AYATAKA-WORKs/AliCe/README.md

# AliCe
This is my micromouse project in 2017 version.

alice
