AYATAKA-WORKs/AliCe/PCB/report.txt

情報: ネットリストファイル "/home/arch/Dropbox/AliCe関連/KiCAD/AliCe/AliCe.net"を読み込んでいます。

情報: コンポーネントとフットプリントの関連付けにリファレンスを使用

エラー:コンポーネント 'P1' フットプリント 'Pin_Header_Straight_2x03' はどのライブラリからも見つけることができませんでした。

エラー:コンポーネント 'P2' フットプリント 'Pin_Header_Straight_2x03' はどのライブラリからも見つけることができませんでした。

エラー:コンポーネント 'Q3' フットプリント 'Pin_Header_Straight_1x02' はどのライブラリからも見つけることができませんでした。

エラー:コンポーネント 'Q4' フットプリント 'Pin_Header_Straight_1x02' はどのライブラリからも見つけることができませんでした。

エラー:コンポーネント 'Q6' フットプリント 'Pin_Header_Straight_1x02' はどのライブラリからも見つけることができませんでした。

エラー:コンポーネント 'Q7' フットプリント 'Pin_Header_Straight_1x02' はどのライブラリからも見つけることができませんでした。

エラー:コンポーネント 'Q11' フットプリント 'Pin_Header_Straight_1x02' はどのライブラリからも見つけることができませんでした。

エラー:コンポーネント 'Q12' フットプリント 'Pin_Header_Straight_1x02' はどのライブラリからも見つけることができませんでした。

エラー:コンポーネント 'M1' フットプリント 'Pin_Header_Straight_1x02' はどのライブラリからも見つけることができませんでした。

エラー:コンポーネント 'D10' フットプリント 'LED-3MM' はどのライブラリからも見つけることができませんでした。

エラー:コンポーネント 'D8' フットプリント 'LED-3MM' はどのライブラリからも見つけることができませんでした。

エラー:コンポーネント 'D7' フットプリント 'LED-3MM' はどのライブラリからも見つけることができませんでした。

エラー:コンポーネント 'D13' フットプリント 'LED-3MM' はどのライブラリからも見つけることができませんでした。

エラー:コンポーネント 'D14' フットプリント 'LED-3MM' はどのライブラリからも見つけることができませんでした。

エラー:コンポーネント 'D9' フットプリント 'LED-3MM' はどのライブラリからも見つけることができませんでした。

情報: ネットリストよりコンポーネントとフットプリントをチェックしています "12.5MHz1:/58FD5DD5:mylib:CRY_4-SMD"。

情報: ネットリストよりコンポーネントとフットプリントをチェックしています "BT1:/56DA9B61:mylib:pin_con_2mm"。

情報: ネットリストよりコンポーネントとフットプリントをチェックしています "C1:/57F95481:Capacitors_SMD:C_0603_HandSoldering"。

情報: ネットリストよりコンポーネントとフットプリントをチェックしています "C2:/58FD1E7C:Capacitors_SMD:C_0603_HandSoldering"。

情報: ネットリストよりコンポーネントとフットプリントをチェックしています "C3:/57FA3C69:Capacitors_SMD:C_0603_HandSoldering"。

情報: ネットリストよりコンポーネントとフットプリントをチェックしています "C4:/57FA5265:Capacitors_SMD:C_0603_HandSoldering"。

情報: ネットリストよりコンポーネントとフットプリントをチェックしています "C5:/56ED1ADF:Capacitors_SMD:C_0603_HandSoldering"。

情報: ネットリストよりコンポーネントとフットプリントをチェックしています "C6:/56ED34AF:Capacitors_SMD:C_0603_HandSoldering"。

情報: ネットリストよりコンポーネントとフットプリントをチェックしています "C7:/56ED9063:Capacitors_SMD:C_0603_HandSoldering"。

情報: ネットリストよりコンポーネントとフットプリントをチェックしています "C8:/56ED9089:Capacitors_SMD:C_0603_HandSoldering"。

情報: ネットリストよりコンポーネントとフットプリントをチェックしています "C9:/57C16474:Capacitors_SMD:C_0603_HandSoldering"。

情報: ネットリストよりコンポーネントとフットプリントをチェックしています "C10:/57C1623D:Capacitors_SMD:C_0603_HandSoldering"。

情報: ネットリストよりコンポーネントとフットプリントをチェックしています "C11:/57BD8294:Capacitors_SMD:C_0603_HandSoldering"。

情報: ネットリストよりコンポーネントとフットプリントをチェックしています "C12:/57BD9CC2:Capacitors_SMD:C_0603_HandSoldering"。

情報: ネットリストよりコンポーネントとフットプリントをチェックしています "C13:/57BD9E56:Capacitors_SMD:C_0603_HandSoldering"。

情報: ネットリストよりコンポーネントとフットプリントをチェックしています "C14:/57BD8D6D:Capacitors_SMD:C_0603_HandSoldering"。

情報: ネットリストよりコンポーネントとフットプリントをチェックしています "C15:/57BF9855:Capacitors_SMD:C_0603_HandSoldering"。

情報: ネットリストよりコンポーネントとフットプリントをチェックしています "C16:/58FCB98C:Capacitors_SMD:C_0603_HandSoldering"。

情報: ネットリストよりコンポーネントとフットプリントをチェックしています "C17:/58FCD29C:Capacitors_SMD:C_0603_HandSoldering"。

情報: ネットリストよりコンポーネントとフットプリントをチェックしています "C18:/58FCB8AB:Capacitors_SMD:C_0603_HandSoldering"。

情報: ネットリストよりコンポーネントとフットプリントをチェックしています "C19:/58FCD375:Capacitors_SMD:C_0603_HandSoldering"。

情報: ネットリストよりコンポーネントとフットプリントをチェックしています "C20:/56EEBB11:Capacitors_SMD:C_0603_HandSoldering"。

情報: ネットリストよりコンポーネントとフットプリントをチェックしています "C21:/56DD16D7:Capacitors_SMD:C_0603_HandSoldering"。

情報: ネットリストよりコンポーネントとフットプリントをチェックしています "C22:/56DD3248:Capacitors_SMD:C_0603_HandSoldering"。

情報: ネットリストよりコンポーネントとフットプリントをチェックしています "C23:/56DD46DA:Capacitors_SMD:C_0603_HandSoldering"。

情報: ネットリストよりコンポーネントとフットプリントをチェックしています "C24:/56EEC4A7:Capacitors_SMD:C_0603_HandSoldering"。

情報: ネットリストよりコンポーネントとフットプリントをチェックしています "C25:/59092574:Capacitors_SMD:C_0603_HandSoldering"。

情報: ネットリストよりコンポーネントとフットプリントをチェックしています "C26:/57E61AE8:Capacitors_SMD:C_0603_HandSoldering"。

情報: ネットリストよりコンポーネントとフットプリントをチェックしています "C27:/57DFF7CD:Capacitors_SMD:C_0603_HandSoldering"。

情報: ネットリストよりコンポーネントとフットプリントをチェックしています "C28:/59093594:Capacitors_SMD:C_0603_HandSoldering"。

情報: ネットリストよりコンポーネントとフットプリントをチェックしています "C29:/5909628D:Capacitors_SMD:C_0603_HandSoldering"。

情報: ネットリストよりコンポーネントとフットプリントをチェックしています "C30:/59097E78:Capacitors_SMD:C_0603_HandSoldering"。

情報: ネットリストよりコンポーネントとフットプリントをチェックしています "C31:/590B0F99:Capacitors_SMD:C_0603_HandSoldering"。

情報: ネットリストよりコンポーネントとフットプリントをチェックしています "C32:/590B09A6:Capacitors_SMD:C_0603_HandSoldering"。

情報: ネットリストよりコンポーネントとフットプリントをチェックしています "C33:/592AC7DC:Capacitors_SMD:C_0603_HandSoldering"。

情報: ネットリストよりコンポーネントとフットプリントをチェックしています "D1:/570CE2A1:LEDs:LED_0603"。

情報: ネットリストよりコンポーネントとフットプリントをチェックしています "D2:/570CF0E6:LEDs:LED_0603"。

情報: ネットリストよりコンポーネントとフットプリントをチェックしています "D3:/570CF27D:LEDs:LED_0603"。

情報: ネットリストよりコンポーネントとフットプリントをチェックしています "D4:/570CF283:LEDs:LED_0603"。

情報: ネットリストよりコンポーネントとフットプリントをチェックしています "D5:/570D2EF1:LEDs:LED_0603"。

情報: ネットリストよりコンポーネントとフットプリントをチェックしています "D6:/570D2EF7:LEDs:LED_0603"。

情報: ネットリストよりコンポーネントとフットプリントをチェックしています "D7:/56EE83C4:LEDs:LED-3MM"。

エラー:新規コンポーネント "D7:/56EE83C4" を作成できませんでした。これは フットプリント  "LEDs:LED-3MM" が不正であることに起因します。

情報: ネットリストよりコンポーネントとフットプリントをチェックしています "D8:/56EEA527:LEDs:LED-3MM"。

エラー:新規コンポーネント "D8:/56EEA527" を作成できませんでした。これは フットプリント  "LEDs:LED-3MM" が不正であることに起因します。

情報: ネットリストよりコンポーネントとフットプリントをチェックしています "D9:/56EEC47E:LEDs:LED-3MM"。

エラー:新規コンポーネント "D9:/56EEC47E" を作成できませんでした。これは フットプリント  "LEDs:LED-3MM" が不正であることに起因します。

情報: ネットリストよりコンポーネントとフットプリントをチェックしています "D10:/56EEC484:LEDs:LED-3MM"。

エラー:新規コンポーネント "D10:/56EEC484" を作成できませんでした。これは フットプリント  "LEDs:LED-3MM" が不正であることに起因します。

情報: ネットリストよりコンポーネントとフットプリントをチェックしています "D11:/57DA538B:LEDs:LED_0603"。

情報: ネットリストよりコンポーネントとフットプリントをチェックしています "D12:/57FED15E:mylib:SOD-128"。

情報: ネットリストよりコンポーネントとフットプリントをチェックしています "D13:/592AC7BE:LEDs:LED-3MM"。

エラー:新規コンポーネント "D13:/592AC7BE" を作成できませんでした。これは フットプリント  "LEDs:LED-3MM" が不正であることに起因します。

情報: ネットリストよりコンポーネントとフットプリントをチェックしています "D14:/592AC7C4:LEDs:LED-3MM"。

エラー:新規コンポーネント "D14:/592AC7C4" を作成できませんでした。これは フットプリント  "LEDs:LED-3MM" が不正であることに起因します。

情報: ネットリストよりコンポーネントとフットプリントをチェックしています "IC1:/57C93978:Housings_SSOP:SSOP-16_4.4x5.2mm_Pitch0.65mm"。

情報: ネットリストよりコンポーネントとフットプリントをチェックしています "IC2:/57C928F6:Housings_SSOP:SSOP-16_4.4x5.2mm_Pitch0.65mm"。

情報: ネットリストよりコンポーネントとフットプリントをチェックしています "IC3:/58FC91FC:mylib:SSOP5-P-0.95"。

情報: ネットリストよりコンポーネントとフットプリントをチェックしています "IC4:/58FC95D9:mylib:SSOP5-P-0.95"。

情報: ネットリストよりコンポーネントとフットプリントをチェックしています "IC6:/56DD266B:Housings_DFN_QFN:QFN-24-1EP_4x4mm_Pitch0.5mm"。

情報: ネットリストよりコンポーネントとフットプリントをチェックしています "M1:/57E10E83:Pin_Headers:Pin_Header_Straight_1x02"。

エラー:新規コンポーネント "M1:/57E10E83" を作成できませんでした。これは フットプリント  "Pin_Headers:Pin_Header_Straight_1x02" が不正であることに起因します。

情報: ネットリストよりコンポーネントとフットプリントをチェックしています "P1:/56ED90B1:Pin_Headers:Pin_Header_Straight_2x03"。

エラー:新規コンポーネント "P1:/56ED90B1" を作成できませんでした。これは フットプリント  "Pin_Headers:Pin_Header_Straight_2x03" が不正であることに起因します。

情報: ネットリストよりコンポーネントとフットプリントをチェックしています "P2:/56ED6942:Pin_Headers:Pin_Header_Straight_2x03"。

エラー:新規コンポーネント "P2:/56ED6942" を作成できませんでした。これは フットプリント  "Pin_Headers:Pin_Header_Straight_2x03" が不正であることに起因します。

情報: ネットリストよりコンポーネントとフットプリントをチェックしています "P3:/58FD90F5:Pin_Headers:Pin_Header_Straight_1x04_Pitch2.54mm"。

情報: ネットリストよりコンポーネントとフットプリントをチェックしています "Q1:/57E1864D:mylib:SOT-363"。

情報: ネットリストよりコンポーネントとフットプリントをチェックしています "Q2:/57ED4785:TO_SOT_Packages_SMD:SOT-23"。

情報: ネットリストよりコンポーネントとフットプリントをチェックしています "Q3:/57E13A56:Pin_Headers:Pin_Header_Straight_1x02"。

エラー:新規コンポーネント "Q3:/57E13A56" を作成できませんでした。これは フットプリント  "Pin_Headers:Pin_Header_Straight_1x02" が不正であることに起因します。

情報: ネットリストよりコンポーネントとフットプリントをチェックしています "Q4:/57E13975:Pin_Headers:Pin_Header_Straight_1x02"。

エラー:新規コンポーネント "Q4:/57E13975" を作成できませんでした。これは フットプリント  "Pin_Headers:Pin_Header_Straight_1x02" が不正であることに起因します。

情報: ネットリストよりコンポーネントとフットプリントをチェックしています "Q5:/56EEB1DF:mylib:SOT-723"。

情報: ネットリストよりコンポーネントとフットプリントをチェックしています "Q6:/57E13892:Pin_Headers:Pin_Header_Straight_1x02"。

エラー:新規コンポーネント "Q6:/57E13892" を作成できませんでした。これは フットプリント  "Pin_Headers:Pin_Header_Straight_1x02" が不正であることに起因します。

情報: ネットリストよりコンポーネントとフットプリントをチェックしています "Q7:/57E10C8B:Pin_Headers:Pin_Header_Straight_1x02"。

エラー:新規コンポーネント "Q7:/57E10C8B" を作成できませんでした。これは フットプリント  "Pin_Headers:Pin_Header_Straight_1x02" が不正であることに起因します。

情報: ネットリストよりコンポーネントとフットプリントをチェックしています "Q8:/56EEC490:mylib:SOT-723"。

情報: ネットリストよりコンポーネントとフットプリントをチェックしています "Q9:/57FEC28D:TO_SOT_Packages_SMD:SOT-23"。

情報: ネットリストよりコンポーネントとフットプリントをチェックしています "Q10:/592AC7D0:mylib:SOT-723"。

情報: ネットリストよりコンポーネントとフットプリントをチェックしています "Q11:/5935AB5D:Pin_Headers:Pin_Header_Straight_1x02"。

エラー:新規コンポーネント "Q11:/5935AB5D" を作成できませんでした。これは フットプリント  "Pin_Headers:Pin_Header_Straight_1x02" が不正であることに起因します。

情報: ネットリストよりコンポーネントとフットプリントをチェックしています "Q12:/5935AC78:Pin_Headers:Pin_Header_Straight_1x02"。

エラー:新規コンポーネント "Q12:/5935AC78" を作成できませんでした。これは フットプリント  "Pin_Headers:Pin_Header_Straight_1x02" が不正であることに起因します。

情報: ネットリストよりコンポーネントとフットプリントをチェックしています "R1:/570CF2BC:mylib:R_0402_HandSoldering"。

情報: ネットリストよりコンポーネントとフットプリントをチェックしています "R2:/570CF3B4:mylib:R_0402_HandSoldering"。

情報: ネットリストよりコンポーネントとフットプリントをチェックしています "R3:/570CF46E:mylib:R_0402_HandSoldering"。

情報: ネットリストよりコンポーネントとフットプリントをチェックしています "R4:/570CF474:mylib:R_0402_HandSoldering"。

情報: ネットリストよりコンポーネントとフットプリントをチェックしています "R5:/570D2EFD:mylib:R_0402_HandSoldering"。

情報: ネットリストよりコンポーネントとフットプリントをチェックしています "R6:/570D2F03:mylib:R_0402_HandSoldering"。

情報: ネットリストよりコンポーネントとフットプリントをチェックしています "R7:/572A3DC4:mylib:R_0402_HandSoldering"。

情報: ネットリストよりコンポーネントとフットプリントをチェックしています "R8:/572A516A:mylib:R_0402_HandSoldering"。

情報: ネットリストよりコンポーネントとフットプリントをチェックしています "R9:/56DAA956:mylib:R_0402_HandSoldering"。

情報: ネットリストよりコンポーネントとフットプリントをチェックしています "R10:/5712AFBF:mylib:R_0402_HandSoldering"。

情報: ネットリストよりコンポーネントとフットプリントをチェックしています "R11:/57BDC9FF:mylib:R_0402_HandSoldering"。

情報: ネットリストよりコンポーネントとフットプリントをチェックしています "R12:/570FAF51:mylib:R_0402_HandSoldering"。

情報: ネットリストよりコンポーネントとフットプリントをチェックしています "R13:/570FC62C:mylib:R_0402_HandSoldering"。

情報: ネットリストよりコンポーネントとフットプリントをチェックしています "R14:/57BDFF90:mylib:R_0402_HandSoldering"。

情報: ネットリストよりコンポーネントとフットプリントをチェックしています "R15:/57287DB5:mylib:R_0402_HandSoldering"。

情報: ネットリストよりコンポーネントとフットプリントをチェックしています "R16:/570C46C4:mylib:R_0402_HandSoldering"。

情報: ネットリストよりコンポーネントとフットプリントをチェックしています "R17:/56EEB403:mylib:R_0402_HandSoldering"。

情報: ネットリストよりコンポーネントとフットプリントをチェックしています "R18:/570C4D8F:mylib:R_0402_HandSoldering"。

情報: ネットリストよりコンポーネントとフットプリントをチェックしています "R19:/56EEB188:mylib:R_0402_HandSoldering"。

情報: ネットリストよりコンポーネントとフットプリントをチェックしています "R20:/570C4E91:mylib:R_0402_HandSoldering"。

情報: ネットリストよりコンポーネントとフットプリントをチェックしています "R21:/570C4E9D:mylib:R_0402_HandSoldering"。

情報: ネットリストよりコンポーネントとフットプリントをチェックしています "R22:/56EEC496:mylib:R_0402_HandSoldering"。

情報: ネットリストよりコンポーネントとフットプリントをチェックしています "R23:/56EEC48A:mylib:R_0402_HandSoldering"。

情報: ネットリストよりコンポーネントとフットプリントをチェックしています "R24:/57C4CFED:mylib:check_2pin_1.6mm"。

情報: ネットリストよりコンポーネントとフットプリントをチェックしています "R25:/57C4D78C:mylib:check_2pin_1.6mm"。

情報: ネットリストよりコンポーネントとフットプリントをチェックしています "R26:/57D6A2AA:mylib:R_0402_HandSoldering"。

情報: ネットリストよりコンポーネントとフットプリントをチェックしています "R27:/590A9E03:mylib:R_0402_HandSoldering"。

情報: ネットリストよりコンポーネントとフットプリントをチェックしています "R28:/57E1098C:mylib:R_0402_HandSoldering"。

情報: ネットリストよりコンポーネントとフットプリントをチェックしています "R29:/57DF343D:mylib:R_0402_HandSoldering"。

情報: ネットリストよりコンポーネントとフットプリントをチェックしています "R30:/57E01173:mylib:R_0402_HandSoldering"。

情報: ネットリストよりコンポーネントとフットプリントをチェックしています "R31:/57DA477E:mylib:R_0402_HandSoldering"。

情報: ネットリストよりコンポーネントとフットプリントをチェックしています "R32:/590A9906:mylib:R_0402_HandSoldering"。

情報: ネットリストよりコンポーネントとフットプリントをチェックしています "R33:/590B07FD:mylib:R_0402_HandSoldering"。

情報: ネットリストよりコンポーネントとフットプリントをチェックしています "R34:/592AC7D6:mylib:R_0402_HandSoldering"。

情報: ネットリストよりコンポーネントとフットプリントをチェックしています "R35:/592AC7CA:mylib:R_0402_HandSoldering"。

情報: ネットリストよりコンポーネントとフットプリントをチェックしています "R36:/5935BA0F:mylib:R_0402_HandSoldering"。

情報: ネットリストよりコンポーネントとフットプリントをチェックしています "R37:/5935B88E:mylib:R_0402_HandSoldering"。

情報: ネットリストよりコンポーネントとフットプリントをチェックしています "SP1:/57BEC4ED:mylib:UGCT7525AN4"。

情報: ネットリストよりコンポーネントとフットプリントをチェックしています "SW1:/5906DA65:mylib:JS203011AQN"。

情報: ネットリストよりコンポーネントとフットプリントをチェックしています "SW2:/57BD595B:mylib:PTS810"。

情報: ネットリストよりコンポーネントとフットプリントをチェックしています "SW4:/57E012DE:mylib:PTS810"。

情報: ネットリストよりコンポーネントとフットプリントをチェックしています "U1:/57C917C3:Housings_QFP:LQFP-64_10x10mm_Pitch0.5mm"。

情報: ネットリストよりコンポーネントとフットプリントをチェックしています "U2:/5908FD99:mylib:ER-OLED010-1"。
