AYATAKA-WORKs/AliCe/3DCAD/シルク案①_s_anti.png

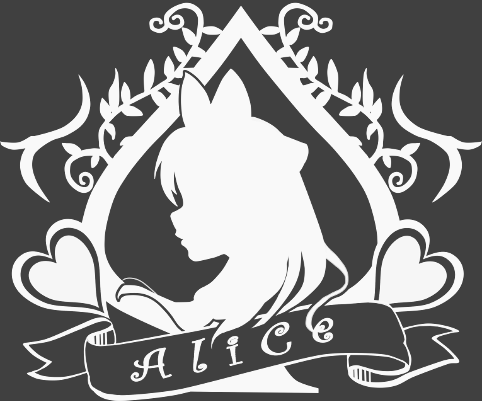
3DCAD/シルク案①_s_anti.png
