AYATAKA-WORKs/AliCe/PCB/PWRベタ_表.PNG

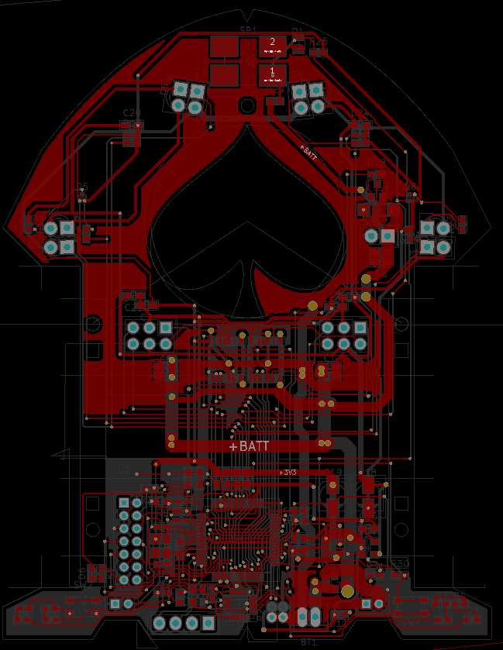
PCB/PWRベタ_表.PNG
