AYATAKA-WORKs/AliCe/PCB/ベタ_表.PNG

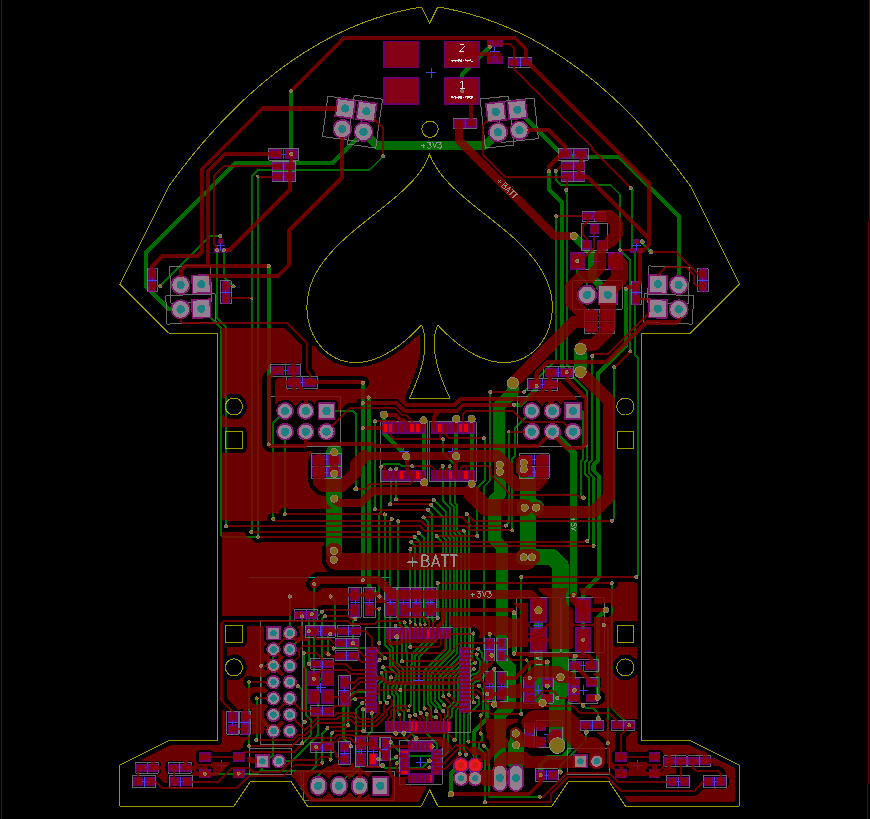
PCB/ベタ_表.PNG
