AYATAKA-WORKs/AliCe/PCB/ベタ_裏.PNG

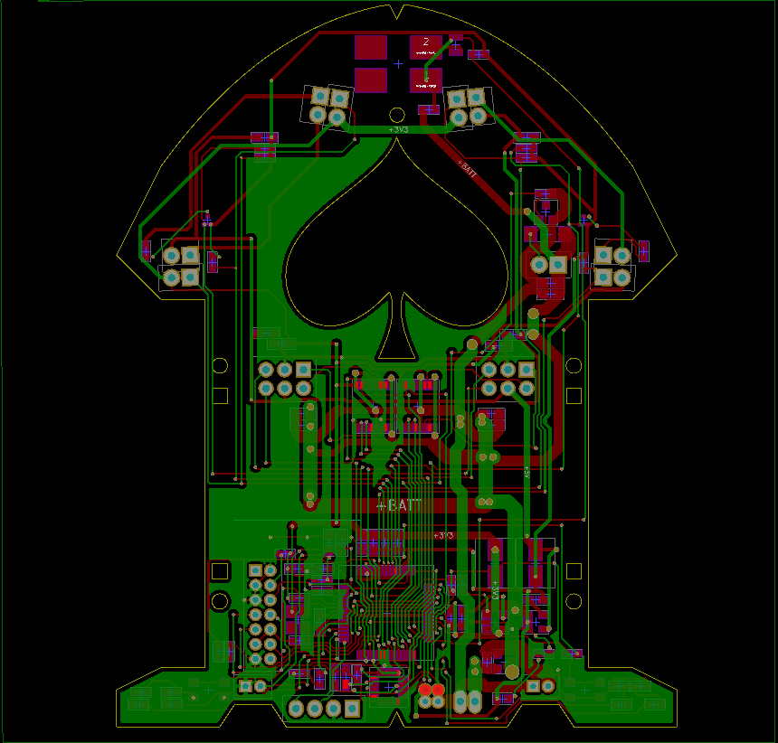
PCB/ベタ_裏.PNG
