AYATAKA-WORKs/AliCe/PCB/部品表.docx

Reference | Value | Footprint
BT1 | Battery | mylib:pin_con_2mm | □
C01 | 47u | Capacitors_SMD:C_0603_HandSoldering | □
C02 | 47u | Capacitors_SMD:C_0603_HandSoldering | □
C03 | 10u | Capacitors_SMD:C_0603_HandSoldering | □
C04 | 10u | Capacitors_SMD:C_0603_HandSoldering | □
C05 | 0.1u | Capacitors_SMD:C_0603_HandSoldering | □
C06 | 0.1u | Capacitors_SMD:C_0603_HandSoldering | □
C07 | 0.1u | Capacitors_SMD:C_0603_HandSoldering | □
C08 | 0.1u | Capacitors_SMD:C_0603_HandSoldering | □
C09 | 0.1u | Capacitors_SMD:C_0603_HandSoldering | □
C10 | 0.1u | Capacitors_SMD:C_0603_HandSoldering | □
C11 | 0.1u | Capacitors_SMD:C_0603_HandSoldering | □
C12 | 8p | Capacitors_SMD:C_0603_HandSoldering | □
C13 | 8p | Capacitors_SMD:C_0603_HandSoldering | □
C14 | 0.1u | Capacitors_SMD:C_0603_HandSoldering | □
C15 | 0.1u | Capacitors_SMD:C_0603_HandSoldering | □
C16 | 470p | Capacitors_SMD:C_0603_HandSoldering | □
C17 | 470p | Capacitors_SMD:C_0603_HandSoldering | □
C18 | 2.2u | mylib:c_elec_4x3.0 | □
C19 | 2.2u | mylib:c_elec_4x3.0 | □
C20 | 4.7u | Capacitors_SMD:C_0603_HandSoldering | □
C21 | 2.2n | Capacitors_SMD:C_0603_HandSoldering | □
C22 | 0.1u | Capacitors_SMD:C_0603_HandSoldering | □
C23 | 0.1u | Capacitors_SMD:C_0603_HandSoldering | □
C24 | 4.7u | Capacitors_SMD:C_0603_HandSoldering | □
C25 | 47u | Capacitors_SMD:C_0603_HandSoldering | □
C26 | 0.1u | Capacitors_SMD:C_0603_HandSoldering | □
C27 | 0.1u | Capacitors_SMD:C_0603_HandSoldering | □
D01 | LED | LEDs:LED_0603 | □
D02 | LED | LEDs:LED_0603 | □
D03 | LED | LEDs:LED_0603 | □
D04 | LED | LEDs:LED_0603 | □
D05 | LED | LEDs:LED_0603 | □
D06 | LED | LEDs:LED_0603 | □
D07 | SFH4550 | LEDs:LED-3MM | □
D08 | SFH4550 | LEDs:LED-3MM | □
D09 | SFH4550 | LEDs:LED-3MM | □
D10 | SFH4550 | LEDs:LED-3MM | □
D11 | LED | LEDs:LED_0603 | □
D12 | Schottky | mylib:SOD-128 | □
IC1 | TB6614FNG | Housings_SSOP:SSOP-16_4.4x5.2mm_Pitch0.65mm | □
IC2 | TB6614FNG | Housings_SSOP:SSOP-16_4.4x5.2mm_Pitch0.65mm | □
IC4 | MIC5129 | TO_SOT_Packages_SMD:SOT-23-5 | □
IC5 | MIC5129 | TO_SOT_Packages_SMD:SOT-23-5 | □
IC6 | MPU-6000 | Housings_DFN_QFN:QFN-24-1EP_4x4mm_Pitch0.5mm | □
M1 | DC_MOTOR | Pin_Headers:Pin_Header_Straight_1x02 | □
P1 | CONN_02X03 | Pin_Headers:Pin_Header_Straight_2x03 | □
P2 | CONN_02X03 | Pin_Headers:Pin_Header_Straight_2x03 | □
Q1 | NMSD200B01 | mylib:SOT-363 | □
Q2 | SSM3J328RLFCT | TO_SOT_Packages_SMD:SOT-23 | □
Q3 | ST-1KL3A | Pin_Headers:Pin_Header_Straight_1x02 | □
Q4 | ST-1KL3A | Pin_Headers:Pin_Header_Straight_1x02 | □
Q5 | RUM003N02 | mylib:SOT-723 | □
Q6 | ST-1KL3A | Pin_Headers:Pin_Header_Straight_1x02 | □
Q7 | ST-1KL3A | Pin_Headers:Pin_Header_Straight_1x02 | □
Q8 | RUM003N02 | mylib:SOT-723 | □
Q9 | SSM3K329R | TO_SOT_Packages_SMD:SOT-23 | □
R01 | 100 | mylib:R_0402_HandSoldering | □
R02 | 100 | mylib:R_0402_HandSoldering | □
R03 | 100 | mylib:R_0402_HandSoldering | □
R04 | 100 | mylib:R_0402_HandSoldering | □
R05 | 100 | mylib:R_0402_HandSoldering | □
R06 | 100 | mylib:R_0402_HandSoldering | □
R07 | 10k | mylib:R_0402_HandSoldering | □
R08 | 10k | mylib:R_0402_HandSoldering | □
R09 | 10k | mylib:R_0402_HandSoldering | □
R10 | 10k | mylib:R_0402_HandSoldering | □
R11 | 10k | mylib:R_0402_HandSoldering | □
R12 | R | mylib:R_0402_HandSoldering | □
R13 | R | mylib:R_0402_HandSoldering | □
R14 | 10k | mylib:R_0402_HandSoldering | □
R15 | 10k | mylib:R_0402_HandSoldering | □
R16 | 1k | mylib:R_0402_HandSoldering | □
R17 | 10k | mylib:R_0402_HandSoldering | □
R18 | 1k | mylib:R_0402_HandSoldering | □
R19 | 20 | mylib:R_0402_HandSoldering | □
R20 | 1k | mylib:R_0402_HandSoldering | □
R21 | 1k | mylib:R_0402_HandSoldering | □
R22 | 10k | mylib:R_0402_HandSoldering | □
R23 | 20 | mylib:R_0402_HandSoldering | □
R24 | 0 | mylib:check_2pin_1.6mm | □
R25 | 0 | mylib:check_2pin_1.6mm | □
R26 | 47k | mylib:R_0402_HandSoldering | □
R27 | 100 | mylib:R_0402_HandSoldering | □
R28 | 47k | mylib:R_0402_HandSoldering | □
R29 | 10 | mylib:R_0402_HandSoldering | □
R30 | 10k | mylib:R_0402_HandSoldering | □
R31 | 1k | mylib:R_0402_HandSoldering | □
SP1 | UGCT7525NA4 | mylib:UGCT7525AN4 | □
SW2 | PUSH_SW_s | mylib:PTS810 | □
SW3 | SPST | Pin_Headers:Pin_Header_Straight_1x02_Pitch2.00mm | □
SW4 | PUSH_SW_s | mylib:PTS810 | □
U1 | RX631 | Housings_QFP:LQFP-64_10x10mm_Pitch0.5mm | □
U2 | Z144SN005 | Pin_Headers:Pin_Header_Straight_2x07_Pitch2.00mm | □
