AYATAKA-WORKs/AliCe/3DCAD/kiban.dxf

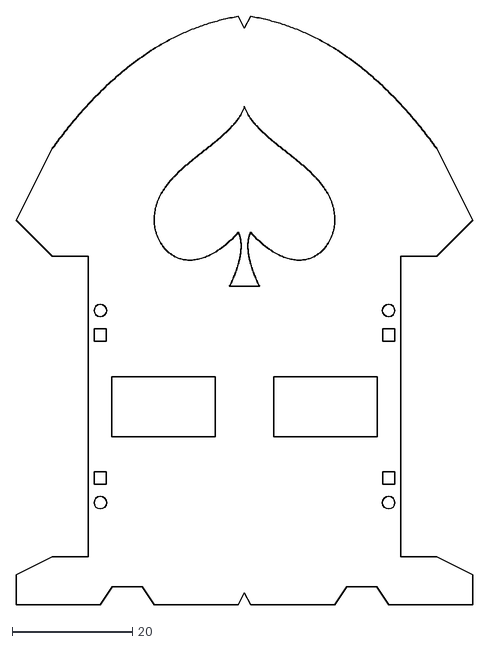
[picture p5: CAD file, 2018-06-24]
3DCAD/kiban.dxf
76.0 x 98.0
