AYATAKA-WORKs/AliCe/PCB/kiban_correction.dxf

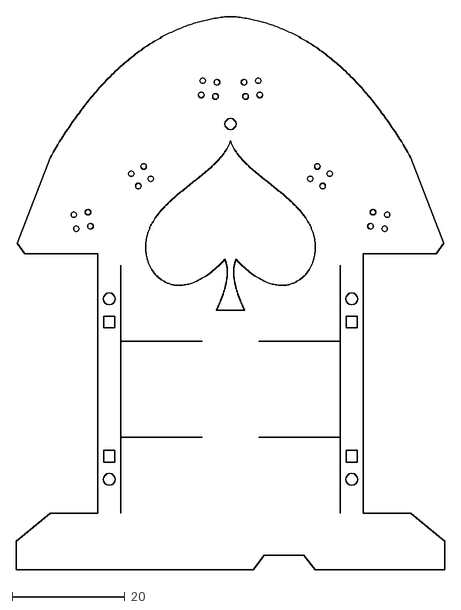
[picture p6: CAD file, 2018-06-24]
PCB/kiban_correction.dxf
76.0 x 98.1
