AYATAKA-WORKs/AliCe/3DCAD/m_mount_side.dxf

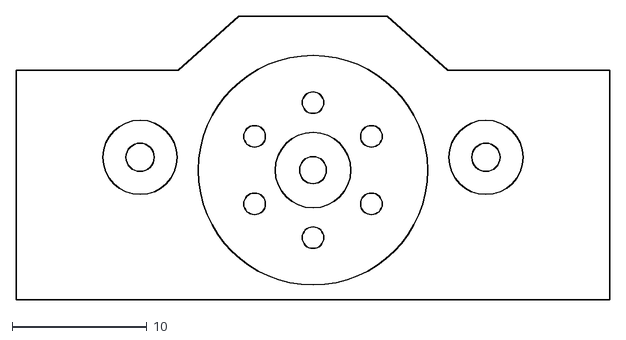
[picture p7: CAD file, 2018-06-24]
3DCAD/m_mount_side.dxf
44.0 x 21.0
