AYATAKA-WORKs/AliCe/PCB/kiban.dxf

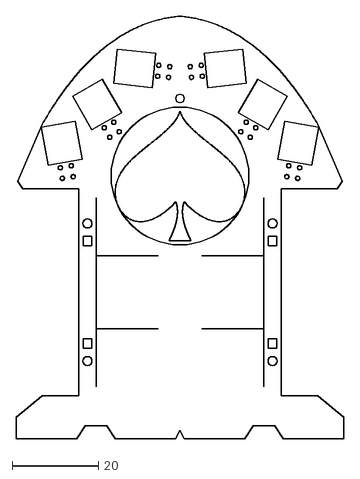
[picture p8: CAD file, 2018-06-24]
PCB/kiban.dxf
76.0 x 98.1
