AYATAKA-WORKs/AliCe/3DCAD/Alice.stl

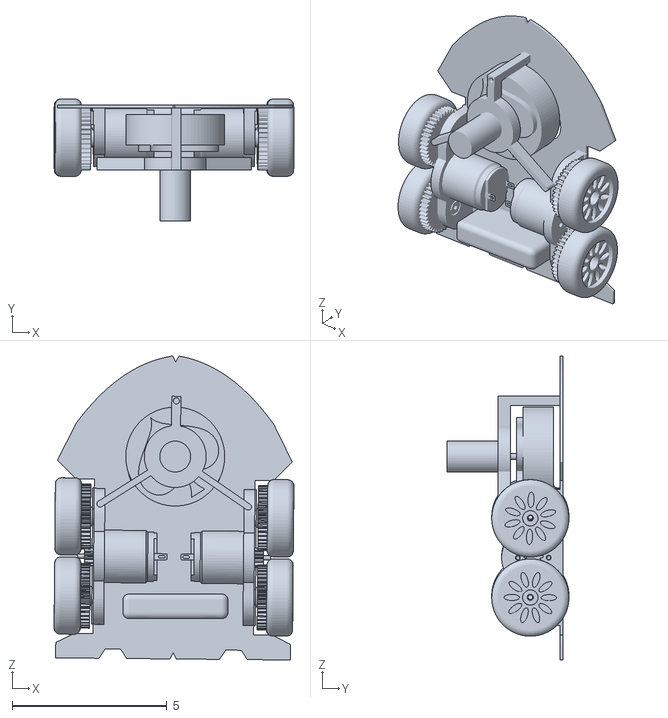
[picture p9: CAD file, 2018-06-24]
3DCAD/Alice.stl
7.76 x 3.94 x 9.83
