AYATAKA-WORKs/AliCe/PCB/LCD_kiban.dxf

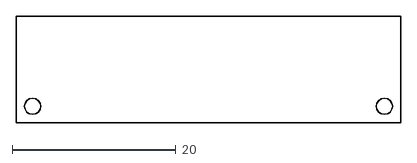
[picture p10: CAD file, 2018-06-24]
PCB/LCD_kiban.dxf
47.0 x 13.0
