AYATAKA-WORKs/AliCe/3DCAD/m_mount_down.dxf

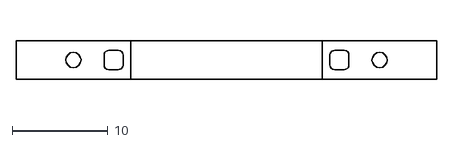
[picture p11: CAD file, 2018-06-24]
3DCAD/m_mount_down.dxf
44.0 x 4.00
