AYATAKA-WORKs/AliCe/3DCAD/m_mount_up.dxf

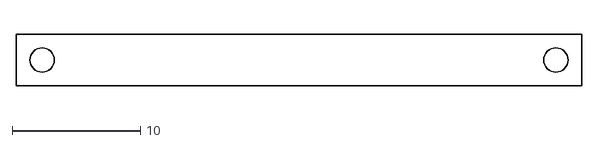
[picture p12: CAD file, 2018-06-24]
3DCAD/m_mount_up.dxf
44.0 x 4.00
