AYATAKA-WORKs/AliCe/3DCAD/k_mount.dxf

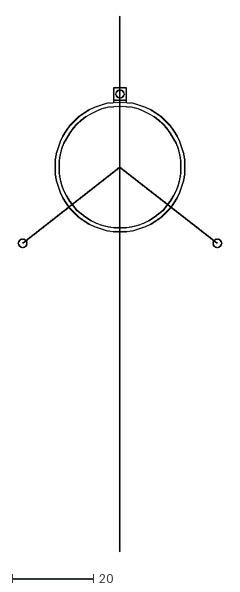
[picture p13: CAD file, 2018-06-24]
3DCAD/k_mount.dxf
50.1 x 132.1
