AYATAKA-WORKs/AliCe/3DCAD/spade.dxf

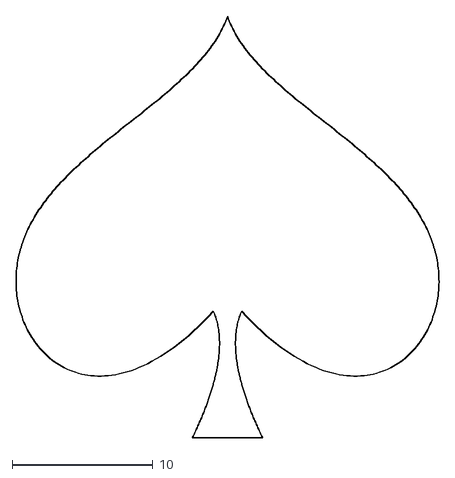
[picture p14: CAD file, 2018-06-24]
3DCAD/spade.dxf
30.1 x 30.0
