AYATAKA-WORKs/AliCe/(list of files, cad)

Other CAD files:
Src/AliCe/HardwareDebug/generate/hwsetup.obj
Src/AliCe/HardwareDebug/src/gyro.obj
Src/AliCe/HardwareDebug/generate/resetprg.obj
Src/AliCe/HardwareDebug/src/Control.obj
Src/AliCe/HardwareDebug/generate/intprg.obj
Src/AliCe/HardwareDebug/src/Maze.obj
Src/AliCe/HardwareDebug/generate/sbrk.obj
Src/AliCe/HardwareDebug/src/Motor.obj
Src/AliCe/HardwareDebug/generate/vecttbl.obj
Src/AliCe/HardwareDebug/src/interrupt.obj
Src/AliCe/HardwareDebug/generate/dbsct.obj
Src/AliCe/HardwareDebug/src/parameter.obj
Src/AliCe/HardwareDebug/src/initClock.obj
Src/AliCe/HardwareDebug/src/speaker_func.obj
Src/AliCe/HardwareDebug/src/var.obj
Src/AliCe/HardwareDebug/src/initNonExistentPort.obj
Src/AliCe/HardwareDebug/src/run.obj
Src/AliCe/HardwareDebug/src/Encoder.obj
Src/AliCe/HardwareDebug/src/PhotoSensor.obj
Src/AliCe/HardwareDebug/src/initSetting.obj
Src/AliCe/HardwareDebug/src/initStopModule.obj
Src/AliCe/HardwareDebug/src/Log.obj
Src/AliCe/HardwareDebug/src/AliCe.obj
Src/AliCe/HardwareDebug/src/Serial.obj
3DCAD/1717.ipt
3DCAD/AliCe_Motor.iam
3DCAD/AliCe_Motor/デザイン アクセラレータ/OldVersions/平歯車21.0002.ipt
3DCAD/AliCe_Motor/デザイン アクセラレータ/平歯車1.iam
3DCAD/AliCe_Motor/デザイン アクセラレータ/平歯車11.ipt
3DCAD/AliCe_Motor/デザイン アクセラレータ/平歯車14.ipt
3DCAD/AliCe_Motor/デザイン アクセラレータ/平歯車21.ipt
3DCAD/AliCe_Motor/デザイン アクセラレータ/平歯車22.ipt
3DCAD/AliCe_Motor_R.iam
3DCAD/AliCe_Motor_l.iam
3DCAD/AliCe_TFT.iam
3DCAD/Alice._new.iam
3DCAD/Alice.iam
3DCAD/Assembly1.iam
3DCAD/Back.ipt
3DCAD/LCD.iam
3DCAD/LED.ipt
3DCAD/LED_mount.ipt
3DCAD/LiPo.ipt
3DCAD/New_Alice.iam
3DCAD/OldVersions/1717.0006.ipt
3DCAD/OldVersions/AliCe_Motor.0047.iam
3DCAD/OldVersions/AliCe_Motor_l.0001.iam
3DCAD/OldVersions/AliCe_TFT.0002.iam
3DCAD/OldVersions/Alice.0032.iam
3DCAD/OldVersions/Alice._new.0044.iam
3DCAD/OldVersions/Assembly1.0019.iam
3DCAD/OldVersions/Back.0001.ipt
3DCAD/OldVersions/LCD.0005.iam
3DCAD/OldVersions/LED_mount.0014.ipt
3DCAD/OldVersions/LiPo.0008.ipt
3DCAD/OldVersions/Part1.0001.ipt
3DCAD/OldVersions/Part3.0001.ipt
3DCAD/OldVersions/TFT.0003.ipt
3DCAD/OldVersions/TFT_case.0009.ipt
3DCAD/OldVersions/TFT_mount.0003.ipt
3DCAD/OldVersions/Tire.0004.ipt
3DCAD/OldVersions/Wheel.0009.ipt
3DCAD/OldVersions/kiban.0003.ipt
3DCAD/OldVersions/m_mount.0028.ipt
3DCAD/OldVersions/m_mount_l.0001.ipt
3DCAD/OldVersions/m_mount_l.0003.ipt
3DCAD/OldVersions/m_mount_r.0023.ipt
3DCAD/OldVersions/motormt.0003.ipt
3DCAD/OldVersions/motormt.0009.ipt
3DCAD/OldVersions/mount2.0019.ipt
3DCAD/OldVersions/s_fan.0025.ipt
3DCAD/OldVersions/s_motor.0004.ipt
3DCAD/OldVersions/s_mount.0025.ipt
3DCAD/OldVersions/s_mount.0035.ipt
3DCAD/OldVersions/shitaita.0044.ipt
3DCAD/OldVersions/shitaita_new.0033.ipt
3DCAD/OldVersions/シムリング.0003.ipt
3DCAD/OldVersions/シムリング.0005.ipt
3DCAD/OldVersions/スパーギア.0003.ipt
3DCAD/OldVersions/ナット.0001.ipt
3DCAD/OldVersions/ピニオンギア.0001.ipt
3DCAD/OldVersions/ベアリング.0003.ipt
3DCAD/Part1.ipt
3DCAD/TFT.ipt
3DCAD/TFT_case.ipt
3DCAD/TFT_kiban.ipt
3DCAD/TFT_mount.ipt
3DCAD/Tire.ipt
3DCAD/Wheel.ipt
3DCAD/kiban.ipt
3DCAD/m_mount.ipt
3DCAD/m_mount_l.ipt
3DCAD/m_mount_r.ipt
3DCAD/monitor.ipt
3DCAD/mount2.ipt
3DCAD/panel.ipt
3DCAD/s_fan.ipt
3DCAD/s_motor.ipt
3DCAD/s_mount.ipt
3DCAD/shitaita.ipt
3DCAD/shitaita_new.ipt
3DCAD/シムリング.ipt
3DCAD/スパーギア.ipt
3DCAD/ナット.ipt
3DCAD/ピニオンギア.ipt
3DCAD/ベアリング.ipt
PCB/OldVersions/kiban.0002.ipt
PCB/kiban.ipt
