AYATAKA-WORKs/AliCe/PCB/AliCe.pdf

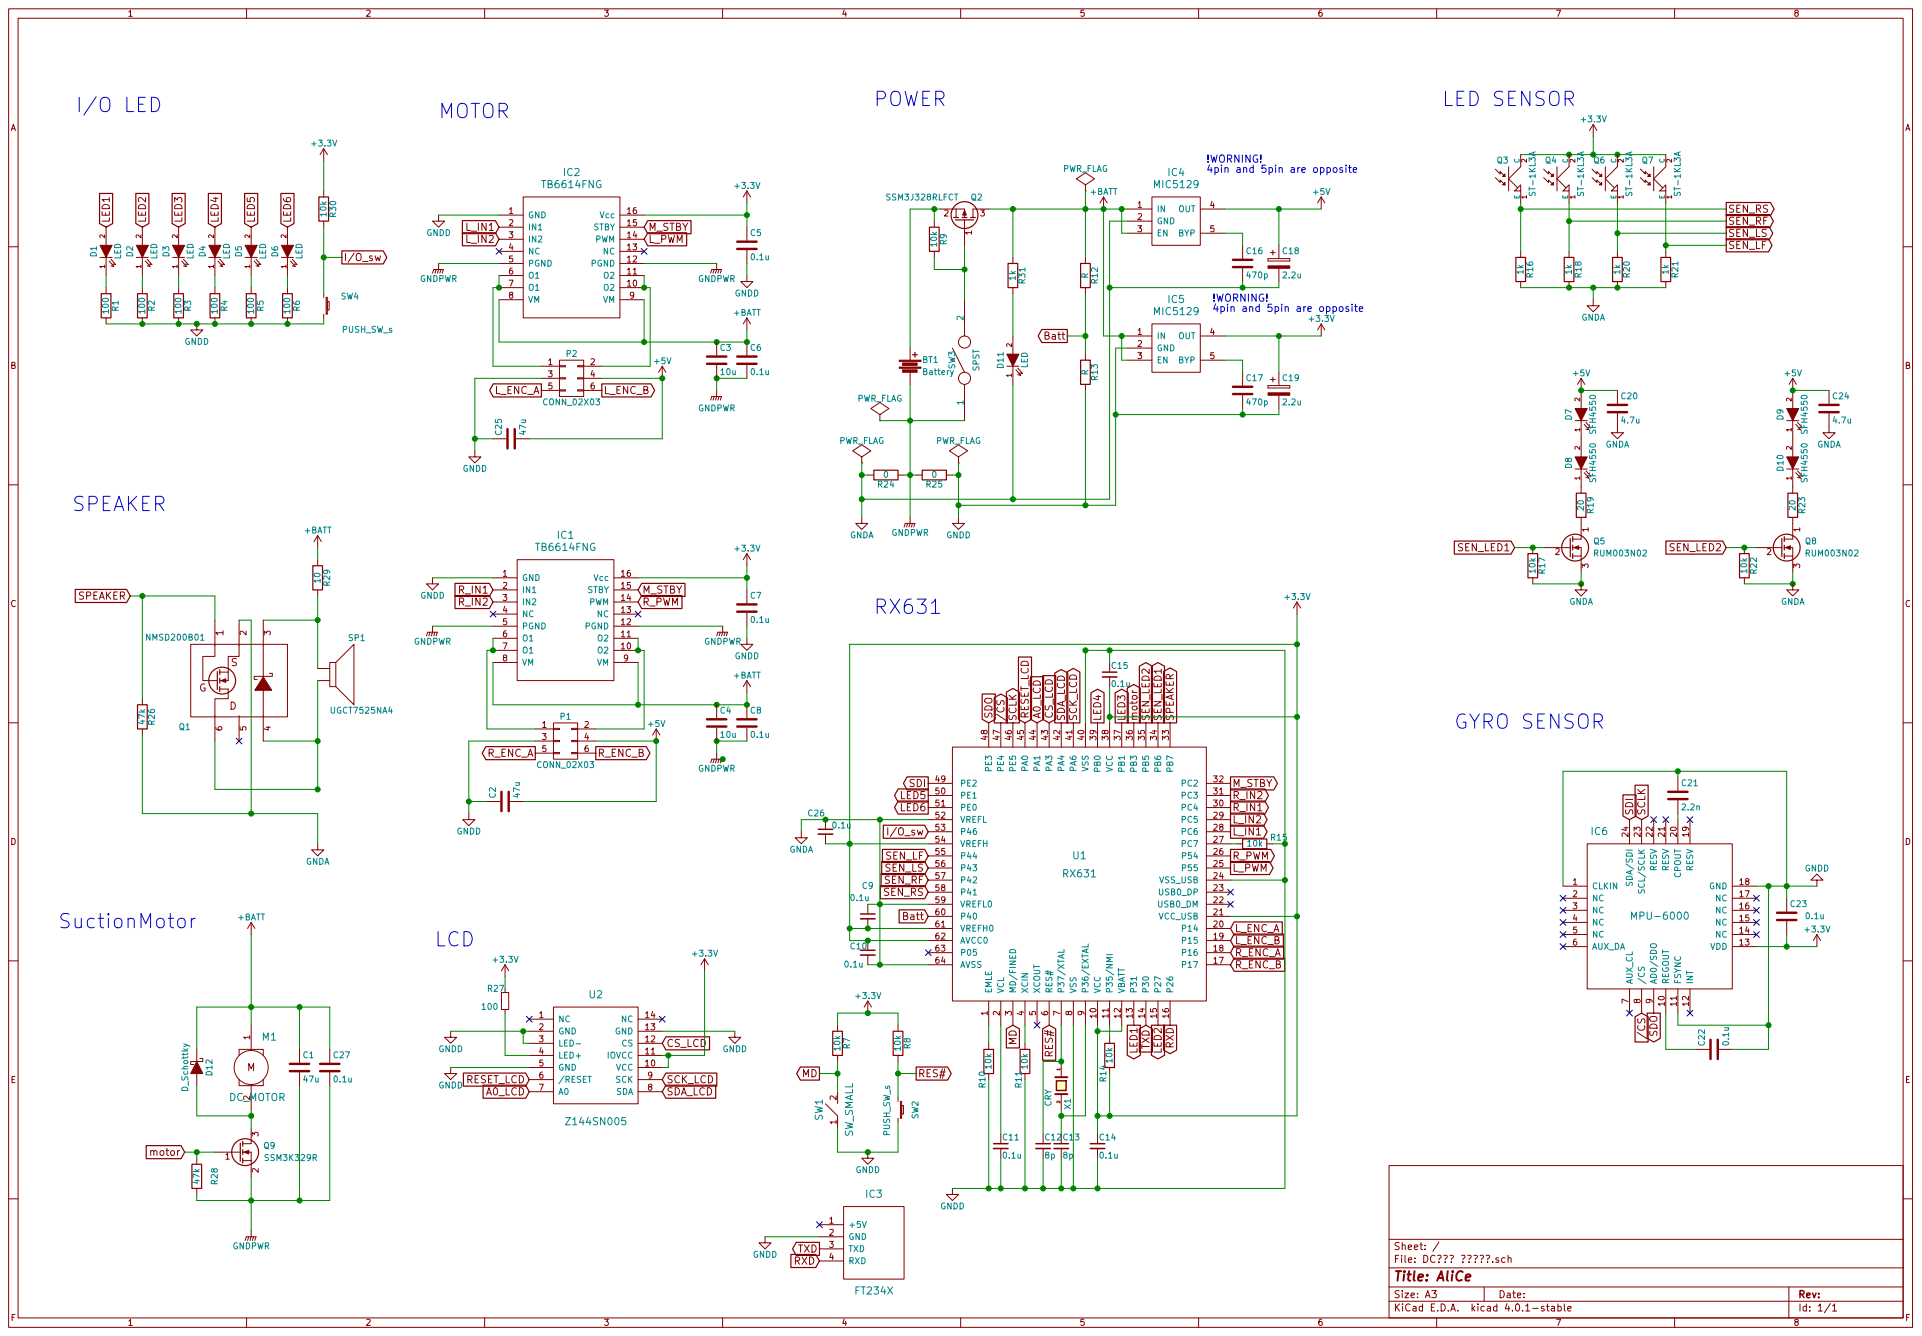
[picture p15: page 1]

1 2 D11 LED GNDA GNDA GNDA

9 VCC 10 P14 20 PC4 30 VSS 40 PE1 50 P40 60 P35/NMI 11 VCC_USB 21 PC3 31 PA6 41 PE0 51 VREFH0 61 VBATT 12 USB0_DM 22 PC2 32 PA4 42 VREFL 52 AVCC0 62 P31 13 USB0_DP 23 PB7 33 PA3 43 P46 53 P05 63 P30 14 VSS_USB 24 PB6 34 PA1 44 VREFH 54 AVSS 64 P27 15 P55 25 PB5 35 PA0 45 P44 55 P26 16 P54 26 PB3 36 PE5 46 P43 56 P17 17 PC7 27 PB1 37 PE4 47 P42 57 P16 18 PC6 28 VCC 38 PE3 48 P41 58 P15 19 PC5 29 PB0 39 PE2 49 VREFL0 59 U1 RX631

9 REGOUT 10 CPOUT 20 FSYNC 11 RESV 21 INT 12 RESV 22 VDD

File: DC .sch Sheet: /
Id: 1/1 Title: AliCe
