AYATAKA-WORKs/AliCe/PCB/AliCe.kicad_pcb

## KiCad design PCB/AliCe.kicad_pcb (2018-06-24)

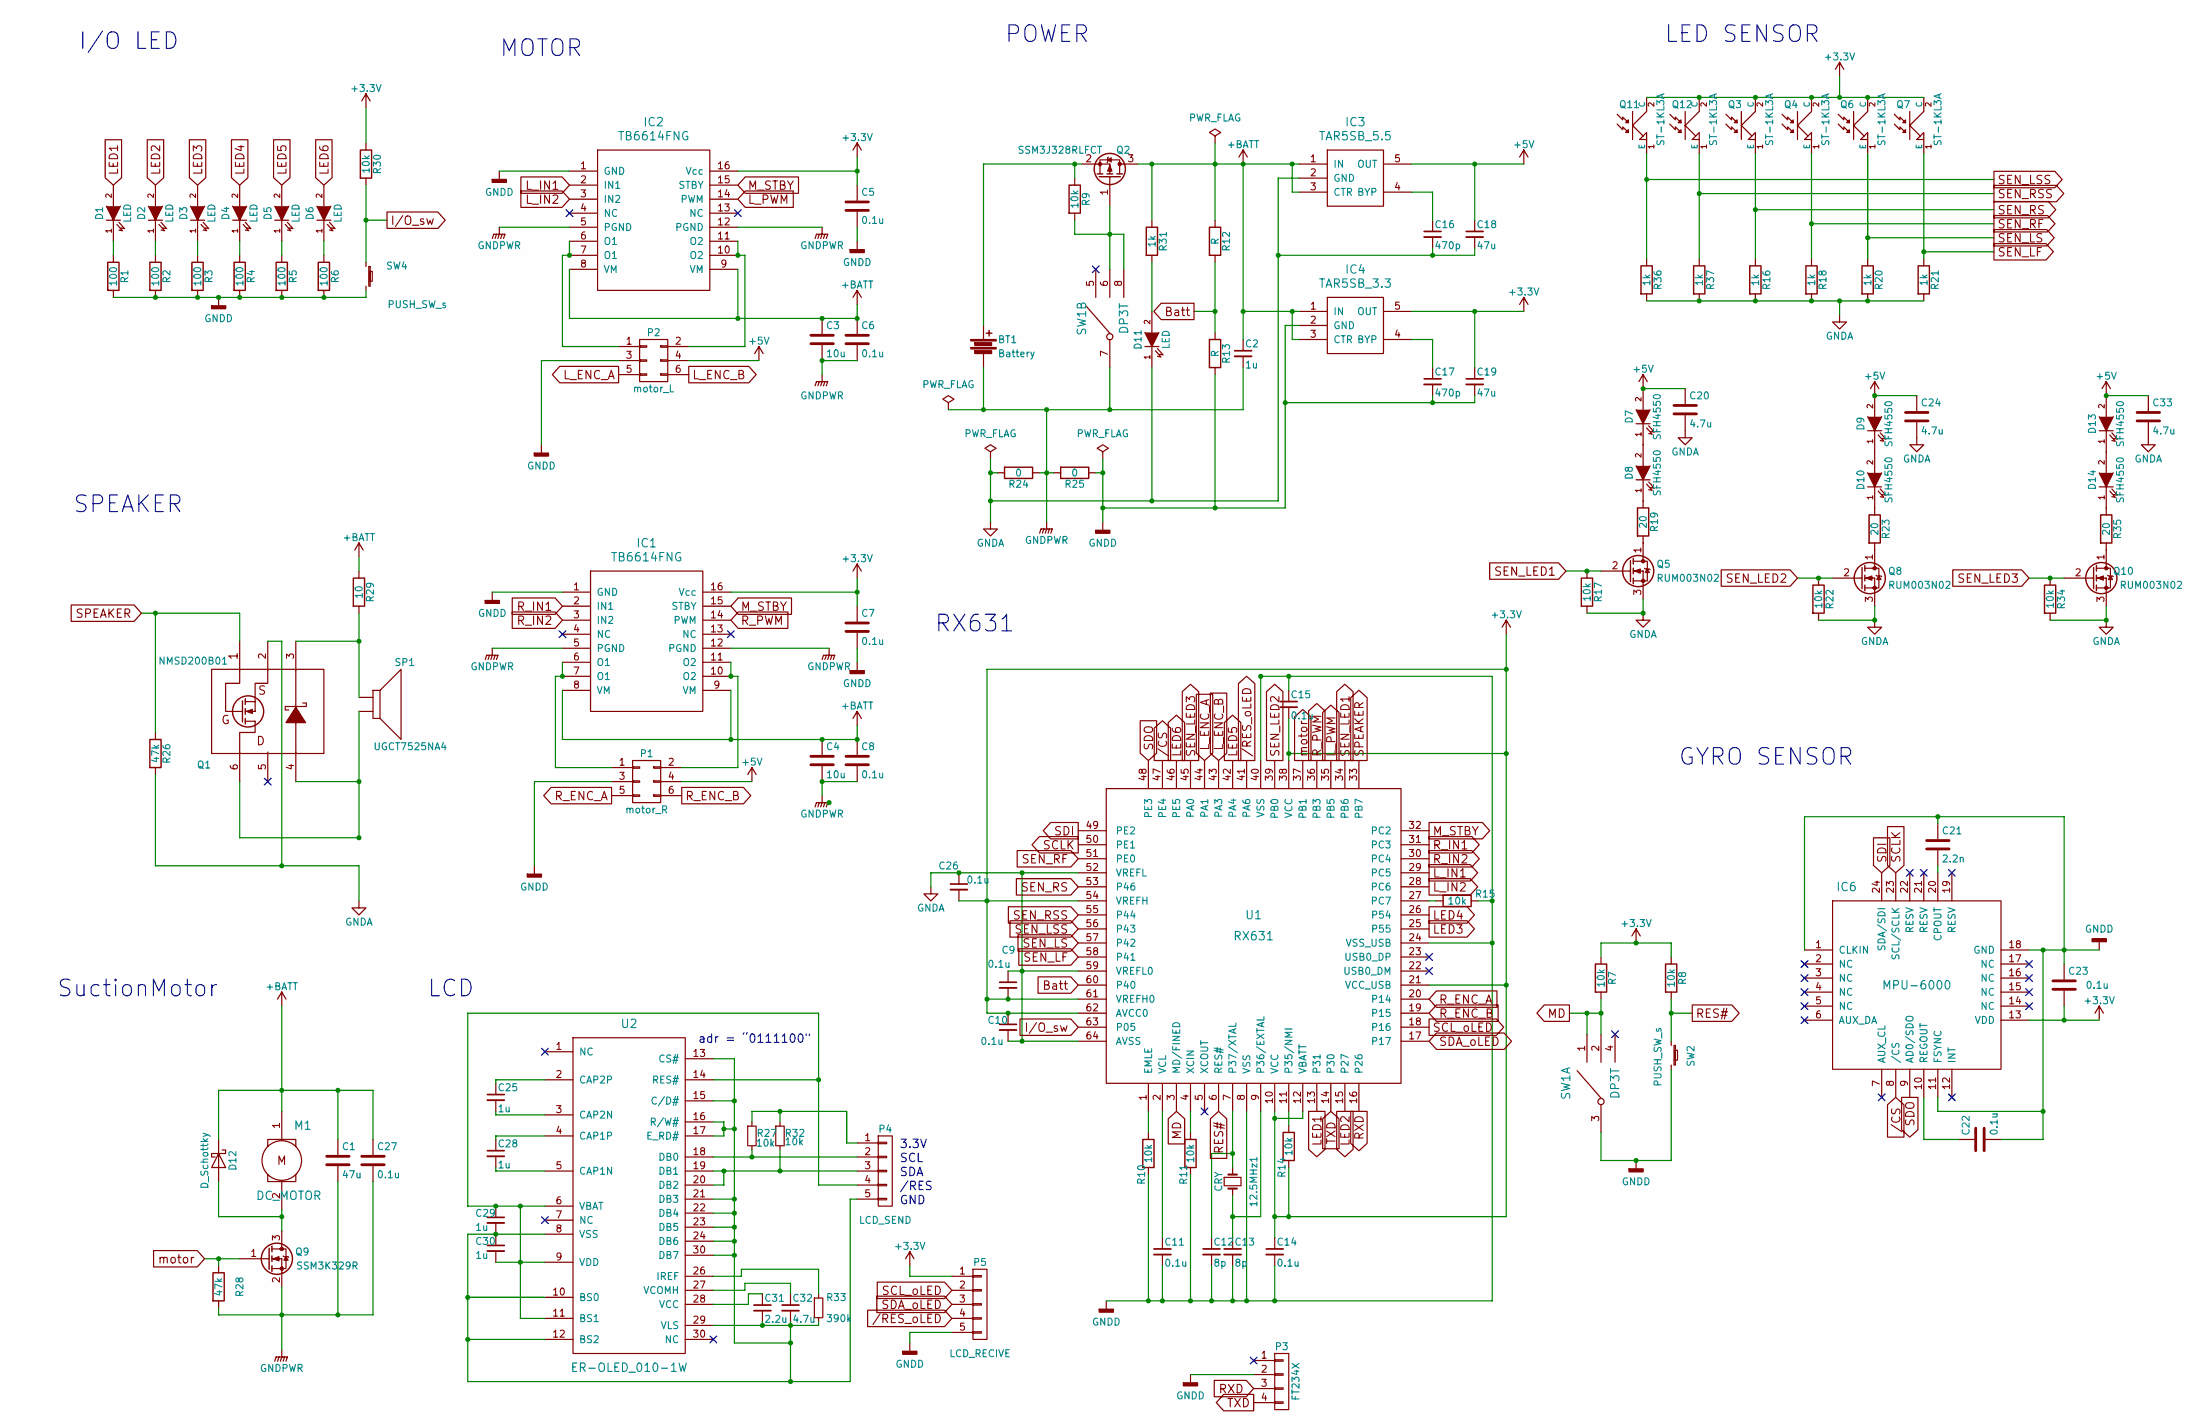
[picture p16: schematic AliCe.sch]

Parts:
12.5MHz1: CRY; CRY_4-SMD
BT1: Battery; pin_con_2mm
C1, C18, C19: 47u; C_0603
C2, C25, C28, C29, C30: 1u; C_0603
C3, C4: 10u; C_0603
C5, C6, C7, C8, C9, C10, C11, C14, C15, C22, C23, C26, C27: 0.1u; C_0603
C12, C13: 8p; C_0603
C16, C17: 470p; C_0603
C20, C24, C32, C33: 4.7u; C_0603
C21: 2.2n; C_0603
C31: 2.2u; C_0603
D1, D2, D3, D4, D5, D6, D11: LED; LED_0603
D7, D8, D9, D10, D13, D14: SFH4550; LED_D3.0mm
D12: D_Schottky; SOD-128
IC1, IC2: TB6614FNG; SSOP-16_4.4x5.2mm_Pitch0.65mm
IC3: TAR5SB_5.5; SSOP5-P-0.95
IC4: TAR5SB_3.3; SSOP5-P-0.95
IC6: MPU-6000; QFN-24-1EP_4x4mm_Pitch0.5mm
M1: DC_MOTOR; Pin_Header_Straight_1x02_Pitch2.54mm
P1: motor_R; Pin_Header_Straight_2x03_Pitch2.00mm
P2: motor_L; Pin_Header_Straight_2x03_Pitch2.00mm
P3: FT234X; Pin_Header_Straight_1x04_Pitch2.54mm
P4: LCD_SEND; FFC_connect_pitch1.0x5
P5: LCD_RECIVE; FFC_connect_pitch1.0x5
Q1: NMSD200B01; SOT-363
Q2: SSM3J328RLFCT; SOT-23
Q3, Q4, Q6, Q7, Q11, Q12: ST-1KL3A; Pin_Header_Straight_1x02_Pitch2.54mm
Q5, Q8, Q10: RUM003N02; SOT-723
Q9: SSM3K329R; SOT-23
R1, R2, R3, R4, R5, R6: 100; R_0402_NoSilk
R7, R8, R9, R10, R11, R14, R15, R17, R22, R27, R30, R32, R34: 10k; R_0402_NoSilk
R12, R13: R; R_0402_NoSilk
R16, R18, R20, R21, R31, R36, R37: 1k; R_0402_NoSilk
R19, R23, R35: 20; R_0402_NoSilk
R24: 0; R_0402_NoSilk
R25: 0; check_2pin_1.6mm
R26, R28: 47k; R_0402_NoSilk
R29: 10; R_0402_NoSilk
R33: 390k; R_0402_NoSilk
SP1: UGCT7525NA4; UGCT7525AN4
SW1: DP3T; JS203011AQN
SW2, SW4: PUSH_SW_s; PTS810
U1: RX631; LQFP-64_10x10mm_Pitch0.5mm
U2: ER-OLED_010-1W; ER-OLED010-1

Connections:
+3V3: C5.1, C7.1, C9.2, C10.1, C14.1, C15.2, C19.1, C23.2, C26.2, IC1.16 (Vcc), IC2.16 (Vcc), IC4.5 (OUT), IC6.13 (VDD), P5.1, Q3.2 (C), Q4.2 (C), Q6.2 (C), Q7.2 (C), Q11.2 (C), Q12.2 (C), R7.1, R8.1, R14.2, R30.1, U1.10 (VCC), U1.12 (VBATT), U1.21 (VCC_USB), U1.38 (VCC), U1.54 (VREFH), U1.61 (VREFH0), U1.62 (AVCC0)
+5V: C18.1, C20.1, C24.1, C33.1, D7.2 (A), D9.2 (A), D13.2 (A), IC3.5 (OUT), P1.4, P2.4
+BATT: C1.1, C2.1, C3.1, C4.1, C6.1, C8.1, C27.1, D12.1 (K), IC1.8 (VM), IC1.9 (VM), IC2.8 (VM), IC2.9 (VM), IC3.1 (IN), IC3.3 (CTR), IC4.1 (IN), IC4.3 (CTR), M1.1, Q2.3 (D), R12.1, R29.1, R31.1
/CS: IC6.8 (/CS), U1.47 (PE4)
/RES_oLED: P5.4, U1.41 (PA6)
Batt: R12.2, R13.1, U1.60 (P40)
GNDA: C9.1, C10.2, C16.2, C18.2, C20.2, C24.2, C26.1, C33.2, D11.1 (K), IC3.2 (GND), Q1.2 (S_Q1), Q5.3 (S), Q8.3 (S), Q10.3 (S), R16.2, R17.2, R18.2, R20.2, R21.2, R22.2, R24.2, R26.2, R34.2, R36.2, R37.2, U1.52 (VREFL), U1.59 (VREFL0), U1.64 (AVSS)
GNDD: C5.2, C7.2, C11.2, C12.2, C13.2, C14.2, C15.1, C17.2, C19.2, C21.1, C22.2, C23.1, IC1.1 (GND), IC2.1 (GND), IC4.2 (GND), IC6.1 (CLKIN), IC6.11 (FSYNC), IC6.18 (GND), P1.3, P2.3, P3.2, P5.5, R1.2, R2.2, R3.2, R4.2, R5.2, R6.2, R10.2, R11.2, R13.2, R15.1, R25.1, SW1.3, SW2.2, SW4.2, U1.8 (VSS), U1.24 (VSS_USB), U1.40 (VSS)
GNDPWR: BT1.2, C1.2, C2.2, C3.2, C4.2, C6.2, C8.2, C27.2, IC1.5 (PGND), IC1.12 (PGND), IC2.5 (PGND), IC2.12 (PGND), Q9.2 (S), R24.1, R25.2, R28.2, SW1.7
I/O_sw: R30.2, SW4.1, U1.63 (P05)
LED1: D1.2 (A), U1.13 (P31)
LED2: D2.2 (A), U1.15 (P27)
LED3: D3.2 (A), U1.25 (P55)
LED4: D4.2 (A), U1.26 (P54)
LED5: D5.2 (A), U1.42 (PA4)
LED6: D6.2 (A), U1.46 (PE5)
L_ENC_A: P2.5, U1.44 (PA1)
L_ENC_B: P2.6, U1.43 (PA3)
L_IN1: IC2.2 (IN1), U1.29 (PC5)
L_IN2: IC2.3 (IN2), U1.28 (PC6)
L_PWM: IC2.14 (PWM), U1.35 (PB5)
MD: R7.2, SW1.1, SW1.2, U1.3 (MD/FINED)
M_STBY: IC1.15 (STBY), IC2.15 (STBY), U1.32 (PC2)
unnamed: 12.5MHz1.1, C12.1, U1.7 (P37/XTAL)
unnamed: 12.5MHz1.2, C13.1, U1.9 (P36/EXTAL)
unnamed: BT1.1, Q2.2 (S), R9.1
unnamed: C11.1, U1.2 (VCL)
unnamed: C16.1, IC3.4 (BYP)
unnamed: C17.1, IC4.4 (BYP)
unnamed: C21.2, IC6.20 (CPOUT)
unnamed: C22.1, IC6.10 (REGOUT)
unnamed: C25.1, U2.2 (CAP2P)
unnamed: C25.2, U2.3 (CAP2N)
unnamed: C28.1, U2.4 (CAP1P)
unnamed: C28.2, U2.5 (CAP1N)
unnamed: C29.1, C30.2, P4.4, U2.6 (VBAT), U2.9 (VDD), U2.11 (BS1), U2.14 (RES#)
unnamed: C29.2, C30.1, C31.2, C32.2, P4.5, R33.2, U2.8 (VSS), U2.10 (BS0), U2.12 (BS2), U2.13 (CS#), U2.15 (C/D#), U2.16 (R/W#), U2.17 (E_RD#), U2.21 (DB3), U2.22 (DB4), U2.23 (DB5), U2.24 (DB6), U2.29 (VLS), U2.30 (DB7)
unnamed: C31.1, U2.28 (VCC)
unnamed: C32.1, U2.27 (VCOMH)
unnamed: D1.1 (K), R1.1
unnamed: D2.1 (K), R2.1
unnamed: D3.1 (K), R3.1
unnamed: D4.1 (K), R4.1
unnamed: D5.1 (K), R5.1
unnamed: D6.1 (K), R6.1
unnamed: D7.1 (K), D8.2 (A)
unnamed: D8.1 (K), R19.1
unnamed: D10.1 (K), R23.1
unnamed: D9.1 (K), D10.2 (A)
unnamed: D11.2 (A), R31.2
unnamed: D12.2 (A), M1.2, Q9.3 (D)
unnamed: D13.1 (K), D14.2 (A)
unnamed: D14.1 (K), R35.1
unnamed: IC1.6 (O1), IC1.7 (O1), P1.1
unnamed: IC1.10 (O2), IC1.11 (O2), P1.2
unnamed: IC2.6 (O1), IC2.7 (O1), P2.1
unnamed: IC2.10 (O2), IC2.11 (O2), P2.2
unnamed: P4.1, R27.1, R32.1
unnamed: P4.2, R27.2, U2.18 (DB0)
unnamed: P4.3, R32.2, U2.19 (DB1), U2.20 (DB2)
unnamed: Q1.3 (C_D1), R29.2, SP1.1
unnamed: Q1.4 (A_D1), Q1.6 (D_Q1), SP1.2
unnamed: Q2.1 (G), R9.2, SW1.6, SW1.8
unnamed: Q5.1 (D), R19.2
unnamed: Q8.1 (D), R23.2
unnamed: Q10.1 (D), R35.2
unnamed: R10.1, U1.1 (EMLE)
unnamed: R11.1, U1.4 (XCIN)
unnamed: R14.1, U1.11 (P35/NMI)
unnamed: R15.2, U1.27 (PC7)
unnamed: R33.1, U2.26 (IREF)
RES#: R8.2, SW2.1, U1.6 (RES#)
RXD: P3.3, U1.16 (P26)
R_ENC_A: P1.5, U1.20 (P14)
R_ENC_B: P1.6, U1.19 (P15)
R_IN1: IC1.2 (IN1), U1.31 (PC3)
R_IN2: IC1.3 (IN2), U1.30 (PC4)
R_PWM: IC1.14 (PWM), U1.36 (PB3)
SCLK: IC6.23 (SCL/SCLK), U1.50 (PE1)
SCL_oLED: P5.2, U1.18 (P16)
SDA_oLED: P5.3, U1.17
SDI: IC6.24 (SDA/SDI), U1.49 (PE2)
SDO: IC6.9 (AD0/SDO), U1.48 (PE3)
SEN_LED1: Q5.2 (G), R17.1, U1.34 (PB6)
SEN_LED2: Q8.2 (G), R22.1, U1.39 (PB0)
SEN_LED3: Q10.2 (G), R34.1, U1.45 (PA0)
SEN_LF: Q7.1 (E), R21.1, U1.58 (P41)
SEN_LS: Q6.1 (E), R20.1, U1.57 (P42)
SEN_LSS: Q11.1 (E), R36.1, U1.56 (P43)
SEN_RF: Q4.1 (E), R18.1, U1.51 (PE0)
SEN_RS: Q3.1 (E), R16.1, U1.53 (P46)
SEN_RSS: Q12.1 (E), R37.1, U1.55 (P44)
SPEAKER: Q1.1 (G_Q1), R26.1, U1.33 (PB7)
TXD: P3.4, U1.14 (P30)
motor: Q9.1 (G), R28.1, U1.37 (PB1)

Notes on the sheet:
LED SENSOR
GYRO SENSOR
RX631
MOTOR
POWER
I/O LED
SPEAKER
SuctionMotor
LCD
adr = “0111100"
3.3V
SCL
SDA
/RES
GND

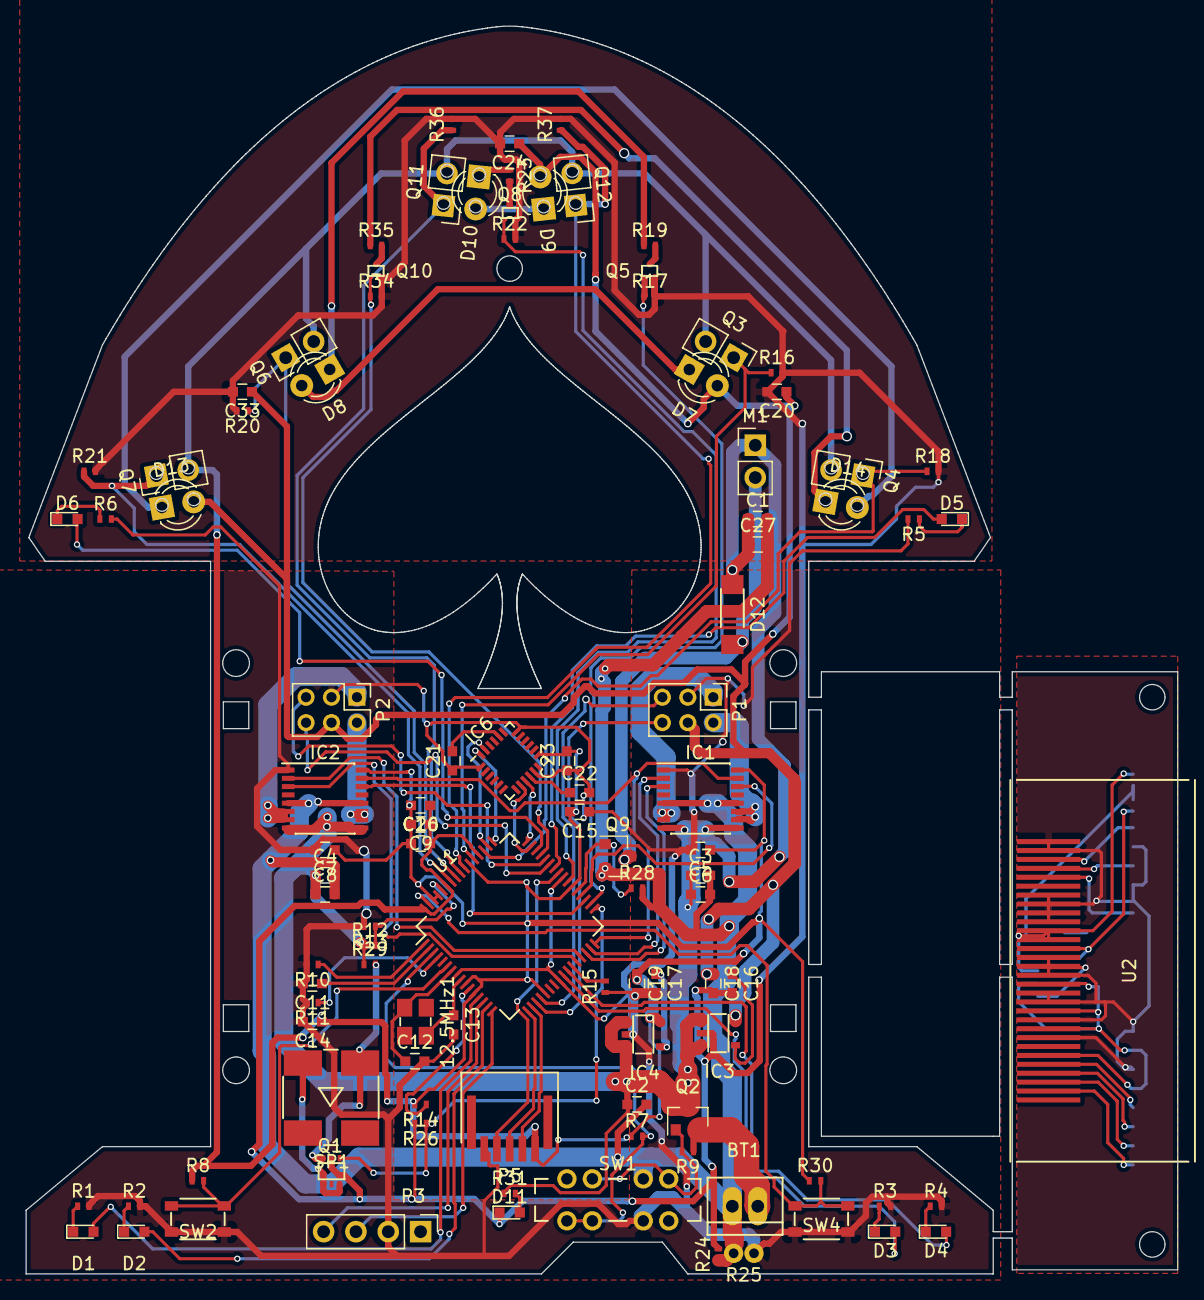
[picture p17: board AliCe.kicad_pcb from above]

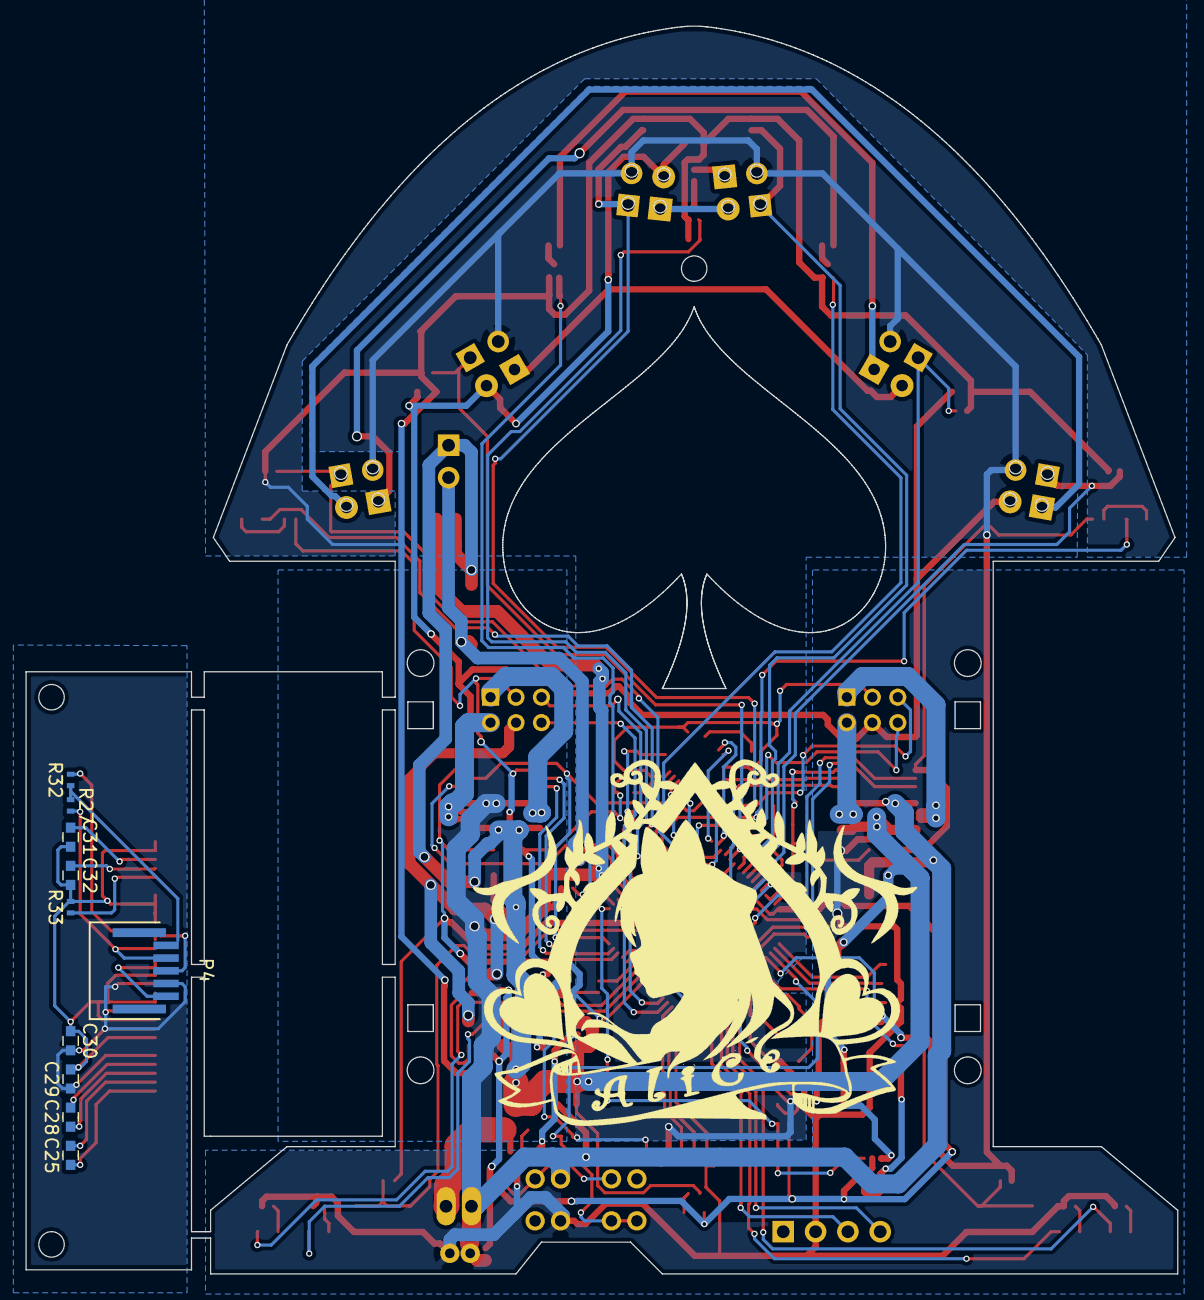
[picture p18: board AliCe.kicad_pcb from below]

Board: 2 copper layers, 90.5 x 98.1 mm, 115 parts (10 on the bottom side), 95 nets.
