AYATAKA-WORKs/AliCe/Src/AliCe/generate/iodefine.h

                                                                          
                                                                           
                                                                           
                                                                           
                                                                           
                                                                           
                                                                           
                                                                           
                                                                           
                                                                           
                                                                           
                                                                           
                                                                           
                                                                          
/********************************************************************************
*
* Device     : RX/RX600/RX63N,RX631
*
* File Name  : iodefine.h
*
* Abstract   : Definition of I/O Register.
*
* History    : 0.02  (2010-11-01)  [Hardware Manual Revision : 0.01]
*            : 0.50  (2011-03-28)  [Hardware Manual Revision : 0.50]
*            : 1.0D  (2012-06-17)  [Hardware Manual Revision : 1.00]
*            : 1.5   (2012-11-24)  [Hardware Manual Revision : 1.50]
*            : 1.6   (2013-05-01)  [Hardware Manual Revision : 1.60]
*            : 1.6A  (2013-07-08)  [Hardware Manual Revision : 1.60]
*            : 1.8   (2015-04-22)  [Hardware Manual Revision : 1.80]
*            : 1.8A  (2015-12-10)  [Hardware Manual Revision : 1.80]
*
* NOTE       : THIS IS A TYPICAL EXAMPLE.
*
* Copyright (C) 2015 (2010 - 2013) Renesas Electronics Corporation.
*
*********************************************************************************/
/********************************************************************************/
/*                                                                              */
/*  DESCRIPTION : Definition of ICU Register                                    */
/*  CPU TYPE    : RX63N                                                         */
/*                                                                              */
/*  Usage : IR,DTCER,IER,IPR of ICU Register                                    */
/*     The following IR, DTCE, IEN, IPR macro functions simplify usage.         */
/*     The bit access operation is "Bit_Name(interrupt source,name)".           */
/*     A part of the name can be omitted.                                       */
/*     for example :                                                            */
/*       IR(TPU0,TGI0A) = 0;     expands to :                                   */
/*         ICU.IR[126].BIT.IR = 0;                                              */
/*                                                                              */
/*       DTCE(ICU,IRQ0) = 1;     expands to :                                   */
/*         ICU.DTCER[64].BIT.DTCE = 1;                                          */
/*                                                                              */
/*       IEN(CMT0,CMI0) = 1;     expands to :                                   */
/*         ICU.IER[0x03].BIT.IEN4 = 1;                                          */
/*                                                                              */
/*       IPR(SCI12,SCIX0) = 2;   expands to :                                   */
/*       IPR(SCI12,SCI  ) = 2;    // SCIX0,SCIX1,SCIX2,SCIX3 share IPR level.   */
/*         ICU.IPR[122].BIT.IPR = 2;                                            */
/*                                                                              */
/*       IPR(SCI0,RXI0) = 3;     expands to :                                   */
/*       IPR(SCI0,    ) = 3;     // SCI0 uses single IPR for all sources.       */
/*         ICU.IPR[214].BIT.IPR = 3;                                            */
/*                                                                              */
/*  Usage : #pragma interrupt Function_Identifier(vect=**)                      */
/*     The number of vector is "(interrupt source, name)".                      */
/*     for example :                                                            */
/*       #pragma interrupt INT_IRQ0(vect=VECT(ICU,IRQ0))          expands to :  */
/*         #pragma interrupt INT_IRQ0(vect=64)                                  */
/*       #pragma interrupt INT_CMT0_CMI0(vect=VECT(CMT0,CMI0))    expands to :  */
/*         #pragma interrupt INT_CMT0_CMI0(vect=28)                             */
/*       #pragma interrupt INT_MTU0_TGIA0(vect=VECT(MTU0,TGIA0))  expands to :  */
/*         #pragma interrupt INT_MTU0_TGIA0(vect=142)                           */
/*       #pragma interrupt INT_TPU0_TGI0A(vect=VECT(TPU0,TGI0A))  expands to :  */
/*         #pragma interrupt INT_TPU0_TGI0A(vect=126)                           */
/*                                                                              */
/*  Usage : MSTPCRA,MSTPCRB,MSTPCRC of SYSTEM Register                          */
/*     The bit access operation is "MSTP(name)".                                */
/*     The name that can be used is a macro name defined with "iodefine.h".     */
/*     for example :                                                            */
/*       MSTP(TMR2) = 0;    // TMR2,TMR3,TMR23                    expands to :  */
/*         SYSTEM.MSTPCRA.BIT.MSTPA4  = 0;                                      */
/*       MSTP(SCI0) = 0;    // SCI0,SMCI0                         expands to :  */
/*         SYSTEM.MSTPCRB.BIT.MSTPB31 = 0;                                      */
/*       MSTP(MTU4) = 0;    // MTU,MTU0,MTU1,MTU2,MTU3,MTU4,MTU5  expands to :  */
/*         SYSTEM.MSTPCRA.BIT.MSTPA9  = 0;                                      */
/*       MSTP(TPU4) = 0;    // TPU0,TPU1,TPU2,TPU3,TPU4,TPU5      expands to :  */
/*         SYSTEM.MSTPCRA.BIT.MSTPA13 = 0;                                      */
/*       MSTP(CMT3) = 0;    // CMT2,CMT3                          expands to :  */
/*         SYSTEM.MSTPCRA.BIT.MSTPA14 = 0;                                      */
/*                                                                              */
/*                                                                              */
/********************************************************************************/
#ifndef __RX63NIODEFINE_HEADER__
#define __RX63NIODEFINE_HEADER__
#pragma bit_order left
#pragma unpack
struct st_ad {
	unsigned short ADDRA;
	unsigned short ADDRB;
	unsigned short ADDRC;
	unsigned short ADDRD;
	unsigned short ADDRE;
	unsigned short ADDRF;
	unsigned short ADDRG;
	unsigned short ADDRH;
	union {
		unsigned char BYTE;
		struct {
			unsigned char :1;
			unsigned char ADIE:1;
			unsigned char ADST:1;
			unsigned char :2;
			unsigned char CH:3;
		} BIT;
	} ADCSR;
	union {
		unsigned char BYTE;
		struct {
			unsigned char TRGS:3;
			unsigned char :1;
			unsigned char CKS:2;
			unsigned char MODE:2;
		} BIT;
	} ADCR;
	union {
		unsigned char BYTE;
		struct {
			unsigned char DPSEL:1;
			unsigned char EXOEN:1;
			unsigned char EXSEL:2;
		} BIT;
	} ADCR2;
	unsigned char  ADSSTR;
	char           wk0[11];
	union {
		unsigned char BYTE;
		struct {
			unsigned char :6;
			unsigned char DIAG:2;
		} BIT;
	} ADDIAGR;
};

struct st_bsc {
	union {
		unsigned char BYTE;
		struct {
			unsigned char :7;
			unsigned char STSCLR:1;
		} BIT;
	} BERCLR;
	char           wk0[3];
	union {
		unsigned char BYTE;
		struct {
			unsigned char :6;
			unsigned char TOEN:1;
			unsigned char IGAEN:1;
		} BIT;
	} BEREN;
	char           wk1[3];
	union {
		unsigned char BYTE;
		struct {
			unsigned char :1;
			unsigned char MST:3;
			unsigned char :2;
			unsigned char TO:1;
			unsigned char IA:1;
		} BIT;
	} BERSR1;
	char           wk2[1];
	union {
		unsigned short WORD;
		struct {
			unsigned short ADDR:13;
		} BIT;
	} BERSR2;
	char           wk3[4];
	union {
		unsigned short WORD;
		struct {
			unsigned short :2;
			unsigned short BPEB:2;
			unsigned short BPFB:2;
			unsigned short BPHB:2;
			unsigned short BPGB:2;
			unsigned short BPIB:2;
			unsigned short BPRO:2;
			unsigned short BPRA:2;
		} BIT;
	} BUSPRI;
	char           wk4[7408];
	union {
		unsigned short WORD;
		struct {
			unsigned short PRMOD:1;
			unsigned short :5;
			unsigned short PWENB:1;
			unsigned short PRENB:1;
			unsigned short :4;
			unsigned short EWENB:1;
			unsigned short :2;
			unsigned short WRMOD:1;
		} BIT;
	} CS0MOD;
	union {
		unsigned long LONG;
		struct {
			unsigned long :3;
			unsigned long CSRWAIT:5;
			unsigned long :3;
			unsigned long CSWWAIT:5;
			unsigned long :5;
			unsigned long CSPRWAIT:3;
			unsigned long :5;
			unsigned long CSPWWAIT:3;
		} BIT;
	} CS0WCR1;
	union {
		unsigned long LONG;
		struct {
			unsigned long :1;
			unsigned long CSON:3;
			unsigned long :1;
			unsigned long WDON:3;
			unsigned long :1;
			unsigned long WRON:3;
			unsigned long :1;
			unsigned long RDON:3;
			unsigned long :2;
			unsigned long AWAIT:2;
			unsigned long :1;
			unsigned long WDOFF:3;
			unsigned long :1;
			unsigned long CSWOFF:3;
			unsigned long :1;
			unsigned long CSROFF:3;
		} BIT;
	} CS0WCR2;
	char           wk5[6];
	union {
		unsigned short WORD;
		struct {
			unsigned short PRMOD:1;
			unsigned short :5;
			unsigned short PWENB:1;
			unsigned short PRENB:1;
			unsigned short :4;
			unsigned short EWENB:1;
			unsigned short :2;
			unsigned short WRMOD:1;
		} BIT;
	} CS1MOD;
	union {
		unsigned long LONG;
		struct {
			unsigned long :3;
			unsigned long CSRWAIT:5;
			unsigned long :3;
			unsigned long CSWWAIT:5;
			unsigned long :5;
			unsigned long CSPRWAIT:3;
			unsigned long :5;
			unsigned long CSPWWAIT:3;
		} BIT;
	} CS1WCR1;
	union {
		unsigned long LONG;
		struct {
			unsigned long :1;
			unsigned long CSON:3;
			unsigned long :1;
			unsigned long WDON:3;
			unsigned long :1;
			unsigned long WRON:3;
			unsigned long :1;
			unsigned long RDON:3;
			unsigned long :2;
			unsigned long AWAIT:2;
			unsigned long :1;
			unsigned long WDOFF:3;
			unsigned long :1;
			unsigned long CSWOFF:3;
			unsigned long :1;
			unsigned long CSROFF:3;
		} BIT;
	} CS1WCR2;
	char           wk6[6];
	union {
		unsigned short WORD;
		struct {
			unsigned short PRMOD:1;
			unsigned short :5;
			unsigned short PWENB:1;
			unsigned short PRENB:1;
			unsigned short :4;
			unsigned short EWENB:1;
			unsigned short :2;
			unsigned short WRMOD:1;
		} BIT;
	} CS2MOD;
	union {
		unsigned long LONG;
		struct {
			unsigned long :3;
			unsigned long CSRWAIT:5;
			unsigned long :3;
			unsigned long CSWWAIT:5;
			unsigned long :5;
			unsigned long CSPRWAIT:3;
			unsigned long :5;
			unsigned long CSPWWAIT:3;
		} BIT;
	} CS2WCR1;
	union {
		unsigned long LONG;
		struct {
			unsigned long :1;
			unsigned long CSON:3;
			unsigned long :1;
			unsigned long WDON:3;
			unsigned long :1;
			unsigned long WRON:3;
			unsigned long :1;
			unsigned long RDON:3;
			unsigned long :2;
			unsigned long AWAIT:2;
			unsigned long :1;
			unsigned long WDOFF:3;
			unsigned long :1;
			unsigned long CSWOFF:3;
			unsigned long :1;
			unsigned long CSROFF:3;
		} BIT;
	} CS2WCR2;
	char           wk7[6];
	union {
		unsigned short WORD;
		struct {
			unsigned short PRMOD:1;
			unsigned short :5;
			unsigned short PWENB:1;
			unsigned short PRENB:1;
			unsigned short :4;
			unsigned short EWENB:1;
			unsigned short :2;
			unsigned short WRMOD:1;
		} BIT;
	} CS3MOD;
	union {
		unsigned long LONG;
		struct {
			unsigned long :3;
			unsigned long CSRWAIT:5;
			unsigned long :3;
			unsigned long CSWWAIT:5;
			unsigned long :5;
			unsigned long CSPRWAIT:3;
			unsigned long :5;
			unsigned long CSPWWAIT:3;
		} BIT;
	} CS3WCR1;
	union {
		unsigned long LONG;
		struct {
			unsigned long :1;
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
		struct {
			unsigned short :3;
			unsigned short MPXEN:1;
			unsigned short :3;
			unsigned short EMODE:1;
			unsigned short :2;
			unsigned short BSIZE:2;
			unsigned short :3;
			unsigned short EXENB:1;
		} BIT;
	} CS6CR;
	char           wk25[6];
	union {
		unsigned short WORD;
		struct {
			unsigned short :4;
			unsigned short WRCV:4;
			unsigned short :4;
			unsigned short RRCV:4;
		} BIT;
	} CS6REC;
	char           wk26[6];
	union {
		unsigned short WORD;
		struct {
			unsigned short :3;
			unsigned short MPXEN:1;
			unsigned short :3;
			unsigned short EMODE:1;
			unsigned short :2;
			unsigned short BSIZE:2;
			unsigned short :3;
			unsigned short EXENB:1;
		} BIT;
	} CS7CR;
	char           wk27[6];
	union {
		unsigned short WORD;
		struct {
			unsigned short :4;
			unsigned short WRCV:4;
			unsigned short :4;
			unsigned short RRCV:4;
		} BIT;
	} CS7REC;
	char           wk28[4];
	union {
		unsigned short WORD;
		struct {
			unsigned short RCVENM7:1;
			unsigned short RCVENM6:1;
			unsigned short RCVENM5:1;
			unsigned short RCVENM4:1;
			unsigned short RCVENM3:1;
			unsigned short RCVENM2:1;
			unsigned short RCVENM1:1;
			unsigned short RCVENM0:1;
			unsigned short RCVEN7:1;
			unsigned short RCVEN6:1;
			unsigned short RCVEN5:1;
			unsigned short RCVEN4:1;
			unsigned short RCVEN3:1;
			unsigned short RCVEN2:1;
			unsigned short RCVEN1:1;
			unsigned short RCVEN0:1;
		} BIT;
	} CSRECEN;
	char           wk29[894];
	union {
		unsigned char BYTE;
		struct {
			unsigned char :2;
			unsigned char BSIZE:2;
			unsigned char :3;
			unsigned char EXENB:1;
		} BIT;
	} SDCCR;
	union {
		unsigned char BYTE;
		struct {
			unsigned char :7;
			unsigned char EMODE:1;
		} BIT;
	} SDCMOD;
	union {
		unsigned char BYTE;
		struct {
			unsigned char :7;
			unsigned char BE:1;
		} BIT;
	} SDAMOD;
	char           wk30[13];
	union {
		unsigned char BYTE;
		struct {
			unsigned char :7;
			unsigned char SFEN:1;
		} BIT;
	} SDSELF;
	char           wk31[3];
	union {
		unsigned short WORD;
		struct {
			unsigned short REFW:4;
			unsigned short RFC:12;
		} BIT;
	} SDRFCR;
	union {
		unsigned char BYTE;
		struct {
			unsigned char :7;
			unsigned char RFEN:1;
		} BIT;
	} SDRFEN;
	char           wk32[9];
	union {
		unsigned char BYTE;
		struct {
			unsigned char :7;
			unsigned char INIRQ:1;
		} BIT;
	} SDICR;
	char           wk33[3];
	union {
		unsigned short WORD;
		struct {
			unsigned short :5;
			unsigned short PRC:3;
			unsigned short ARFC:4;
			unsigned short ARFI:4;
		} BIT;
	} SDIR;
	char           wk34[26];
	union {
		unsigned char BYTE;
		struct {
			unsigned char :6;
			unsigned char MXC:2;
		} BIT;
	} SDADR;
	char           wk35[3];
	union {
		unsigned long LONG;
		struct {
			unsigned long :13;
			unsigned long RAS:3;
			unsigned long :2;
			unsigned long RCD:2;
			unsigned long RP:3;
			unsigned long WR:1;
			unsigned long :5;
			unsigned long CL:3;
		} BIT;
	} SDTR;
	union {
		unsigned short WORD;
		struct {
			unsigned short :1;
			unsigned short MR:15;
		} BIT;
	} SDMOD;
	char           wk36[6];
	union {
		unsigned char BYTE;
		struct {
			unsigned char :3;
			unsigned char SRFST:1;
			unsigned char INIST:1;
			unsigned char :2;
			unsigned char MRSST:1;
		} BIT;
	} SDSR;
};

struct st_can {
	struct {
		union {
			unsigned long LONG;
			struct {
				unsigned short H;
				unsigned short L;
			} WORD;
			struct {
				unsigned char HH;
				unsigned char HL;
				unsigned char LH;
				unsigned char LL;
			} BYTE;
			struct {
				unsigned long IDE:1;
				unsigned long RTR:1;
				unsigned long :1;
				unsigned long SID:11;
				unsigned long EID:18;
			} BIT;
		} ID;
		unsigned short DLC;
		unsigned char  DATA[8];
		unsigned short TS;
	} MB[32];
	union {
		unsigned long LONG;
		struct {
			unsigned short H;
			unsigned short L;
		} WORD;
		struct {
			unsigned char HH;
			unsigned char HL;
			unsigned char LH;
			unsigned char LL;
		} BYTE;
		struct {
			unsigned long :3;
			unsigned long SID:11;
			unsigned long EID:18;
		} BIT;
	} MKR[8];
	union {
		unsigned long LONG;
		struct {
			unsigned short H;
			unsigned short L;
		} WORD;
		struct {
			unsigned char HH;
			unsigned char HL;
			unsigned char LH;
			unsigned char LL;
		} BYTE;
		struct {
			unsigned long IDE:1;
			unsigned long RTR:1;
			unsigned long :1;
			unsigned long SID:11;
			unsigned long EID:18;
		} BIT;
	} FIDCR0;
	union {
		unsigned long LONG;
		struct {
			unsigned short H;
			unsigned short L;
		} WORD;
		struct {
			unsigned char HH;
			unsigned char HL;
			unsigned char LH;
			unsigned char LL;
		} BYTE;
		struct {
			unsigned long IDE:1;
			unsigned long RTR:1;
			unsigned long :1;
			unsigned long SID:11;
			unsigned long EID:18;
		} BIT;
	} FIDCR1;
	union {
		unsigned long LONG;
		struct {
			unsigned short H;
			unsigned short L;
		} WORD;
		struct {
			unsigned char HH;
			unsigned char HL;
			unsigned char LH;
			unsigned char LL;
		} BYTE;
		struct {
			unsigned char MB31:1;
			unsigned char MB30:1;
			unsigned char MB29:1;
			unsigned char MB28:1;
			unsigned char MB27:1;
			unsigned char MB26:1;
			unsigned char MB25:1;
			unsigned char MB24:1;
			unsigned char MB23:1;
			unsigned char MB22:1;
			unsigned char MB21:1;
			unsigned char MB20:1;
			unsigned char MB19:1;
			unsigned char MB18:1;
			unsigned char MB17:1;
			unsigned char MB16:1;
			unsigned char MB15:1;
			unsigned char MB14:1;
			unsigned char MB13:1;
			unsigned char MB12:1;
			unsigned char MB11:1;
			unsigned char MB10:1;
			unsigned char MB9:1;
			unsigned char MB8:1;
			unsigned char MB7:1;
			unsigned char MB6:1;
			unsigned char MB5:1;
			unsigned char MB4:1;
			unsigned char MB3:1;
			unsigned char MB2:1;
			unsigned char MB1:1;
			unsigned char MB0:1;
		} BIT;
	} MKIVLR;
	union {
		unsigned long LONG;
		struct {
			unsigned short H;
			unsigned short L;
		} WORD;
		struct {
			unsigned char HH;
			unsigned char HL;
			unsigned char LH;
			unsigned char LL;
		} BYTE;
		struct {
			unsigned char MB31:1;
			unsigned char MB30:1;
			unsigned char MB29:1;
			unsigned char MB28:1;
			unsigned char MB27:1;
			unsigned char MB26:1;
			unsigned char MB25:1;
			unsigned char MB24:1;
			unsigned char MB23:1;
			unsigned char MB22:1;
			unsigned char MB21:1;
			unsigned char MB20:1;
			unsigned char MB19:1;
			unsigned char MB18:1;
			unsigned char MB17:1;
			unsigned char MB16:1;
			unsigned char MB15:1;
			unsigned char MB14:1;
			unsigned char MB13:1;
			unsigned char MB12:1;
			unsigned char MB11:1;
			unsigned char MB10:1;
			unsigned char MB9:1;
			unsigned char MB8:1;
			unsigned char MB7:1;
			unsigned char MB6:1;
			unsigned char MB5:1;
			unsigned char MB4:1;
			unsigned char MB3:1;
			unsigned char MB2:1;
			unsigned char MB1:1;
			unsigned char MB0:1;
		} BIT;
	} MIER;
	char           wk0[1008];
	union {
		unsigned char BYTE;
		union {
			struct {
				unsigned char TRMREQ:1;
				unsigned char RECREQ:1;
				unsigned char :1;
				unsigned char ONESHOT:1;
				unsigned char :1;
				unsigned char TRMABT:1;
				unsigned char TRMACTIVE:1;
				unsigned char SENTDATA:1;
			} TX;
			struct {
				unsigned char TRMREQ:1;
				unsigned char RECREQ:1;
				unsigned char :1;
				unsigned char ONESHOT:1;
				unsigned char :1;
				unsigned char MSGLOST:1;
				unsigned char INVALDATA:1;
				unsigned char NEWDATA:1;
			} RX;
		} BIT;
	} MCTL[32];
	union {
		unsigned short WORD;
		struct {
			unsigned char H;
			unsigned char L;
		} BYTE;
		struct {
			unsigned char :2;
			unsigned char RBOC:1;
			unsigned char BOM:2;
			unsigned char SLPM:1;
			unsigned char CANM:2;
			unsigned char TSPS:2;
			unsigned char TSRC:1;
			unsigned char TPM:1;
			unsigned char MLM:1;
			unsigned char IDFM:2;
			unsigned char MBM:1;
		} BIT;
	} CTLR;
	union {
		unsigned short WORD;
		struct {
			unsigned char H;
			unsigned char L;
		} BYTE;
		struct {
			unsigned char :1;
			unsigned char RECST:1;
			unsigned char TRMST:1;
			unsigned char BOST:1;
			unsigned char EPST:1;
			unsigned char SLPST:1;
			unsigned char HLTST:1;
			unsigned char RSTST:1;
			unsigned char EST:1;
			unsigned char TABST:1;
			unsigned char FMLST:1;
			unsigned char NMLST:1;
			unsigned char TFST:1;
			unsigned char RFST:1;
			unsigned char SDST:1;
			unsigned char NDST:1;
		} BIT;
	} STR;
	union {
		unsigned long LONG;
		struct {
			unsigned short H;
			unsigned short L;
		} WORD;
		struct {
			unsigned char HH;
			unsigned char HL;
			unsigned char LH;
			unsigned char LL;
		} BYTE;
		struct {
			unsigned long TSEG1:4;
			unsigned long :2;
			unsigned long BRP:10;
			unsigned long :2;
			unsigned long SJW:2;
			unsigned long :1;
			unsigned long TSEG2:3;
			unsigned long :7;
			unsigned long CCLKS:1;
		} BIT;
	} BCR;
	union {
		unsigned char BYTE;
		struct {
			unsigned char RFEST:1;
			unsigned char RFWST:1;
			unsigned char RFFST:1;
			unsigned char RFMLF:1;
			unsigned char RFUST:3;
			unsigned char RFE:1;
		} BIT;
	} RFCR;
	unsigned char  RFPCR;
	union {
		unsigned char BYTE;
		struct {
			unsigned char TFEST:1;
			unsigned char TFFST:1;
			unsigned char :2;
			unsigned char TFUST:3;
			unsigned char TFE:1;
		} BIT;
	} TFCR;
	unsigned char  TFPCR;
	union {
		unsigned char BYTE;
		struct {
			unsigned char BLIE:1;
			unsigned char OLIE:1;
			unsigned char ORIE:1;
			unsigned char BORIE:1;
			unsigned char BOEIE:1;
			unsigned char EPIE:1;
			unsigned char EWIE:1;
			unsigned char BEIE:1;
		} BIT;
	} EIER;
	union {
		unsigned char BYTE;
		struct {
			unsigned char BLIF:1;
			unsigned char OLIF:1;
			unsigned char ORIF:1;
			unsigned char BORIF:1;
			unsigned char BOEIF:1;
			unsigned char EPIF:1;
			unsigned char EWIF:1;
			unsigned char BEIF:1;
		} BIT;
	} EIFR;
	unsigned char  RECR;
	unsigned char  TECR;
	union {
		unsigned char BYTE;
		struct {
			unsigned char EDPM:1;
			unsigned char ADEF:1;
			unsigned char BE0F:1;
			unsigned char BE1F:1;
			unsigned char CEF:1;
			unsigned char AEF:1;
			unsigned char FEF:1;
			unsigned char SEF:1;
		} BIT;
	} ECSR;
	unsigned char  CSSR;
	union {
		unsigned char BYTE;
		struct {
			unsigned char SEST:1;
			unsigned char :2;
			unsigned char MBNST:5;
		} BIT;
	} MSSR;
	union {
		unsigned char BYTE;
		struct {
			unsigned char :6;
			unsigned char MBSM:2;
		} BIT;
	} MSMR;
	unsigned short TSR;
	unsigned short AFSR;
	union {
		unsigned char BYTE;
		struct {
			unsigned char :5;
			unsigned char TSTM:2;
			unsigned char TSTE:1;
		} BIT;
	} TCR;
};

struct st_cmt {
	union {
		unsigned short WORD;
		struct {
			unsigned short :14;
			unsigned short STR1:1;
			unsigned short STR0:1;
		} BIT;
	} CMSTR0;
	char           wk0[14];
	union {
		unsigned short WORD;
		struct {
			unsigned short :14;
			unsigned short STR3:1;
			unsigned short STR2:1;
		} BIT;
	} CMSTR1;
};

struct st_cmt0 {
	union {
		unsigned short WORD;
		struct {
			unsigned short :9;
			unsigned short CMIE:1;
			unsigned short :4;
			unsigned short CKS:2;
		} BIT;
	} CMCR;
	unsigned short CMCNT;
	unsigned short CMCOR;
};

struct st_crc {
	union {
		unsigned char BYTE;
		struct {
			unsigned char DORCLR:1;
			unsigned char :4;
			unsigned char LMS:1;
			unsigned char GPS:2;
		} BIT;
	} CRCCR;
	unsigned char  CRCDIR;
	unsigned short CRCDOR;
};

struct st_da {
	unsigned short DADR0;
	unsigned short DADR1;
	union {
		unsigned char BYTE;
		struct {
			unsigned char DAOE1:1;
			unsigned char DAOE0:1;
			unsigned char DAE:1;
		} BIT;
	} DACR;
	union {
		unsigned char BYTE;
		struct {
			unsigned char DPSEL:1;
		} BIT;
	} DADPR;
	union {
		unsigned char BYTE;
		struct {
			unsigned char DAADST:1;
		} BIT;
	} DAADSCR;
};

struct st_dmac {
	union {
		unsigned char BYTE;
		struct {
			unsigned char :7;
			unsigned char DMST:1;
		} BIT;
	} DMAST;
};

struct st_dmac0 {
	void          *DMSAR;
	void          *DMDAR;
	unsigned long  DMCRA;
	unsigned short DMCRB;
	char           wk0[2];
	union {
		unsigned short WORD;
		struct {
			unsigned short MD:2;
			unsigned short DTS:2;
			unsigned short :2;
			unsigned short SZ:2;
			unsigned short :6;
			unsigned short DCTG:2;
		} BIT;
	} DMTMD;
	char           wk1[1];
	union {
		unsigned char BYTE;
		struct {
			unsigned char :3;
			unsigned char DTIE:1;
			unsigned char ESIE:1;
			unsigned char RPTIE:1;
			unsigned char SARIE:1;
			unsigned char DARIE:1;
		} BIT;
	} DMINT;
	union {
		unsigned short WORD;
		struct {
			unsigned short SM:2;
			unsigned short :1;
			unsigned short SARA:5;
			unsigned short DM:2;
			unsigned short :1;
			unsigned short DARA:5;
		} BIT;
	} DMAMD;
	char           wk2[2];
	unsigned long  DMOFR;
	union {
		unsigned char BYTE;
		struct {
			unsigned char :7;
			unsigned char DTE:1;
		} BIT;
	} DMCNT;
	union {
		unsigned char BYTE;
		struct {
			unsigned char :3;
			unsigned char CLRS:1;
			unsigned char :3;
			unsigned char SWREQ:1;
		} BIT;
	} DMREQ;
	union {
		unsigned char BYTE;
		struct {
			unsigned char ACT:1;
			unsigned char :2;
			unsigned char DTIF:1;
			unsigned char :3;
			unsigned char ESIF:1;
		} BIT;
	} DMSTS;
	union {
		unsigned char BYTE;
		struct {
			unsigned char :7;
			unsigned char DISEL:1;
		} BIT;
	} DMCSL;
};

struct st_dmac1 {
	void          *DMSAR;
	void          *DMDAR;
	unsigned long  DMCRA;
	unsigned short DMCRB;
	char           wk0[2];
	union {
		unsigned short WORD;
		struct {
			unsigned short MD:2;
			unsigned short DTS:2;
			unsigned short :2;
			unsigned short SZ:2;
			unsigned short :6;
			unsigned short DCTG:2;
		} BIT;
	} DMTMD;
	char           wk1[1];
	union {
		unsigned char BYTE;
		struct {
			unsigned char :3;
			unsigned char DTIE:1;
			unsigned char ESIE:1;
			unsigned char RPTIE:1;
			unsigned char SARIE:1;
			unsigned char DARIE:1;
		} BIT;
	} DMINT;
	union {
		unsigned short WORD;
		struct {
			unsigned short SM:2;
			unsigned short :1;
			unsigned short SARA:5;
			unsigned short DM:2;
			unsigned short :1;
			unsigned short DARA:5;
		} BIT;
	} DMAMD;
	char           wk2[6];
	union {
		unsigned char BYTE;
		struct {
			unsigned char :7;
			unsigned char DTE:1;
		} BIT;
	} DMCNT;
	union {
		unsigned char BYTE;
		struct {
			unsigned char :3;
			unsigned char CLRS:1;
			unsigned char :3;
			unsigned char SWREQ:1;
		} BIT;
	} DMREQ;
	union {
		unsigned char BYTE;
		struct {
			unsigned char ACT:1;
			unsigned char :2;
			unsigned char DTIF:1;
			unsigned char :3;
			unsigned char ESIF:1;
		} BIT;
	} DMSTS;
	union {
		unsigned char BYTE;
		struct {
			unsigned char :7;
			unsigned char DISEL:1;
		} BIT;
	} DMCSL;
};

struct st_dtc {
	union {
		unsigned char BYTE;
		struct {
			unsigned char :3;
			unsigned char RRS:1;
		} BIT;
	} DTCCR;
	char           wk0[3];
	void          *DTCVBR;
	union {
		unsigned char BYTE;
		struct {
			unsigned char :7;
			unsigned char SHORT:1;
		} BIT;
	} DTCADMOD;
	char           wk1[3];
	union {
		unsigned char BYTE;
		struct {
			unsigned char :7;
			unsigned char DTCST:1;
		} BIT;
	} DTCST;
	char           wk2[1];
	union {
		unsigned short WORD;
		struct {
			unsigned short ACT:1;
			unsigned short :7;
			unsigned short VECN:8;
		} BIT;
	} DTCSTS;
};

struct st_edmac {
	union {
		unsigned long LONG;
		struct {
			unsigned long :25;
			unsigned long DE:1;
			unsigned long DL:2;
			unsigned long :3;
			unsigned long SWR:1;
		} BIT;
	} EDMR;
	char           wk0[4];
	union {
		unsigned long LONG;
		struct {
			unsigned long :31;
			unsigned long TR:1;
		} BIT;
	} EDTRR;
	char           wk1[4];
	union {
		unsigned long LONG;
		struct {
			unsigned long :31;
			unsigned long RR:1;
		} BIT;
	} EDRRR;
	char           wk2[4];
	void          *TDLAR;
	char           wk3[4];
	void          *RDLAR;
	char           wk4[4];
	union {
		unsigned long LONG;
		struct {
			unsigned long :1;
			unsigned long TWB:1;
			unsigned long :3;
			unsigned long TABT:1;
			unsigned long RABT:1;
			unsigned long RFCOF:1;
			unsigned long ADE:1;
			unsigned long ECI:1;
			unsigned long TC:1;
			unsigned long TDE:1;
			unsigned long TFUF:1;
			unsigned long FR:1;
			unsigned long RDE:1;
			unsigned long RFOF:1;
			unsigned long :4;
			unsigned long CND:1;
			unsigned long DLC:1;
			unsigned long CD:1;
			unsigned long TRO:1;
			unsigned long RMAF:1;
			unsigned long :2;
			unsigned long RRF:1;
			unsigned long RTLF:1;
			unsigned long RTSF:1;
			unsigned long PRE:1;
			unsigned long CERF:1;
		} BIT;
	} EESR;
	char           wk5[4];
	union {
		unsigned long LONG;
		struct {
			unsigned long :1;
			unsigned long TWBIP:1;
			unsigned long :3;
			unsigned long TABTIP:1;
			unsigned long RABTIP:1;
			unsigned long RFCOFIP:1;
			unsigned long ADEIP:1;
			unsigned long ECIIP:1;
			unsigned long TCIP:1;
			unsigned long TDEIP:1;
			unsigned long TFUFIP:1;
			unsigned long FRIP:1;
			unsigned long RDEIP:1;
			unsigned long RFOFIP:1;
			unsigned long :4;
			unsigned long CNDIP:1;
			unsigned long DLCIP:1;
			unsigned long CDIP:1;
			unsigned long TROIP:1;
			unsigned long RMAFIP:1;
			unsigned long :2;
			unsigned long RRFIP:1;
			unsigned long RTLFIP:1;
			unsigned long RTSFIP:1;
			unsigned long PREIP:1;
			unsigned long CERFIP:1;
		} BIT;
	} EESIPR;
	char           wk6[4];
	union {
		unsigned long LONG;
		struct {
			unsigned long :20;
			unsigned long CNDCE:1;
			unsigned long DLCCE:1;
			unsigned long CDCE:1;
			unsigned long TROCE:1;
			unsigned long RMAFCE:1;
			unsigned long :2;
			unsigned long RRFCE:1;
			unsigned long RTLFCE:1;
			unsigned long RTSFCE:1;
			unsigned long PRECE:1;
			unsigned long CERFCE:1;
		} BIT;
	} TRSCER;
	char           wk7[4];
	union {
		unsigned long LONG;
		struct {
			unsigned long :16;
			unsigned long MFC:16;
		} BIT;
	} RMFCR;
	char           wk8[4];
	union {
		unsigned long LONG;
		struct {
			unsigned long :21;
			unsigned long TFT:11;
		} BIT;
	} TFTR;
	char           wk9[4];
	union {
		unsigned long LONG;
		struct {
			unsigned long :19;
			unsigned long TFD:5;
			unsigned long :3;
			unsigned long RFD:5;
		} BIT;
	} FDR;
	char           wk10[4];
	union {
		unsigned long LONG;
		struct {
			unsigned long :30;
			unsigned long RNC:1;
			unsigned long RNR:1;
		} BIT;
	} RMCR;
	char           wk11[8];
	union {
		unsigned long LONG;
		struct {
			unsigned long :16;
			unsigned long UNDER:16;
		} BIT;
	} TFUCR;
	union {
		unsigned long LONG;
		struct {
			unsigned long :16;
			unsigned long OVER:16;
		} BIT;
	} RFOCR;
	union {
		unsigned long LONG;
		struct {
			unsigned long :31;
			unsigned long ELB:1;
		} BIT;
	} IOSR;
	union {
		unsigned long LONG;
		struct {
			unsigned long :13;
			unsigned long RFFO:3;
			unsigned long :13;
			unsigned long RFDO:3;
		} BIT;
	} FCFTR;
	char           wk12[4];
	union {
		unsigned long LONG;
		struct {
			unsigned long :14;
			unsigned long PADS:2;
			unsigned long :10;
			unsigned long PADR:6;
		} BIT;
	} RPADIR;
	union {
		unsigned long LONG;
		struct {
			unsigned long :27;
			unsigned long TIM:1;
			unsigned long :3;
			unsigned long TIS:1;
		} BIT;
	} TRIMD;
	char           wk13[72];
	void          *RBWAR;
	void          *RDFAR;
	char           wk14[4];
	void          *TBRAR;
	void          *TDFAR;
};

struct st_etherc {
	union {
		unsigned long LONG;
		struct {
			unsigned long :11;
			unsigned long TPC:1;
			unsigned long ZPF:1;
			unsigned long PFR:1;
			unsigned long RXF:1;
			unsigned long TXF:1;
			unsigned long :3;
			unsigned long PRCEF:1;
			unsigned long :2;
			unsigned long MPDE:1;
			unsigned long :2;
			unsigned long RE:1;
			unsigned long TE:1;
			unsigned long :1;
			unsigned long ILB:1;
			unsigned long RTM:1;
			unsigned long DM:1;
			unsigned long PRM:1;
		} BIT;
	} ECMR;
	char           wk0[4];
	union {
		unsigned long LONG;
		struct {
			unsigned long :20;
			unsigned long RFL:12;
		} BIT;
	} RFLR;
	char           wk1[4];
	union {
		unsigned long LONG;
		struct {
			unsigned long :26;
			unsigned long BFR:1;
			unsigned long PSRTO:1;
			unsigned long :1;
			unsigned long LCHNG:1;
			unsigned long MPD:1;
			unsigned long ICD:1;
		} BIT;
	} ECSR;
	char           wk2[4];
	union {
		unsigned long LONG;
		struct {
			unsigned long :26;
			unsigned long BFSIPR:1;
			unsigned long PSRTOIP:1;
			unsigned long :1;
			unsigned long LCHNGIP:1;
			unsigned long MPDIP:1;
			unsigned long ICDIP:1;
		} BIT;
	} ECSIPR;
	char           wk3[4];
	union {
		unsigned long LONG;
		struct {
			unsigned long :28;
			unsigned long MDI:1;
			unsigned long MDO:1;
			unsigned long MMD:1;
			unsigned long MDC:1;
		} BIT;
	} PIR;
	char           wk4[4];
	union {
		unsigned long LONG;
		struct {
			unsigned long :31;
			unsigned long LMON:1;
		} BIT;
	} PSR;
	char           wk5[20];
	union {
		unsigned long LONG;
		struct {
			unsigned long :12;
			unsigned long RMD:20;
		} BIT;
	} RDMLR;
	char           wk6[12];
	union {
		unsigned long LONG;
		struct {
			unsigned long :27;
			unsigned long IPG:5;
		} BIT;
	} IPGR;
	union {
		unsigned long LONG;
		struct {
			unsigned long :16;
			unsigned long AP:16;
		} BIT;
	} APR;
	union {
		unsigned long LONG;
		struct {
			unsigned long :16;
			unsigned long MP:16;
		} BIT;
	} MPR;
	char           wk7[4];
	union {
		unsigned long LONG;
		struct {
			unsigned long :24;
			unsigned long RPAUSE:8;
		} BIT;
	} RFCF;
	union {
		unsigned long LONG;
		struct {
			unsigned long :16;
			unsigned long TPAUSE:16;
		} BIT;
	} TPAUSER;
	union {
		unsigned long LONG;
		struct {
			unsigned long :24;
			unsigned long TXP:8;
		} BIT;
	} TPAUSECR;
	union {
		unsigned long LONG;
		struct {
			unsigned long :16;
			unsigned long BCF:16;
		} BIT;
	} BCFRR;
	char           wk8[80];
	unsigned long  MAHR;
	char           wk9[4];
	union {
		unsigned long LONG;
		struct {
			unsigned long :16;
			unsigned long MA:16;
		} BIT;
	} MALR;
	char           wk10[4];
	unsigned long  TROCR;
	unsigned long  CDCR;
	unsigned long  LCCR;
	unsigned long  CNDCR;
	char           wk11[4];
	unsigned long  CEFCR;
	unsigned long  FRECR;
	unsigned long  TSFRCR;
	unsigned long  TLFRCR;
	unsigned long  RFCR;
	unsigned long  MAFCR;
};

struct st_exdmac {
	union {
		unsigned char BYTE;
		struct {
			unsigned char :7;
			unsigned char DMST:1;
		} BIT;
	} EDMAST;
	char           wk0[479];
	unsigned long  CLSBR0;
	unsigned long  CLSBR1;
	unsigned long  CLSBR2;
	unsigned long  CLSBR3;
	unsigned long  CLSBR4;
	unsigned long  CLSBR5;
	unsigned long  CLSBR6;
	unsigned long  CLSBR7;
};

struct st_exdmac0 {
	void          *EDMSAR;
	void          *EDMDAR;
	unsigned long  EDMCRA;
	unsigned short EDMCRB;
	char           wk0[2];
	union {
		unsigned short WORD;
		struct {
			unsigned short MD:2;
			unsigned short DTS:2;
			unsigned short :2;
			unsigned short SZ:2;
			unsigned short :6;
			unsigned short DCTG:2;
		} BIT;
	} EDMTMD;
	union {
		unsigned char BYTE;
		struct {
			unsigned char :4;
			unsigned char DACKS:1;
			unsigned char DACKE:1;
			unsigned char DACKW:1;
			unsigned char DACKSEL:1;
		} BIT;
	} EDMOMD;
	union {
		unsigned char BYTE;
		struct {
			unsigned char :3;
			unsigned char DTIE:1;
			unsigned char ESIE:1;
			unsigned char RPTIE:1;
			unsigned char SARIE:1;
			unsigned char DARIE:1;
		} BIT;
	} EDMINT;
	union {
		unsigned long LONG;
		struct {
			unsigned long :14;
			unsigned long AMS:1;
			unsigned long DIR:1;
			unsigned long SM:2;
			unsigned long :1;
			unsigned long SARA:5;
			unsigned long DM:2;
			unsigned long :1;
			unsigned long DARA:5;
		} BIT;
	} EDMAMD;
	unsigned long  EDMOFR;
	union {
		unsigned char BYTE;
		struct {
			unsigned char :7;
			unsigned char DTE:1;
		} BIT;
	} EDMCNT;
	union {
		unsigned char BYTE;
		struct {
			unsigned char :3;
			unsigned char CLRS:1;
			unsigned char :3;
			unsigned char SWREQ:1;
		} BIT;
	} EDMREQ;
	union {
		unsigned char BYTE;
		struct {
			unsigned char ACT:1;
			unsigned char :2;
			unsigned char DTIF:1;
			unsigned char :3;
			unsigned char ESIF:1;
		} BIT;
	} EDMSTS;
	char           wk1[1];
	union {
		unsigned char BYTE;
		struct {
			unsigned char :6;
			unsigned char DREQS:2;
		} BIT;
	} EDMRMD;
	union {
		unsigned char BYTE;
		struct {
			unsigned char :7;
			unsigned char EREQ:1;
		} BIT;
	} EDMERF;
	union {
		unsigned char BYTE;
		struct {
			unsigned char :7;
			unsigned char PREQ:1;
		} BIT;
	} EDMPRF;
};

struct st_exdmac1 {
	void          *EDMSAR;
	void          *EDMDAR;
	unsigned long  EDMCRA;
	unsigned short EDMCRB;
	char           wk0[2];
	union {
		unsigned short WORD;
		struct {
			unsigned short MD:2;
			unsigned short DTS:2;
			unsigned short :2;
			unsigned short SZ:2;
			unsigned short :6;
			unsigned short DCTG:2;
		} BIT;
	} EDMTMD;
	union {
		unsigned char BYTE;
		struct {
			unsigned char :4;
			unsigned char DACKS:1;
			unsigned char DACKE:1;
			unsigned char DACKW:1;
			unsigned char DACKSEL:1;
		} BIT;
	} EDMOMD;
	union {
		unsigned char BYTE;
		struct {
			unsigned char :3;
			unsigned char DTIE:1;
			unsigned char ESIE:1;
			unsigned char RPTIE:1;
			unsigned char SARIE:1;
			unsigned char DARIE:1;
		} BIT;
	} EDMINT;
	union {
		unsigned long LONG;
		struct {
			unsigned long :14;
			unsigned long AMS:1;
			unsigned long DIR:1;
			unsigned long SM:2;
			unsigned long :1;
			unsigned long SARA:5;
			unsigned long DM:2;
			unsigned long :1;
			unsigned long DARA:5;
		} BIT;
	} EDMAMD;
	char           wk1[4];
	union {
		unsigned char BYTE;
		struct {
			unsigned char :7;
			unsigned char DTE:1;
		} BIT;
	} EDMCNT;
	union {
		unsigned char BYTE;
		struct {
			unsigned char :3;
			unsigned char CLRS:1;
			unsigned char :3;
			unsigned char SWREQ:1;
		} BIT;
	} EDMREQ;
	union {
		unsigned char BYTE;
		struct {
			unsigned char ACT:1;
			unsigned char :2;
			unsigned char DTIF:1;
			unsigned char :3;
			unsigned char ESIF:1;
		} BIT;
	} EDMSTS;
	char           wk2[1];
	union {
		unsigned char BYTE;
		struct {
			unsigned char :6;
			unsigned char DREQS:2;
		} BIT;
	} EDMRMD;
	union {
		unsigned char BYTE;
		struct {
			unsigned char :7;
			unsigned char EREQ:1;
		} BIT;
	} EDMERF;
	union {
		unsigned char BYTE;
		struct {
			unsigned char :7;
			unsigned char PREQ:1;
		} BIT;
	} EDMPRF;
};

struct st_flash {
	union {
		unsigned char BYTE;
		struct {
			unsigned char :6;
			unsigned char FLWE:2;
		} BIT;
	} FWEPROR;
	char           wk0[7799147];
	union {
		unsigned char BYTE;
		struct {
			unsigned char :3;
			unsigned char FRDMD:1;
		} BIT;
	} FMODR;
	char           wk1[13];
	union {
		unsigned char BYTE;
		struct {
			unsigned char ROMAE:1;
			unsigned char :2;
			unsigned char CMDLK:1;
			unsigned char DFLAE:1;
			unsigned char :1;
			unsigned char DFLRPE:1;
			unsigned char DFLWPE:1;
		} BIT;
	} FASTAT;
	union {
		unsigned char BYTE;
		struct {
			unsigned char ROMAEIE:1;
			unsigned char :2;
			unsigned char CMDLKIE:1;
			unsigned char DFLAEIE:1;
			unsigned char :1;
			unsigned char DFLRPEIE:1;
			unsigned char DFLWPEIE:1;
		} BIT;
	} FAEINT;
	union {
		unsigned char BYTE;
		struct {
			unsigned char :7;
			unsigned char FRDYIE:1;
		} BIT;
	} FRDYIE;
	char           wk2[45];
	union {
		unsigned short WORD;
		struct {
			unsigned short KEY:8;
			unsigned short DBRE07:1;
			unsigned short DBRE06:1;
			unsigned short DBRE05:1;
			unsigned short DBRE04:1;
			unsigned short DBRE03:1;
			unsigned short DBRE02:1;
			unsigned short DBRE01:1;
			unsigned short DBRE00:1;
		} BIT;
	} DFLRE0;
	union {
		unsigned short WORD;
		struct {
			unsigned short KEY:8;
			unsigned short DBRE15:1;
			unsigned short DBRE14:1;
			unsigned short DBRE13:1;
			unsigned short DBRE12:1;
			unsigned short DBRE11:1;
			unsigned short DBRE10:1;
			unsigned short DBRE09:1;
			unsigned short DBRE08:1;
		} BIT;
	} DFLRE1;
	char           wk3[12];
	union {
		unsigned short WORD;
		struct {
			unsigned short KEY:8;
			unsigned short DBWE07:1;
			unsigned short DBW006:1;
			unsigned short DBWE05:1;
			unsigned short DBWE04:1;
			unsigned short DBWE03:1;
			unsigned short DBWE02:1;
			unsigned short DBWE01:1;
			unsigned short DBWE00:1;
		} BIT;
	} DFLWE0;
	union {
		unsigned short WORD;
		struct {
			unsigned short KEY:8;
			unsigned short DBWE15:1;
			unsigned short DBWE14:1;
			unsigned short DBWE13:1;
			unsigned short DBWE12:1;
			unsigned short DBWE11:1;
			unsigned short DBWE10:1;
			unsigned short DBWE09:1;
			unsigned short DBWE08:1;
		} BIT;
	} DFLWE1;
	union {
		unsigned short WORD;
		struct {
			unsigned short KEY:8;
			unsigned short :7;
			unsigned short FCRME:1;
		} BIT;
	} FCURAME;
	char           wk4[15194];
	union {
		unsigned char BYTE;
		struct {
			unsigned char FRDY:1;
			unsigned char ILGLERR:1;
			unsigned char ERSERR:1;
			unsigned char PRGERR:1;
			unsigned char SUSRDY:1;
			unsigned char :1;
			unsigned char ERSSPD:1;
			unsigned char PRGSPD:1;
		} BIT;
	} FSTATR0;
	union {
		unsigned char BYTE;
		struct {
			unsigned char FCUERR:1;
			unsigned char :2;
			unsigned char FLOCKST:1;
		} BIT;
	} FSTATR1;
	union {
		unsigned short WORD;
		struct {
			unsigned short FEKEY:8;
			unsigned short FENTRYD:1;
			unsigned short :3;
			unsigned short FENTRY3:1;
			unsigned short FENTRY2:1;
			unsigned short FENTRY1:1;
			unsigned short FENTRY0:1;
		} BIT;
	} FENTRYR;
	union {
		unsigned short WORD;
		struct {
			unsigned short FPKEY:8;
			unsigned short :7;
			unsigned short FPROTCN:1;
		} BIT;
	} FPROTR;
	union {
		unsigned short WORD;
		struct {
			unsigned short FRKEY:8;
			unsigned short :7;
			unsigned short FRESET:1;
		} BIT;
	} FRESETR;
	char           wk5[2];
	union {
		unsigned short WORD;
		struct {
			unsigned short CMDR:8;
			unsigned short PCMDR:8;
		} BIT;
	} FCMDR;
	char           wk6[12];
	union {
		unsigned short WORD;
		struct {
			unsigned short :15;
			unsigned short ESUSPMD:1;
		} BIT;
	} FCPSR;
	union {
		unsigned short WORD;
		struct {
			unsigned short BCSIZE:1;
			unsigned short :4;
			unsigned short BCADR:11;
		} BIT;
	} DFLBCCNT;
	union {
		unsigned short WORD;
		struct {
			unsigned short :8;
			unsigned short PEERRST:8;
		} BIT;
	} FPESTAT;
	union {
		unsigned short WORD;
		struct {
			unsigned short :15;
			unsigned short BCST:1;
		} BIT;
	} DFLBCSTAT;
	char           wk7[24];
	union {
		unsigned short WORD;
		struct {
			unsigned short :8;
			unsigned short PCKA:8;
		} BIT;
	} PCKAR;
};

struct st_flashconst {
	unsigned char  UIDR0;
	unsigned char  UIDR1;
	unsigned char  UIDR2;
	unsigned char  UIDR3;
	unsigned char  UIDR4;
	unsigned char  UIDR5;
	unsigned char  UIDR6;
	unsigned char  UIDR7;
	unsigned char  UIDR8;
	unsigned char  UIDR9;
	unsigned char  UIDR10;
	unsigned char  UIDR11;
	unsigned char  UIDR12;
	unsigned char  UIDR13;
	unsigned char  UIDR14;
	unsigned char  UIDR15;
};

struct st_icu {
	union {
		unsigned char BYTE;
		struct {
			unsigned char :7;
			unsigned char IR:1;
		} BIT;
	} IR[254];
	char           wk0[2];
	union {
		unsigned char BYTE;
		struct {
			unsigned char :7;
			unsigned char DTCE:1;
		} BIT;
	} DTCER[252];
	char           wk1[4];
	union {
		unsigned char BYTE;
		struct {
			unsigned char IEN7:1;
			unsigned char IEN6:1;
			unsigned char IEN5:1;
			unsigned char IEN4:1;
			unsigned char IEN3:1;
			unsigned char IEN2:1;
			unsigned char IEN1:1;
			unsigned char IEN0:1;
		} BIT;
	} IER[32];
	char           wk2[192];
	union {
		unsigned char BYTE;
		struct {
			unsigned char :7;
			unsigned char SWINT:1;
		} BIT;
	} SWINTR;
	char           wk3[15];
	union {
		unsigned short WORD;
		struct {
			unsigned short FIEN:1;
			unsigned short :7;
			unsigned short FVCT:8;
		} BIT;
	} FIR;
	char           wk4[14];
	union {
		unsigned char BYTE;
		struct {
			unsigned char :4;
			unsigned char IPR:4;
		} BIT;
	} IPR[254];
	char           wk5[2];
	unsigned char  DMRSR0;
	char           wk6[3];
	unsigned char  DMRSR1;
	char           wk7[3];
	unsigned char  DMRSR2;
	char           wk8[3];
	unsigned char  DMRSR3;
	char           wk9[243];
	union {
		unsigned char BYTE;
		struct {
			unsigned char :4;
			unsigned char IRQMD:2;
		} BIT;
	} IRQCR[16];
	union {
		unsigned char BYTE;
		struct {
			unsigned char FLTEN7:1;
			unsigned char FLTEN6:1;
			unsigned char FLTEN5:1;
			unsigned char FLTEN4:1;
			unsigned char FLTEN3:1;
			unsigned char FLTEN2:1;
			unsigned char FLTEN1:1;
			unsigned char FLTEN0:1;
		} BIT;
	} IRQFLTE0;
	union {
		unsigned char BYTE;
		struct {
			unsigned char FLTEN15:1;
			unsigned char FLTEN14:1;
			unsigned char FLTEN13:1;
			unsigned char FLTEN12:1;
			unsigned char FLTEN11:1;
			unsigned char FLTEN10:1;
			unsigned char FLTEN9:1;
			unsigned char FLTEN8:1;
		} BIT;
	} IRQFLTE1;
	char           wk10[2];
	union {
		unsigned short WORD;
		struct {
			unsigned short FCLKSEL7:2;
			unsigned short FCLKSEL6:2;
			unsigned short FCLKSEL5:2;
			unsigned short FCLKSEL4:2;
			unsigned short FCLKSEL3:2;
			unsigned short FCLKSEL2:2;
			unsigned short FCLKSEL1:2;
			unsigned short FCLKSEL0:2;
		} BIT;
	} IRQFLTC0;
	union {
		unsigned short WORD;
		struct {
			unsigned short FCLKSEL15:2;
			unsigned short FCLKSEL14:2;
			unsigned short FCLKSEL13:2;
			unsigned short FCLKSEL12:2;
			unsigned short FCLKSEL11:2;
			unsigned short FCLKSEL10:2;
			unsigned short FCLKSEL9:2;
			unsigned short FCLKSEL8:2;
		} BIT;
	} IRQFLTC1;
	char           wk11[104];
	union {
		unsigned char BYTE;
		struct {
			unsigned char :2;
			unsigned char LVD2ST:1;
			unsigned char LVD1ST:1;
			unsigned char IWDTST:1;
			unsigned char WDTST:1;
			unsigned char OSTST:1;
			unsigned char NMIST:1;
		} BIT;
	} NMISR;
	union {
		unsigned char BYTE;
		struct {
			unsigned char :2;
			unsigned char LVD2EN:1;
			unsigned char LVD1EN:1;
			unsigned char IWDTEN:1;
			unsigned char WDTEN:1;
			unsigned char OSTEN:1;
			unsigned char NMIEN:1;
		} BIT;
	} NMIER;
	union {
		unsigned char BYTE;
		struct {
			unsigned char :2;
			unsigned char LVD2CLR:1;
			unsigned char LVD1CLR:1;
			unsigned char IWDTCLR:1;
			unsigned char WDTCLR:1;
			unsigned char OSTCLR:1;
			unsigned char NMICLR:1;
		} BIT;
	} NMICLR;
	union {
		unsigned char BYTE;
		struct {
			unsigned char :4;
			unsigned char NMIMD:1;
		} BIT;
	} NMICR;
	char           wk12[12];
	union {
		unsigned char BYTE;
		struct {
			unsigned char :7;
			unsigned char NFLTEN:1;
		} BIT;
	} NMIFLTE;
	char           wk13[3];
	union {
		unsigned char BYTE;
		struct {
			unsigned char :6;
			unsigned char NFCLKSEL:2;
		} BIT;
	} NMIFLTC;
	char           wk14[19819];
	union {
		unsigned long LONG;
		struct {
			unsigned long :16;
			unsigned long IS15:1;
			unsigned long IS14:1;
			unsigned long IS13:1;
			unsigned long IS12:1;
			unsigned long IS11:1;
			unsigned long IS10:1;
			unsigned long IS9:1;
			unsigned long IS8:1;
			unsigned long IS7:1;
			unsigned long IS6:1;
			unsigned long IS5:1;
			unsigned long IS4:1;
			unsigned long IS3:1;
			unsigned long IS2:1;
			unsigned long IS1:1;
			unsigned long IS0:1;
		} BIT;
	} GRP[13];
	char           wk15[12];
	union {
		unsigned long LONG;
		struct {
			unsigned long :16;
			unsigned long EN15:1;
			unsigned long EN14:1;
			unsigned long EN13:1;
			unsigned long EN12:1;
			unsigned long EN11:1;
			unsigned long EN10:1;
			unsigned long EN9:1;
			unsigned long EN8:1;
			unsigned long EN7:1;
			unsigned long EN6:1;
			unsigned long EN5:1;
			unsigned long EN4:1;
			unsigned long EN3:1;
			unsigned long EN2:1;
			unsigned long EN1:1;
			unsigned long EN0:1;
		} BIT;
	} GEN[13];
	char           wk16[12];
	union {
		unsigned long LONG;
		struct {
			unsigned long :16;
			unsigned long CLR15:1;
			unsigned long CLR14:1;
			unsigned long CLR13:1;
			unsigned long CLR12:1;
			unsigned long CLR11:1;
			unsigned long CLR10:1;
			unsigned long CLR9:1;
			unsigned long CLR8:1;
			unsigned long CLR7:1;
			unsigned long CLR6:1;
			unsigned long CLR5:1;
			unsigned long CLR4:1;
			unsigned long CLR3:1;
			unsigned long CLR2:1;
			unsigned long CLR1:1;
			unsigned long CLR0:1;
		} BIT;
	} GCR[13];
	char           wk17[12];
	union {
		unsigned long LONG;
		struct {
			unsigned long :26;
			unsigned long CN5:1;
			unsigned long CN4:1;
			unsigned long CN3:1;
			unsigned long CN2:1;
			unsigned long CN1:1;
			unsigned long CN0:1;
		} BIT;
	} SEL;
};

struct st_ieb {
	union {
		unsigned char BYTE;
		struct {
			unsigned char :1;
			unsigned char IOL:1;
			unsigned char DEE:1;
			unsigned char :1;
			unsigned char RE:1;
		} BIT;
	} IECTR;
	union {
		unsigned char BYTE;
		struct {
			unsigned char :5;
			unsigned char CMD:3;
		} BIT;
	} IECMR;
	union {
		unsigned char BYTE;
		struct {
			unsigned char SS:1;
			unsigned char RN:3;
			unsigned char CTL:4;
		} BIT;
	} IEMCR;
	union {
		unsigned char BYTE;
		struct {
			unsigned char IARL4:4;
			unsigned char IMD:2;
			unsigned char :1;
			unsigned char STE:1;
		} BIT;
	} IEAR1;
	union {
		unsigned char BYTE;
		struct {
			unsigned char IARU8:8;
		} BIT;
	} IEAR2;
	union {
		unsigned char BYTE;
		struct {
			unsigned char ISAL4:4;
		} BIT;
	} IESA1;
	union {
		unsigned char BYTE;
		struct {
			unsigned char ISAU8:8;
		} BIT;
	} IESA2;
	union {
		unsigned char BYTE;
		struct {
			unsigned char IBFL:8;
		} BIT;
	} IETBFL;
	char           wk0[1];
	union {
		unsigned char BYTE;
		struct {
			unsigned char IMAL4:4;
		} BIT;
	} IEMA1;
	union {
		unsigned char BYTE;
		struct {
			unsigned char IMAU8:8;
		} BIT;
	} IEMA2;
	union {
		unsigned char BYTE;
		struct {
			unsigned char :4;
			unsigned char RCTL:4;
		} BIT;
	} IERCTL;
	union {
		unsigned char BYTE;
		struct {
			unsigned char RBFL:8;
		} BIT;
	} IERBFL;
	char           wk1[1];
	union {
		unsigned char BYTE;
		struct {
			unsigned char ILAL8:8;
		} BIT;
	} IELA1;
	union {
		unsigned char BYTE;
		struct {
			unsigned char :4;
			unsigned char ILAU4:4;
		} BIT;
	} IELA2;
	union {
		unsigned char BYTE;
		struct {
			unsigned char CMX:1;
			unsigned char MRQ:1;
			unsigned char SRQ:1;
			unsigned char SRE:1;
			unsigned char LCK:1;
			unsigned char :1;
			unsigned char RSS:1;
			unsigned char GG:1;
		} BIT;
	} IEFLG;
	union {
		unsigned char BYTE;
		struct {
			unsigned char :1;
			unsigned char TXS:1;
			unsigned char TXF:1;
			unsigned char :1;
			unsigned char TXEAL:1;
			unsigned char TXETTME:1;
			unsigned char TXERO:1;
			unsigned char TXEACK:1;
		} BIT;
	} IETSR;
	union {
		unsigned char BYTE;
		struct {
			unsigned char :1;
			unsigned char TXSE:1;
			unsigned char TXFE:1;
			unsigned char :1;
			unsigned char TXEALE:1;
			unsigned char TXETTMEE:1;
			unsigned char TXEROE:1;
			unsigned char TXEACKE:1;
		} BIT;
	} IEIET;
	char           wk2[1];
	union {
		unsigned char BYTE;
		struct {
			unsigned char RXBSY:1;
			unsigned char RXS:1;
			unsigned char RXF:1;
			unsigned char RXEDE:1;
			unsigned char RXEOVE:1;
			unsigned char RXERTME:1;
			unsigned char RXEDLE:1;
			unsigned char RXEPE:1;
		} BIT;
	} IERSR;
	union {
		unsigned char BYTE;
		struct {
			unsigned char RXBSYE:1;
			unsigned char RXSE:1;
			unsigned char RXFE:1;
			unsigned char RXEDEE:1;
			unsigned char RXEOVEE:1;
			unsigned char RXERTMEE:1;
			unsigned char RXEDLEE:1;
			unsigned char RXEPEE:1;
		} BIT;
	} IEIER;
	char           wk3[2];
	union {
		unsigned char BYTE;
		struct {
			unsigned char FLT:1;
			unsigned char FCKS:2;
			unsigned char CKS3:1;
			unsigned char SRSTP:1;
			unsigned char CKS:3;
		} BIT;
	} IECKSR;
	char           wk4[230];
	unsigned char  IETB[33];
	char           wk5[223];
	unsigned char  IERB[33];
};

struct st_iwdt {
	unsigned char  IWDTRR;
	char           wk0[1];
	union {
		unsigned short WORD;
		struct {
			unsigned short :2;
			unsigned short RPSS:2;
			unsigned short :2;
			unsigned short RPES:2;
			unsigned short CKS:4;
			unsigned short :2;
			unsigned short TOPS:2;
		} BIT;
	} IWDTCR;
	union {
		unsigned short WORD;
		struct {
			unsigned short REFEF:1;
			unsigned short UNDFF:1;
			unsigned short CNTVAL:14;
		} BIT;
	} IWDTSR;
	union {
		unsigned char BYTE;
		struct {
			unsigned char RSTIRQS:1;
		} BIT;
	} IWDTRCR;
	char           wk1[1];
	union {
		unsigned char BYTE;
		struct {
			unsigned char SLCSTP:1;
		} BIT;
	} IWDTCSTPR;
};

struct st_mpc {
	union {
		unsigned char BYTE;
		struct {
			unsigned char CS7E:1;
			unsigned char CS6E:1;
			unsigned char CS5E:1;
			unsigned char CS4E:1;
			unsigned char CS3E:1;
			unsigned char CS2E:1;
			unsigned char CS1E:1;
			unsigned char CS0E:1;
		} BIT;
	} PFCSE;
	char           wk0[1];
	union {
		unsigned char BYTE;
		struct {
			unsigned char CS3S:2;
			unsigned char CS2S:2;
			unsigned char CS1S:2;
			unsigned char :1;
			unsigned char CS0S:1;
		} BIT;
	} PFCSS0;
	union {
		unsigned char BYTE;
		struct {
			unsigned char CS7S:2;
			unsigned char CS6S:2;
			unsigned char CS5S:2;
			unsigned char CS4S:2;
		} BIT;
	} PFCSS1;
	union {
		unsigned char BYTE;
		struct {
			unsigned char A15E:1;
			unsigned char A14E:1;
			unsigned char A13E:1;
			unsigned char A12E:1;
			unsigned char A11E:1;
			unsigned char A10E:1;
			unsigned char A9E:1;
			unsigned char A8E:1;
		} BIT;
	} PFAOE0;
	union {
		unsigned char BYTE;
		struct {
			unsigned char A23E:1;
			unsigned char A22E:1;
			unsigned char A21E:1;
			unsigned char A20E:1;
			unsigned char A19E:1;
			unsigned char A18E:1;
			unsigned char A17E:1;
			unsigned char A16E:1;
		} BIT;
	} PFAOE1;
	union {
		unsigned char BYTE;
		struct {
			unsigned char WR32BC32E:1;
			unsigned char WR1BC1E:1;
			unsigned char DH32E:1;
			unsigned char DHE:1;
			unsigned char :2;
			unsigned char ADRHMS:1;
			unsigned char ADRLE:1;
		} BIT;
	} PFBCR0;
	union {
		unsigned char BYTE;
		struct {
			unsigned char SDCLKE:1;
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
			unsigned short INV:1;
		} BIT;
	} MPOPI;
	union {
		unsigned long LONG;
		struct {
			unsigned long :8;
			unsigned long HITI:8;
			unsigned long :12;
			unsigned long UHACI:3;
		} BIT;
	} MHITI;
	union {
		unsigned long LONG;
		struct {
			unsigned long :8;
			unsigned long HITD:8;
			unsigned long :12;
			unsigned long UHACD:3;
		} BIT;
	} MHITD;
};

struct st_mtu {
	union {
		unsigned char BYTE;
		struct {
			unsigned char :2;
			unsigned char OE4D:1;
			unsigned char OE4C:1;
			unsigned char OE3D:1;
			unsigned char OE4B:1;
			unsigned char OE4A:1;
			unsigned char OE3B:1;
		} BIT;
	} TOER;
	char           wk0[2];
	union {
		unsigned char BYTE;
		struct {
			unsigned char :1;
			unsigned char BDC:1;
			unsigned char N:1;
			unsigned char P:1;
			unsigned char FB:1;
			unsigned char WF:1;
			unsigned char VF:1;
			unsigned char UF:1;
		} BIT;
	} TGCR;
	union {
		unsigned char BYTE;
		struct {
			unsigned char :1;
			unsigned char PSYE:1;
			unsigned char :2;
			unsigned char TOCL:1;
			unsigned char TOCS:1;
			unsigned char OLSN:1;
			unsigned char OLSP:1;
		} BIT;
	} TOCR1;
	union {
		unsigned char BYTE;
		struct {
			unsigned char BF:2;
			unsigned char OLS3N:1;
			unsigned char OLS3P:1;
			unsigned char OLS2N:1;
			unsigned char OLS2P:1;
			unsigned char OLS1N:1;
			unsigned char OLS1P:1;
		} BIT;
	} TOCR2;
	char           wk1[4];
	unsigned short TCDR;
	unsigned short TDDR;
	char           wk2[8];
	unsigned short TCNTS;
	unsigned short TCBR;
	char           wk3[12];
	union {
		unsigned char BYTE;
		struct {
			unsigned char T3AEN:1;
			unsigned char T3ACOR:3;
			unsigned char T4VEN:1;
			unsigned char T4VCOR:3;
		} BIT;
	} TITCR;
	union {
		unsigned char BYTE;
		struct {
			unsigned char :1;
			unsigned char T3ACNT:3;
			unsigned char :1;
			unsigned char T4VCNT:3;
		} BIT;
	} TITCNT;
	union {
		unsigned char BYTE;
		struct {
			unsigned char :6;
			unsigned char BTE:2;
		} BIT;
	} TBTER;
	char           wk4[1];
	union {
		unsigned char BYTE;
		struct {
			unsigned char :7;
			unsigned char TDER:1;
		} BIT;
	} TDER;
	char           wk5[1];
	union {
		unsigned char BYTE;
		struct {
			unsigned char :2;
			unsigned char OLS3N:1;
			unsigned char OLS3P:1;
			unsigned char OLS2N:1;
			unsigned char OLS2P:1;
			unsigned char OLS1N:1;
			unsigned char OLS1P:1;
		} BIT;
	} TOLBR;
	char           wk6[41];
	union {
		unsigned char BYTE;
		struct {
			unsigned char CCE:1;
			unsigned char :6;
			unsigned char WRE:1;
		} BIT;
	} TWCR;
	char           wk7[31];
	union {
		unsigned char BYTE;
		struct {
			unsigned char CST4:1;
			unsigned char CST3:1;
			unsigned char :3;
			unsigned char CST2:1;
			unsigned char CST1:1;
			unsigned char CST0:1;
		} BIT;
	} TSTR;
	union {
		unsigned char BYTE;
		struct {
			unsigned char SYNC4:1;
			unsigned char SYNC3:1;
			unsigned char :3;
			unsigned char SYNC2:1;
			unsigned char SYNC1:1;
			unsigned char SYNC0:1;
		} BIT;
	} TSYR;
	char           wk8[2];
	union {
		unsigned char BYTE;
		struct {
			unsigned char :7;
			unsigned char RWE:1;
		} BIT;
	} TRWER;
};

struct st_mtu0 {
	union {
		unsigned char BYTE;
		struct {
			unsigned char :2;
			unsigned char NFCS:2;
			unsigned char NFDEN:1;
			unsigned char NFCEN:1;
			unsigned char NFBEN:1;
			unsigned char NFAEN:1;
		} BIT;
	} NFCR;
	char           wk0[111];
	union {
		unsigned char BYTE;
		struct {
			unsigned char CCLR:3;
			unsigned char CKEG:2;
			unsigned char TPSC:3;
		} BIT;
	} TCR;
	union {
		unsigned char BYTE;
		struct {
			unsigned char :1;
			unsigned char BFE:1;
			unsigned char BFB:1;
			unsigned char BFA:1;
			unsigned char MD:4;
		} BIT;
	} TMDR;
	union {
		unsigned char BYTE;
		struct {
			unsigned char IOB:4;
			unsigned char IOA:4;
		} BIT;
	} TIORH;
	union {
		unsigned char BYTE;
		struct {
			unsigned char IOD:4;
			unsigned char IOC:4;
		} BIT;
	} TIORL;
	union {
		unsigned char BYTE;
		struct {
			unsigned char TTGE:1;
			unsigned char :2;
			unsigned char TCIEV:1;
			unsigned char TGIED:1;
			unsigned char TGIEC:1;
			unsigned char TGIEB:1;
			unsigned char TGIEA:1;
		} BIT;
	} TIER;
	union {
		unsigned char BYTE;
		struct {
			unsigned char TCFD:1;
		} BIT;
	} TSR;
	unsigned short TCNT;
	unsigned short TGRA;
	unsigned short TGRB;
	unsigned short TGRC;
	unsigned short TGRD;
	char           wk1[16];
	unsigned short TGRE;
	unsigned short TGRF;
	union {
		unsigned char BYTE;
		struct {
			unsigned char :6;
			unsigned char TGIEF:1;
			unsigned char TGIEE:1;
		} BIT;
	} TIER2;
	char           wk2[1];
	union {
		unsigned char BYTE;
		struct {
			unsigned char :5;
			unsigned char TTSE:1;
			unsigned char TTSB:1;
			unsigned char TTSA:1;
		} BIT;
	} TBTM;
};

struct st_mtu1 {
	char           wk0[1];
	union {
		unsigned char BYTE;
		struct {
			unsigned char :2;
			unsigned char NFCS:2;
			unsigned char NFDEN:1;
			unsigned char NFCEN:1;
			unsigned char NFBEN:1;
			unsigned char NFAEN:1;
		} BIT;
	} NFCR;
	char           wk1[238];
	union {
		unsigned char BYTE;
		struct {
			unsigned char :1;
			unsigned char CCLR:2;
			unsigned char CKEG:2;
			unsigned char TPSC:3;
		} BIT;
	} TCR;
	union {
		unsigned char BYTE;
		struct {
			unsigned char :4;
			unsigned char MD:4;
		} BIT;
	} TMDR;
	union {
		unsigned char BYTE;
		struct {
			unsigned char IOB:4;
			unsigned char IOA:4;
		} BIT;
	} TIOR;
	char           wk2[1];
	union {
		unsigned char BYTE;
		struct {
			unsigned char TTGE:1;
			unsigned char :1;
			unsigned char TCIEU:1;
			unsigned char TCIEV:1;
			unsigned char :2;
			unsigned char TGIEB:1;
			unsigned char TGIEA:1;
		} BIT;
	} TIER;
	union {
		unsigned char BYTE;
		struct {
			unsigned char TCFD:1;
		} BIT;
	} TSR;
	unsigned short TCNT;
	unsigned short TGRA;
	unsigned short TGRB;
	char           wk3[4];
	union {
		unsigned char BYTE;
		struct {
			unsigned char :4;
			unsigned char I2BE:1;
			unsigned char I2AE:1;
			unsigned char I1BE:1;
			unsigned char I1AE:1;
		} BIT;
	} TICCR;
};

struct st_mtu2 {
	union {
		unsigned char BYTE;
		struct {
			unsigned char :2;
			unsigned char NFCS:2;
			unsigned char NFDEN:1;
			unsigned char NFCEN:1;
			unsigned char NFBEN:1;
			unsigned char NFAEN:1;
		} BIT;
	} NFCR;
	char           wk0[365];
	union {
		unsigned char BYTE;
		struct {
			unsigned char :1;
			unsigned char CCLR:2;
			unsigned char CKEG:2;
			unsigned char TPSC:3;
		} BIT;
	} TCR;
	union {
		unsigned char BYTE;
		struct {
			unsigned char :4;
			unsigned char MD:4;
		} BIT;
	} TMDR;
	union {
		unsigned char BYTE;
		struct {
			unsigned char IOB:4;
			unsigned char IOA:4;
		} BIT;
	} TIOR;
	char           wk1[1];
	union {
		unsigned char BYTE;
		struct {
			unsigned char TTGE:1;
			unsigned char :1;
			unsigned char TCIEU:1;
			unsigned char TCIEV:1;
			unsigned char :2;
			unsigned char TGIEB:1;
			unsigned char TGIEA:1;
		} BIT;
	} TIER;
	union {
		unsigned char BYTE;
		struct {
			unsigned char TCFD:1;
		} BIT;
	} TSR;
	unsigned short TCNT;
	unsigned short TGRA;
	unsigned short TGRB;
};

struct st_mtu3 {
	union {
		unsigned char BYTE;
		struct {
			unsigned char CCLR:3;
			unsigned char CKEG:2;
			unsigned char TPSC:3;
		} BIT;
	} TCR;
	char           wk0[1];
	union {
		unsigned char BYTE;
		struct {
			unsigned char :2;
			unsigned char BFB:1;
			unsigned char BFA:1;
			unsigned char MD:4;
		} BIT;
	} TMDR;
	char           wk1[1];
	union {
		unsigned char BYTE;
		struct {
			unsigned char IOB:4;
			unsigned char IOA:4;
		} BIT;
	} TIORH;
	union {
		unsigned char BYTE;
		struct {
			unsigned char IOD:4;
			unsigned char IOC:4;
		} BIT;
	} TIORL;
	char           wk2[2];
	union {
		unsigned char BYTE;
		struct {
			unsigned char TTGE:1;
			unsigned char :2;
			unsigned char TCIEV:1;
			unsigned char TGIED:1;
			unsigned char TGIEC:1;
			unsigned char TGIEB:1;
			unsigned char TGIEA:1;
		} BIT;
	} TIER;
	char           wk3[7];
	unsigned short TCNT;
	char           wk4[6];
	unsigned short TGRA;
	unsigned short TGRB;
	char           wk5[8];
	unsigned short TGRC;
	unsigned short TGRD;
	char           wk6[4];
	union {
		unsigned char BYTE;
		struct {
			unsigned char TCFD:1;
		} BIT;
	} TSR;
	char           wk7[11];
	union {
		unsigned char BYTE;
		struct {
			unsigned char :5;
			unsigned char TTSE:1;
			unsigned char TTSB:1;
			unsigned char TTSA:1;
		} BIT;
	} TBTM;
	char           wk8[90];
	union {
		unsigned char BYTE;
		struct {
			unsigned char :2;
			unsigned char NFCS:2;
			unsigned char NFDEN:1;
			unsigned char NFCEN:1;
			unsigned char NFBEN:1;
			unsigned char NFAEN:1;
		} BIT;
	} NFCR;
};

struct st_mtu4 {
	char           wk0[1];
	union {
		unsigned char BYTE;
		struct {
			unsigned char CCLR:3;
			unsigned char CKEG:2;
			unsigned char TPSC:3;
		} BIT;
	} TCR;
	char           wk1[1];
	union {
		unsigned char BYTE;
		struct {
			unsigned char :2;
			unsigned char BFB:1;
			unsigned char BFA:1;
			unsigned char MD:4;
		} BIT;
	} TMDR;
	char           wk2[2];
	union {
		unsigned char BYTE;
		struct {
			unsigned char IOB:4;
			unsigned char IOA:4;
		} BIT;
	} TIORH;
	union {
		unsigned char BYTE;
		struct {
			unsigned char IOD:4;
			unsigned char IOC:4;
		} BIT;
	} TIORL;
	char           wk3[1];
	union {
		unsigned char BYTE;
		struct {
			unsigned char TTGE:1;
			unsigned char TTGE2:1;
			unsigned char :1;
			unsigned char TCIEV:1;
			unsigned char TGIED:1;
			unsigned char TGIEC:1;
			unsigned char TGIEB:1;
			unsigned char TGIEA:1;
		} BIT;
	} TIER;
	char           wk4[8];
	unsigned short TCNT;
	char           wk5[8];
	unsigned short TGRA;
	unsigned short TGRB;
	char           wk6[8];
	unsigned short TGRC;
	unsigned short TGRD;
	char           wk7[1];
	union {
		unsigned char BYTE;
		struct {
			unsigned char TCFD:1;
		} BIT;
	} TSR;
	char           wk8[11];
	union {
		unsigned char BYTE;
		struct {
			unsigned char :5;
			unsigned char TTSE:1;
			unsigned char TTSB:1;
			unsigned char TTSA:1;
		} BIT;
	} TBTM;
	char           wk9[6];
	union {
		unsigned short WORD;
		struct {
			unsigned short BF:2;
			unsigned short :6;
			unsigned short UT4AE:1;
			unsigned short DT4AE:1;
			unsigned short UT4BE:1;
			unsigned short DT4BE:1;
			unsigned short ITA3AE:1;
			unsigned short ITA4VE:1;
			unsigned short ITB3AE:1;
			unsigned short ITB4VE:1;
		} BIT;
	} TADCR;
	char           wk10[2];
	unsigned short TADCORA;
	unsigned short TADCORB;
	unsigned short TADCOBRA;
	unsigned short TADCOBRB;
	char           wk11[72];
	union {
		unsigned char BYTE;
		struct {
			unsigned char :2;
			unsigned char NFCS:2;
			unsigned char NFDEN:1;
			unsigned char NFCEN:1;
			unsigned char NFBEN:1;
			unsigned char NFAEN:1;
		} BIT;
	} NFCR;
};

struct st_mtu5 {
	char           wk0[1];
	union {
		unsigned char BYTE;
		struct {
			unsigned char :2;
			unsigned char NFCS:2;
			unsigned char :1;
			unsigned char NFWEN:1;
			unsigned char NFVEN:1;
			unsigned char NFUEN:1;
		} BIT;
	} NFCR;
	char           wk1[490];
	unsigned short TCNTU;
	unsigned short TGRU;
	union {
		unsigned char BYTE;
		struct {
			unsigned char :6;
			unsigned char TPSC:2;
		} BIT;
	} TCRU;
	char           wk2[1];
	union {
		unsigned char BYTE;
		struct {
			unsigned char :3;
			unsigned char IOC:5;
		} BIT;
	} TIORU;
	char           wk3[9];
	unsigned short TCNTV;
	unsigned short TGRV;
	union {
		unsigned char BYTE;
		struct {
			unsigned char :6;
			unsigned char TPSC:2;
		} BIT;
	} TCRV;
	char           wk4[1];
	union {
		unsigned char BYTE;
		struct {
			unsigned char :3;
			unsigned char IOC:5;
		} BIT;
	} TIORV;
	char           wk5[9];
	unsigned short TCNTW;
	unsigned short TGRW;
	union {
		unsigned char BYTE;
		struct {
			unsigned char :6;
			unsigned char TPSC:2;
		} BIT;
	} TCRW;
	char           wk6[1];
	union {
		unsigned char BYTE;
		struct {
			unsigned char :3;
			unsigned char IOC:5;
		} BIT;
	} TIORW;
	char           wk7[11];
	union {
		unsigned char BYTE;
		struct {
			unsigned char :5;
			unsigned char TGIE5U:1;
			unsigned char TGIE5V:1;
			unsigned char TGIE5W:1;
		} BIT;
	} TIER;
	char           wk8[1];
	union {
		unsigned char BYTE;
		struct {
			unsigned char :5;
			unsigned char CSTU5:1;
			unsigned char CSTV5:1;
			unsigned char CSTW5:1;
		} BIT;
	} TSTR;
	char           wk9[1];
	union {
		unsigned char BYTE;
		struct {
			unsigned char :5;
			unsigned char CMPCLR5U:1;
			unsigned char CMPCLR5V:1;
			unsigned char CMPCLR5W:1;
		} BIT;
	} TCNTCMPCLR;
};

struct st_poe {
	union {
		unsigned short WORD;
		struct {
			unsigned short POE3F:1;
			unsigned short POE2F:1;
			unsigned short POE1F:1;
			unsigned short POE0F:1;
			unsigned short :3;
			unsigned short PIE1:1;
			unsigned short POE3M:2;
			unsigned short POE2M:2;
			unsigned short POE1M:2;
			unsigned short POE0M:2;
		} BIT;
	} ICSR1;
	union {
		unsigned short WORD;
		struct {
			unsigned short OSF1:1;
			unsigned short :5;
			unsigned short OCE1:1;
			unsigned short OIE1:1;
		} BIT;
	} OCSR1;
	char           wk0[4];
	union {
		unsigned short WORD;
		struct {
			unsigned short :3;
			unsigned short POE8F:1;
			unsigned short :2;
			unsigned short POE8E:1;
			unsigned short PIE2:1;
			unsigned short :6;
			unsigned short POE8M:2;
		} BIT;
	} ICSR2;
	union {
		unsigned char BYTE;
		struct {
			unsigned char :6;
			unsigned char CH0HIZ:1;
			unsigned char CH34HIZ:1;
		} BIT;
	} SPOER;
	union {
		unsigned char BYTE;
		struct {
			unsigned char :4;
			unsigned char PE3ZE:1;
			unsigned char PE2ZE:1;
			unsigned char PE1ZE:1;
			unsigned char PE0ZE:1;
		} BIT;
	} POECR1;
	union {
		unsigned char BYTE;
		struct {
			unsigned char :1;
			unsigned char P1CZEA:1;
			unsigned char P2CZEA:1;
			unsigned char P3CZEA:1;
		} BIT;
	} POECR2;
	char           wk1[1];
	union {
		unsigned short WORD;
		struct {
			unsigned short :3;
			unsigned short OSTSTF:1;
			unsigned short :2;
			unsigned short OSTSTE:1;
		} BIT;
	} ICSR3;
};

struct st_pdc {
	union {
		unsigned long LONG;
		struct {
			unsigned long :17;
			unsigned long EDS:1;
			unsigned long PCKDIV:3;
			unsigned long PCKOE:1;
			unsigned long HERIE:1;
			unsigned long VERIE:1;
			unsigned long UDRIE:1;
			unsigned long OVIE:1;
			unsigned long FEIE:1;
			unsigned long DFIE:1;
			unsigned long PRST:1;
			unsigned long HPS:1;
			unsigned long VPS:1;
			unsigned long PCKE:1;
		} BIT;
	} PCCR0;
	union {
		unsigned long LONG;
		struct {
			unsigned long :31;
			unsigned long PCE:1;
		} BIT;
	} PCCR1;
	union {
		unsigned long LONG;
		struct {
			unsigned long :25;
			unsigned long HERF:1;
			unsigned long VERF:1;
			unsigned long UDRF:1;
			unsigned long OVRF:1;
			unsigned long FEF:1;
			unsigned long FEMPF:1;
			unsigned long FBSY:1;
		} BIT;
	} PCSR;
	union {
		unsigned long LONG;
		struct {
			unsigned long :30;
			unsigned long HSYNC:1;
			unsigned long VSYNC:1;
		} BIT;
	} PCMONR;
	union {
		unsigned long LONG;
	} PCDR;
	union {
		unsigned long LONG;
		struct {
			unsigned long :4;
			unsigned long VSZ:12;
			unsigned long :4;
			unsigned long VST:12;
		} BIT;
	} VCR;
	union {
		unsigned long LONG;
		struct {
			unsigned long :4;
			unsigned long HSZ:12;
			unsigned long :4;
			unsigned long HST:12;
		} BIT;
	} HCR;
};

struct st_port {
	union {
		unsigned char BYTE;
		struct {
			unsigned char :2;
			unsigned char PSEL5:1;
			unsigned char :1;
			unsigned char PSEL3:1;
			unsigned char :1;
			unsigned char PSEL1:1;
			unsigned char PSEL0:1;
		} BIT;
	} PSRB;
	union {
		unsigned char BYTE;
		struct {
			unsigned char PSEL7:1;
			unsigned char PSEL6:1;
		} BIT;
	} PSRA;
};

struct st_port0 {
	union {
		unsigned char BYTE;
		struct {
			unsigned char B7:1;
			unsigned char :1;
			unsigned char B5:1;
			unsigned char :1;
			unsigned char B3:1;
			unsigned char B2:1;
			unsigned char B1:1;
			unsigned char B0:1;
		} BIT;
	} PDR;
	char           wk0[31];
	union {
		unsigned char BYTE;
		struct {
			unsigned char B7:1;
			unsigned char :1;
			unsigned char B5:1;
			unsigned char :1;
			unsigned char B3:1;
			unsigned char B2:1;
			unsigned char B1:1;
			unsigned char B0:1;
		} BIT;
	} PODR;
	char           wk1[31];
	union {
		unsigned char BYTE;
		struct {
			unsigned char B7:1;
			unsigned char :1;
			unsigned char B5:1;
			unsigned char :1;
			unsigned char B3:1;
			unsigned char B2:1;
			unsigned char B1:1;
			unsigned char B0:1;
		} BIT;
	} PIDR;
	char           wk2[31];
	union {
		unsigned char BYTE;
		struct {
			unsigned char B7:1;
			unsigned char :1;
			unsigned char B5:1;
			unsigned char :1;
			unsigned char B3:1;
			unsigned char B2:1;
			unsigned char B1:1;
			unsigned char B0:1;
		} BIT;
	} PMR;
	char           wk3[31];
	union {
		unsigned char BYTE;
		struct {
			unsigned char :1;
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
		} BIT;
	} PCR;
	char           wk5[31];
	union {
		unsigned char BYTE;
		struct {
			unsigned char B7:1;
			unsigned char B6:1;
			unsigned char B5:1;
			unsigned char B4:1;
			unsigned char B3:1;
			unsigned char B2:1;
			unsigned char B1:1;
			unsigned char B0:1;
		} BIT;
	} DSCR;
};
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
