AYATAKA-WORKs/AliCe/Src/AliCe/src/speaker_func.cpp

/*
 * speaker_func.cpp
 *
 *  Created on: 2016/10/24
 *      Author: KOTA-NPC2
 */

#include "iodefine.h"
#include "interrupt.h"
#include "speaker_func.h"
#include "Serial.h"
#include <math.h>
#include <stdlib.h>


void speaker_on(int frq, float beat, int bpm) {

	if (frq != REST) {
		TPU5.TGRA = (int) (12500000 / frq) - 1;
		TPU5.TGRB = TPU5.TGRA / 2;
		CSTR(TPU5) = 1; //カウンタ開始
	}
	wait_timer((int) (60000.0f / bpm * 4.0f / beat - 10.0f));
	CSTR(TPU5) = 0; //カウンタ停止
	PORT3.PODR.BIT.B1 = (int) (rand() * (2.0) / (1.0 + RAND_MAX));
	PORT2.PODR.BIT.B7 = (int) (rand() * (2.0) / (1.0 + RAND_MAX));
	PORT5.PODR.BIT.B5 = (int) (rand() * (2.0) / (1.0 + RAND_MAX));
	PORT5.PODR.BIT.B4 = (int) (rand() * (2.0) / (1.0 + RAND_MAX));
	PORTA.PODR.BIT.B4 = (int) (rand() * (2.0) / (1.0 + RAND_MAX));
	PORTE.PODR.BIT.B5 = (int) (rand() * (2.0) / (1.0 + RAND_MAX));
	wait_timer(10);
}

void buzzer_on(int frq, float beat, int bpm) {

	if (frq != REST) {
		TPU5.TGRA = (int) (12500000 / frq) - 1;
		TPU5.TGRB = TPU5.TGRA / 2;
		CSTR(TPU5) = 1; //カウンタ開始
	}
	wait_timer((int) (60000.0f / bpm * 4.0f / beat - 10.0f));
	CSTR(TPU5) = 0; //カウンタ停止
	wait_timer(10);
}

void speaker_on2(int frq, float beat, int seqNum, int *nowSeq, int bpm) {
	if (seqNum == *nowSeq) {
		if (frq != REST) {
			TPU5.TGRA = (int) (12500000 / frq) - 1;
			TPU5.TGRB = TPU5.TGRA / 2;
			CSTR(TPU5) = 1; //カウンタ開始
		}
		if (counter((int) (60000.0f / bpm * 4.0f / beat))) {
			CSTR(TPU5) = 0; //カウンタ停止
			PORT3.PODR.BIT.B1 = (int) (rand() * (2.0) / (1.0 + RAND_MAX));
			PORT2.PODR.BIT.B7 = (int) (rand() * (2.0) / (1.0 + RAND_MAX));
			PORT5.PODR.BIT.B5 = (int) (rand() * (2.0) / (1.0 + RAND_MAX));
			PORT5.PODR.BIT.B4 = (int) (rand() * (2.0) / (1.0 + RAND_MAX));
			PORTA.PODR.BIT.B4 = (int) (rand() * (2.0) / (1.0 + RAND_MAX));
			PORTE.PODR.BIT.B5 = (int) (rand() * (2.0) / (1.0 + RAND_MAX));
			(*nowSeq)++;
		}
	}
}

void SpeakerDisable(void) {
	PORTB.PMR.BIT.B7 = 0x0u;	//PB7:I/Oを使用
	PORTB.PDR.BIT.B7 = 1;		//PB7：出力
	PORTB.PODR.BIT.B7 = 0;		//PB7：L
}

void SpeakerEnable(void) {
	PORTB.PMR.BIT.B7 = 0x1u;	//PB7:周辺機能を使用
}

void StartUpSound(int bpm, int pitch) {
	speaker_on(pitch * A_4, 8.000000, bpm);
	speaker_on(pitch * REST, 8.000000, bpm);
	speaker_on(pitch * F_4, 2.666667, bpm);
	speaker_on(pitch * REST, 32.000000, bpm);
	speaker_on(pitch * C_4, 8.000000, bpm);
	speaker_on(pitch * REST, 8.000000, bpm);
	speaker_on(pitch * C_5, 8.000000, bpm);
	speaker_on(pitch * REST, 4.000000, bpm);
	speaker_on(pitch * A_4, 1.432836, bpm);
}

//void WelcomeToTheJapariPark(int bpm, int pitch) {
//	static int nowSeq = 1;
//	static int stflag = 0;
//	if (stflag == 0) {
//		stflag = 1;
//		g_cnt2 = 0;
//	}
//	/*MIDI*/
//	/*MIDI*/
//	speaker_on2( pitch *REST , 256.000000 , 1, &nowSeq, bpm );
//	speaker_on2( pitch *REST , 256.000000 , 2, &nowSeq, bpm );
//	speaker_on2( pitch *REST , 256.000000 , 3, &nowSeq, bpm );
//	speaker_on2( pitch *REST , 256.000000 , 4, &nowSeq, bpm );
//	speaker_on2( pitch *REST , 256.000000 , 5, &nowSeq, bpm );
//	speaker_on2( pitch *REST , 16.000000 , 6, &nowSeq, bpm );
//	speaker_on2( pitch *G_5 , 16.000000 , 7, &nowSeq, bpm );
//	speaker_on2( pitch *REST , 16.000000 , 8, &nowSeq, bpm );
//	speaker_on2( pitch *Ab_5 , 16.000000 , 9, &nowSeq, bpm );
//	speaker_on2( pitch *REST , 16.000000 , 10, &nowSeq, bpm );
//	speaker_on2( pitch *Bb_5 , 16.000000 , 11, &nowSeq, bpm );
//	speaker_on2( pitch *REST , 16.000000 , 12, &nowSeq, bpm );
//	speaker_on2( pitch *C_6 , 5.333333 , 13, &nowSeq, bpm );
//	speaker_on2( pitch *REST , 16.000000 , 14, &nowSeq, bpm );
//	speaker_on2( pitch *C_6 , 5.333333 , 15, &nowSeq, bpm );
//	speaker_on2( pitch *REST , 16.000000 , 16, &nowSeq, bpm );
//	speaker_on2( pitch *C_6 , 16.000000 , 17, &nowSeq, bpm );
//	speaker_on2( pitch *REST , 16.000000 , 18, &nowSeq, bpm );
//	speaker_on2( pitch *C_6 , 5.333333 , 19, &nowSeq, bpm );
//	speaker_on2( pitch *REST , 16.000000 , 20, &nowSeq, bpm );
//	speaker_on2( pitch *Bb_5 , 5.333333 , 21, &nowSeq, bpm );
//	speaker_on2( pitch *REST , 16.000000 , 22, &nowSeq, bpm );
//	speaker_on2( pitch *Bb_5 , 16.000000 , 23, &nowSeq, bpm );
//	speaker_on2( pitch *REST , 16.000000 , 24, &nowSeq, bpm );
//	speaker_on2( pitch *Ab_5 , 16.000000 , 25, &nowSeq, bpm );
//	speaker_on2( pitch *REST , 16.000000 , 26, &nowSeq, bpm );
//	speaker_on2( pitch *Ab_5 , 16.000000 , 27, &nowSeq, bpm );
//	speaker_on2( pitch *REST , 16.000000 , 28, &nowSeq, bpm );
//	speaker_on2( pitch *G_5 , 16.000000 , 29, &nowSeq, bpm );
//	speaker_on2( pitch *REST , 16.000000 , 30, &nowSeq, bpm );
//	speaker_on2( pitch *Ab_5 , 16.000000 , 31, &nowSeq, bpm );
//	speaker_on2( pitch *REST , 16.000000 , 32, &nowSeq, bpm );
//	speaker_on2( pitch *G_5 , 16.000000 , 33, &nowSeq, bpm );
//	speaker_on2( pitch *REST , 16.000000 , 34, &nowSeq, bpm );
//	speaker_on2( pitch *F_5 , 16.000000 , 35, &nowSeq, bpm );
//	speaker_on2( pitch *REST , 16.000000 , 36, &nowSeq, bpm );
//	speaker_on2( pitch *Eb_5 , 5.333333 , 37, &nowSeq, bpm );
//	speaker_on2( pitch *REST , 16.000000 , 38, &nowSeq, bpm );
//	speaker_on2( pitch *Bb_5 , 5.333333 , 39, &nowSeq, bpm );
//	speaker_on2( pitch *REST , 16.000000 , 40, &nowSeq, bpm );
//	speaker_on2( pitch *Eb_5 , 3.200000 , 41, &nowSeq, bpm );
//	speaker_on2( pitch *REST , 16.000000 , 42, &nowSeq, bpm );
//	speaker_on2( pitch *Bb_5 , 5.333333 , 43, &nowSeq, bpm );
//	speaker_on2( pitch *REST , 16.000000 , 44, &nowSeq, bpm );
//	speaker_on2( pitch *C_6 , 16.000000 , 45, &nowSeq, bpm );
//	speaker_on2( pitch *REST , 16.000000 , 46, &nowSeq, bpm );
//	speaker_on2( pitch *Bb_5 , 16.000000 , 47, &nowSeq, bpm );
//	speaker_on2( pitch *REST , 16.000000 , 48, &nowSeq, bpm );
//	speaker_on2( pitch *Ab_5 , 16.000000 , 49, &nowSeq, bpm );
//	speaker_on2( pitch *REST , 16.000000 , 50, &nowSeq, bpm );
//	speaker_on2( pitch *G_5 , 2.285714 , 51, &nowSeq, bpm );
//	speaker_on2( pitch *REST , 16.000000 , 52, &nowSeq, bpm );
//	speaker_on2( pitch *Ab_5 , 5.333333 , 53, &nowSeq, bpm );
//	speaker_on2( pitch *REST , 16.000000 , 54, &nowSeq, bpm );
//	speaker_on2( pitch *Ab_5 , 5.333333 , 55, &nowSeq, bpm );
//	speaker_on2( pitch *REST , 16.000000 , 56, &nowSeq, bpm );
//	speaker_on2( pitch *Ab_5 , 16.000000 , 57, &nowSeq, bpm );
//	speaker_on2( pitch *REST , 16.000000 , 58, &nowSeq, bpm );
//	speaker_on2( pitch *Ab_5 , 5.333333 , 59, &nowSeq, bpm );
//	speaker_on2( pitch *REST , 16.000000 , 60, &nowSeq, bpm );
//	speaker_on2( pitch *G_5 , 5.333333 , 61, &nowSeq, bpm );
//	speaker_on2( pitch *REST , 16.000000 , 62, &nowSeq, bpm );
//	speaker_on2( pitch *G_5 , 16.000000 , 63, &nowSeq, bpm );
//	speaker_on2( pitch *REST , 16.000000 , 64, &nowSeq, bpm );
//	speaker_on2( pitch *B_5 , 16.000000 , 65, &nowSeq, bpm );
//	speaker_on2( pitch *REST , 16.000000 , 66, &nowSeq, bpm );
//	speaker_on2( pitch *C_6 , 3.200000 , 67, &nowSeq, bpm );
//	speaker_on2( pitch *REST , 16.000000 , 68, &nowSeq, bpm );
//	speaker_on2( pitch *F_5 , 16.000000 , 69, &nowSeq, bpm );
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
//	speaker_on2( pitch *REST , 1920.000000 , 650, &nowSeq, bpm );
//	speaker_on2( pitch *C_6 , 8.033473 , 651, &nowSeq, bpm );
//	speaker_on2( pitch *REST , 1920.000000 , 652, &nowSeq, bpm );
//	speaker_on2( pitch *Bb_5 , 2.666667 , 653, &nowSeq, bpm );
//}

void WelcomeToTheJapariPark(int bpm, int pitch) {
	static int nowSeq = 1;
	static int stflag = 0;
	if (stflag == 0) {
		stflag = 1;
		g_cnt2 = 0;
	}
	/*MIDI*/
	speaker_on2( pitch *A_4 , 8.000000 , 1, &nowSeq, bpm );
	speaker_on2( pitch *REST , 8.000000 , 2, &nowSeq, bpm );
	speaker_on2( pitch *F_4 , 2.666667 , 3, &nowSeq, bpm );
	speaker_on2( pitch *REST , 32.000000 , 4, &nowSeq, bpm );
	speaker_on2( pitch *C_4 , 8.000000 , 5, &nowSeq, bpm );
	speaker_on2( pitch *REST , 8.000000 , 6, &nowSeq, bpm );
	speaker_on2( pitch *C_5 , 8.000000 , 7, &nowSeq, bpm );
	speaker_on2( pitch *REST , 4.000000 , 8, &nowSeq, bpm );
	speaker_on2( pitch *A_4 , 1.432836 , 9, &nowSeq, bpm );
	speaker_on2( pitch *REST , 8.000000 , 10, &nowSeq, bpm );
	speaker_on2( pitch *F_4 , 8.000000 , 11, &nowSeq, bpm );
	speaker_on2( pitch *E_4 , 8.000000 , 12, &nowSeq, bpm );
	speaker_on2( pitch *F_4 , 8.000000 , 13, &nowSeq, bpm );
	speaker_on2( pitch *G_4 , 4.000000 , 14, &nowSeq, bpm );
	speaker_on2( pitch *F_4 , 8.000000 , 15, &nowSeq, bpm );
	speaker_on2( pitch *G_4 , 8.000000 , 16, &nowSeq, bpm );
	speaker_on2( pitch *A_4 , 4.000000 , 17, &nowSeq, bpm );
	speaker_on2( pitch *Bb_4 , 8.000000 , 18, &nowSeq, bpm );
	speaker_on2( pitch *B_4 , 8.000000 , 19, &nowSeq, bpm );
	speaker_on2( pitch *C_5 , 4.000000 , 20, &nowSeq, bpm );
	speaker_on2( pitch *A_4 , 8.000000 , 21, &nowSeq, bpm );
	speaker_on2( pitch *G_4 , 8.000000 , 22, &nowSeq, bpm );
	speaker_on2( pitch *F_4 , 8.000000 , 23, &nowSeq, bpm );
	speaker_on2( pitch *F_4 , 8.000000 , 24, &nowSeq, bpm );
	speaker_on2( pitch *REST , 8.000000 , 25, &nowSeq, bpm );
	speaker_on2( pitch *D_5 , 8.000000 , 26, &nowSeq, bpm );
	speaker_on2( pitch *REST , 8.000000 , 27, &nowSeq, bpm );
	speaker_on2( pitch *C_5 , 8.000000 , 28, &nowSeq, bpm );
	speaker_on2( pitch *REST , 8.000000 , 29, &nowSeq, bpm );
	speaker_on2( pitch *F_4 , 8.000000 , 30, &nowSeq, bpm );
	speaker_on2( pitch *REST , 8.000000 , 31, &nowSeq, bpm );
	speaker_on2( pitch *D_4 , 4.000000 , 32, &nowSeq, bpm );
	speaker_on2( pitch *Bb_4 , 4.000000 , 33, &nowSeq, bpm );
	speaker_on2( pitch *A_4 , 4.000000 , 34, &nowSeq, bpm );
	speaker_on2( pitch *G_4 , 4.000000 , 35, &nowSeq, bpm );
	speaker_on2( pitch *F_4 , 8.000000 , 36, &nowSeq, bpm );
	speaker_on2( pitch *F_3 , 16.000000 , 37, &nowSeq, bpm );
	speaker_on2( pitch *REST , 16.000000 , 38, &nowSeq, bpm );
	speaker_on2( pitch *E_3 , 16.000000 , 39, &nowSeq, bpm );
	speaker_on2( pitch *REST , 16.000000 , 40, &nowSeq, bpm );
	speaker_on2( pitch *E_3 , 16.000000 , 41, &nowSeq, bpm );
	speaker_on2( pitch *E_3 , 16.000000 , 42, &nowSeq, bpm );
	speaker_on2( pitch *Eb_3 , 16.000000 , 43, &nowSeq, bpm );
	speaker_on2( pitch *REST , 16.000000 , 44, &nowSeq, bpm );
	speaker_on2( pitch *Eb_3 , 16.000000 , 45, &nowSeq, bpm );
	speaker_on2( pitch *Eb_3 , 16.000000 , 46, &nowSeq, bpm );
	speaker_on2( pitch *D_3 , 16.000000 , 47, &nowSeq, bpm );
	speaker_on2( pitch *D_3 , 16.000000 , 48, &nowSeq, bpm );
	speaker_on2( pitch *D_3 , 16.000000 , 49, &nowSeq, bpm );
	speaker_on2( pitch *D_3 , 16.000000 , 50, &nowSeq, bpm );
	speaker_on2( pitch *Db_3 , 16.000000 , 51, &nowSeq, bpm );
	speaker_on2( pitch *REST , 16.000000 , 52, &nowSeq, bpm );
	speaker_on2( pitch *Db_3 , 16.000000 , 53, &nowSeq, bpm );
	speaker_on2( pitch *REST , 16.000000 , 54, &nowSeq, bpm );
	speaker_on2( pitch *C_3 , 16.000000 , 55, &nowSeq, bpm );
	speaker_on2( pitch *REST , 16.000000 , 56, &nowSeq, bpm );
	speaker_on2( pitch *C_3 , 16.000000 , 57, &nowSeq, bpm );
	speaker_on2( pitch *C_3 , 16.000000 , 58, &nowSeq, bpm );
	speaker_on2( pitch *B_2 , 16.000000 , 59, &nowSeq, bpm );
	speaker_on2( pitch *REST , 16.000000 , 60, &nowSeq, bpm );
	speaker_on2( pitch *B_2 , 16.000000 , 61, &nowSeq, bpm );
	speaker_on2( pitch *B_2 , 16.000000 , 62, &nowSeq, bpm );
	speaker_on2( pitch *C_3 , 16.000000 , 63, &nowSeq, bpm );
	speaker_on2( pitch *Db_3 , 16.000000 , 64, &nowSeq, bpm );
	speaker_on2( pitch *D_3 , 16.000000 , 65, &nowSeq, bpm );
	speaker_on2( pitch *Eb_3 , 16.000000 , 66, &nowSeq, bpm );
	speaker_on2( pitch *F_3 , 16.000000 , 67, &nowSeq, bpm );
	speaker_on2( pitch *REST , 16.000000 , 68, &nowSeq, bpm );
	speaker_on2( pitch *F_3 , 16.000000 , 69, &nowSeq, bpm );
	speaker_on2( pitch *REST , 16.000000 , 70, &nowSeq, bpm );
	speaker_on2( pitch *E_3 , 16.000000 , 71, &nowSeq, bpm );
	speaker_on2( pitch *REST , 16.000000 , 72, &nowSeq, bpm );
	speaker_on2( pitch *E_3 , 16.000000 , 73, &nowSeq, bpm );
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
	speaker_on( pitch *D_6 , 6.000000, bpm );
	speaker_on( pitch *E_6 , 12.000000, bpm );
	speaker_on( pitch *C_6 , 4.000000, bpm );
	speaker_on( pitch *C_7 , 12.000000, bpm );
	speaker_on( pitch *REST , 1.500000, bpm );
	speaker_on( pitch *C_6 , 4.000000, bpm );
}

void miss_melody(int bpm, int pitch) {
	speaker_on(pitch * C_6, 12.000000, bpm);
	speaker_on(pitch * REST, 12.000000, bpm);
	speaker_on(pitch * B_5, 12.000000, bpm);
	speaker_on(pitch * Bb_5, 12.000000, bpm);
	speaker_on(pitch * REST, 12.000000, bpm);
	speaker_on(pitch * A_5, 12.000000, bpm);
	speaker_on(pitch * Ab_5, 12.000000, bpm);
	speaker_on(pitch * REST, 12.000000, bpm);
	speaker_on(pitch * Eb_5, 4.000000, bpm);
	speaker_on(pitch * Ab_5, 12.000000, bpm);
	speaker_on(pitch * G_5, 12.000000, bpm);
	speaker_on(pitch * REST, 2.526316, bpm);
	speaker_on(pitch * Gb_6, 48.000000, bpm);
	speaker_on(pitch * G_6, 10.666667, bpm);
	speaker_on(pitch * REST, 0.581818, bpm);
}

void JimRSini_melody(int bpm, int pitch) {
	speaker_on(pitch * C_6, 16.000000, bpm);
	speaker_on(pitch * B_5, 16.000000, bpm);
	speaker_on(pitch * Bb_5, 16.000000, bpm);
	speaker_on(pitch * A_5, 16.000000, bpm);
	speaker_on(pitch * Ab_5, 16.000000, bpm);
	speaker_on(pitch * G_5, 16.000000, bpm);
	speaker_on(pitch * Gb_5, 16.000000, bpm);
	speaker_on(pitch * F_5, 16.000000, bpm);
	speaker_on(pitch * Ab_5, 16.000000, bpm);
	speaker_on(pitch * G_5, 16.000000, bpm);
	speaker_on(pitch * Gb_5, 16.000000, bpm);
	speaker_on(pitch * F_5, 16.000000, bpm);
	speaker_on(pitch * E_5, 16.000000, bpm);
	speaker_on(pitch * Eb_5, 16.000000, bpm);
	speaker_on(pitch * D_5, 16.000000, bpm);
	speaker_on(pitch * Db_5, 16.000000, bpm);
	speaker_on(pitch * E_5, 16.000000, bpm);
	speaker_on(pitch * Eb_5, 16.000000, bpm);
	speaker_on(pitch * D_5, 16.000000, bpm);
	speaker_on(pitch * Db_5, 16.000000, bpm);
	speaker_on(pitch * C_5, 16.000000, bpm);
	speaker_on(pitch * B_4, 16.000000, bpm);
	speaker_on(pitch * Bb_4, 16.000000, bpm);
	speaker_on(pitch * A_4, 16.000000, bpm);
	speaker_on(pitch * C_5, 16.000000, bpm);
	speaker_on(pitch * B_4, 16.000000, bpm);
	speaker_on(pitch * Bb_4, 16.000000, bpm);
	speaker_on(pitch * A_4, 16.000000, bpm);
	speaker_on(pitch * Bb_4, 16.000000, bpm);
	speaker_on(pitch * A_4, 16.000000, bpm);
	speaker_on(pitch * Bb_4, 16.000000, bpm);
	speaker_on(pitch * B_4, 16.000000, bpm);
}

void green_melody(int bpm, int pitch) {
	static int nowSeq = 1;
	static int stflag = 0;
	if (stflag == 0) {
		stflag = 1;
		g_cnt2 = 0;
	}
	/*MIDI*/
	speaker_on2( pitch *G_3 , 24.000000 , 1, &nowSeq, bpm );
	speaker_on2( pitch *REST , 48.000000 , 2, &nowSeq, bpm );
	speaker_on2( pitch *G_3 , 16.000000 , 3, &nowSeq, bpm );
	speaker_on2( pitch *REST , 16.000000 , 4, &nowSeq, bpm );
	speaker_on2( pitch *G_3 , 24.000000 , 5, &nowSeq, bpm );
	speaker_on2( pitch *REST , 48.000000 , 6, &nowSeq, bpm );
	speaker_on2( pitch *G_3 , 16.000000 , 7, &nowSeq, bpm );
	speaker_on2( pitch *REST , 16.000000 , 8, &nowSeq, bpm );
	speaker_on2( pitch *G_3 , 16.000000 , 9, &nowSeq, bpm );
	speaker_on2( pitch *REST , 16.000000 , 10, &nowSeq, bpm );
	speaker_on2( pitch *G_3 , 12.000000 , 11, &nowSeq, bpm );
	speaker_on2( pitch *REST , 24.000000 , 12, &nowSeq, bpm );
	speaker_on2( pitch *G_4 , 24.000000 , 13, &nowSeq, bpm );
	speaker_on2( pitch *REST , 48.000000 , 14, &nowSeq, bpm );
	speaker_on2( pitch *G_4 , 24.000000 , 15, &nowSeq, bpm );
	speaker_on2( pitch *REST , 48.000000 , 16, &nowSeq, bpm );
	speaker_on2( pitch *G_4 , 16.000000 , 17, &nowSeq, bpm );
	speaker_on2( pitch *REST , 16.000000 , 18, &nowSeq, bpm );
	speaker_on2( pitch *G_3 , 19.200001 , 19, &nowSeq, bpm );
	speaker_on2( pitch *REST , 96.000000 , 20, &nowSeq, bpm );
	speaker_on2( pitch *A_3 , 19.200001 , 21, &nowSeq, bpm );
	speaker_on2( pitch *REST , 96.000000 , 22, &nowSeq, bpm );
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
	speaker_on2( pitch *F_5 , 4.000000 , 192, &nowSeq, bpm );
	speaker_on2( pitch *C_6 , 2.000000 , 193, &nowSeq, bpm );
	speaker_on2( pitch *E_5 , 5.333333 , 194, &nowSeq, bpm );
	speaker_on2( pitch *G_5 , 5.333333 , 195, &nowSeq, bpm );
	speaker_on2( pitch *C_6 , 2.666667 , 196, &nowSeq, bpm );
	speaker_on2( pitch *Bb_5 , 16.000000 , 197, &nowSeq, bpm );
	speaker_on2( pitch *Ab_5 , 16.000000 , 198, &nowSeq, bpm );
	speaker_on2( pitch *G_5 , 5.333333 , 199, &nowSeq, bpm );
	speaker_on2( pitch *F_5 , 5.333333 , 200, &nowSeq, bpm );
	speaker_on2( pitch *G_5 , 8.000000 , 201, &nowSeq, bpm );
	speaker_on2( pitch *Bb_5 , 2.666667 , 202, &nowSeq, bpm );
	speaker_on2( pitch *Ab_5 , 16.000000 , 203, &nowSeq, bpm );
	speaker_on2( pitch *G_5 , 16.000000 , 204, &nowSeq, bpm );
	speaker_on2( pitch *F_5 , 5.333333 , 205, &nowSeq, bpm );
	speaker_on2( pitch *Eb_5 , 5.333333 , 206, &nowSeq, bpm );
	speaker_on2( pitch *F_5 , 8.000000 , 207, &nowSeq, bpm );
	speaker_on2( pitch *D_5 , 5.333333 , 208, &nowSeq, bpm );
	speaker_on2( pitch *G_5 , 16.000000 , 209, &nowSeq, bpm );
	speaker_on2( pitch *G_5 , 1.454545 , 210, &nowSeq, bpm );
	speaker_on2( pitch *Bb_4 , 8.000000 , 211, &nowSeq, bpm );
	speaker_on2( pitch *G_4 , 8.000000 , 212, &nowSeq, bpm );
	speaker_on2( pitch *REST , 8.000000 , 213, &nowSeq, bpm );
	speaker_on2( pitch *Bb_4 , 8.000000 , 214, &nowSeq, bpm );
	speaker_on2( pitch *G_4 , 8.000000 , 215, &nowSeq, bpm );

}

void gotiusa_melody(int bpm, int pitch) {
	speaker_on(Eb_4 * pitch, 16, bpm);	//こ
	speaker_on(REST * pitch, 16, bpm);
	speaker_on(A_4 * pitch, 16, bpm); //こ
	speaker_on(REST * pitch, 16, bpm);
	speaker_on(B_4 * pitch, 16, bpm); //ろ
	speaker_on(REST * pitch, 16, bpm);
	speaker_on(Db_5 * pitch, 8, bpm); //ぴょん
	speaker_on(REST * pitch, 8, bpm);
	speaker_on(Db_5 * pitch, 8, bpm); //ぴょん
	speaker_on(REST * pitch, 8, bpm);
	speaker_on(Db_5 * pitch, 16, bpm);
	speaker_on(REST * pitch, 16, bpm);
	speaker_on(Db_5 * pitch, 8, bpm);
	speaker_on(REST * pitch, 8, bpm);
	speaker_on(B_4 * pitch, 8, bpm);
	speaker_on(REST * pitch, 8, bpm);
	speaker_on(B_4 * pitch, 16, bpm);
	speaker_on(REST * pitch, 16, bpm);
	speaker_on(A_4 * pitch, 8, bpm);
	speaker_on(REST * pitch, 8, bpm);
	speaker_on(Ab_4 * pitch, 16, bpm);
	speaker_on(REST * pitch, 16, bpm);
	speaker_on(A_4 * pitch, 16, bpm);
	speaker_on(REST * pitch, 16, bpm);
	speaker_on(Ab_4 * pitch, 16, bpm);
	speaker_on(REST * pitch, 16, bpm);
	speaker_on(Gb_4 * pitch, 16, bpm);
	speaker_on(REST * pitch, 16, bpm);
	speaker_on(E_4 * pitch, 8, bpm);
	speaker_on(REST * pitch, 8, bpm);
	speaker_on(B_4 * pitch, 8, bpm);
	speaker_on(REST * pitch, 8, bpm);
	speaker_on(E_4 * pitch, 8, bpm);
	speaker_on(REST * pitch, 4, bpm);
	speaker_on(B_4 * pitch, 4, bpm);
	speaker_on(Db_4 * pitch, 16, bpm);
	speaker_on(REST * pitch, 16, bpm);
	speaker_on(B_4 * pitch, 16, bpm);
	speaker_on(REST * pitch, 16, bpm);
	speaker_on(A_4 * pitch, 16, bpm);
	speaker_on(REST * pitch, 16, bpm);
	speaker_on(Ab_4 * pitch, 16, bpm);
	speaker_on(Ab_4 * pitch, 16, bpm);
}
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
