AYATAKA-WORKs/AliCe/Src/AliCe/src/initNonExistentPort.h

/*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
 * Copyright (C) 2014 Renesas Electronics Corporation. All rights reserved.
 *******************************************************************************/
/*******************************************************************************
 * System Name  : RX63N initialization example
 * File Name    : r_init_non_existent_port.h
 * Version      : Ver 1.10
 * Device       : R5F563NBDDFC(RX63N Group)
 * Abstract     : Example of non-existent port initialization for RX63N
 * Tool-Chain   : High-performance Embedded Workshop (Version 4.09.01.007)
 *              : C/C++ Compiler Package for RX Family (V.1.02 Release 01)
 * OS           : not use
 * H/W Platform : Renesas Starter Kit for RX63N
 * Description  : Initialization of non-existent ports.
 * Limitation   : none
 *******************************************************************************/
/*******************************************************************************
 * History      : DD.MM.YYYY Version  Description
 *              : 01.04.2013 1.00     First Release
 *              : 02.09.2013 1.01     64-pin and 48-pin added
 *              : 06.01.2014 1.10     Change File Header
 *******************************************************************************/

/* Guards against multiple inclusion */
#ifndef R_INIT_NON_EXISTENT_PORT_H 
#define R_INIT_NON_EXISTENT_PORT_H 

/******************************************************************************
 Macro definitions
 ******************************************************************************/
#define PIN_SIZE 64

#if (PIN_SIZE == 177) || (PIN_SIZE == 176) 
#define DEF_P0PDR         (0x00)       /* non-existent pin: none */
#define DEF_P1PDR         (0x00)       /* non-existent pin: none */
#define DEF_P2PDR         (0x00)       /* non-existent pin: none */
#define DEF_P3PDR         (0x00)       /* non-existent pin: none */
#define DEF_P4PDR         (0x00)       /* non-existent pin: none */
#define DEF_P5PDR         (0x00)       /* non-existent pin: none */
#define DEF_P6PDR         (0x00)       /* non-existent pin: none */
#define DEF_P7PDR         (0x00)       /* non-existent pin: none */
#define DEF_P8PDR         (0x00)       /* non-existent pin: none */
#define DEF_P9PDR         (0x00)       /* non-existent pin: none */
#define DEF_PAPDR         (0x00)       /* non-existent pin: none */
#define DEF_PBPDR         (0x00)       /* non-existent pin: none */
#define DEF_PCPDR         (0x00)       /* non-existent pin: none */
#define DEF_PDPDR         (0x00)       /* non-existent pin: none */
#define DEF_PEPDR         (0x00)       /* non-existent pin: none */
#define DEF_PFPDR         (0x00)       /* non-existent pin: none */
#define DEF_PGPDR         (0x00)       /* non-existent pin: none */
#define DEF_PJPDR         (0x00)       /* non-existent pin: none */

#elif (PIN_SIZE == 145) || (PIN_SIZE == 144) 
#define DEF_P0PDR         (0x00)       /* non-existent pin: none */
#define DEF_P1PDR         (0x03)       /* non-existent pin: P10, P11 */
#define DEF_P2PDR         (0x00)       /* non-existent pin: none */
#define DEF_P3PDR         (0x00)       /* non-existent pin: none */
#define DEF_P4PDR         (0x00)       /* non-existent pin: none */
#define DEF_P5PDR         (0x80)       /* non-existent pin: P57 */
#define DEF_P6PDR         (0x00)       /* non-existent pin: none */
#define DEF_P7PDR         (0x00)       /* non-existent pin: none */
#define DEF_P8PDR         (0x30)       /* non-existent pin: P84, P85 */
#define DEF_P9PDR         (0xF0)       /* non-existent pin: P94 to P97 */
#define DEF_PAPDR         (0x00)       /* non-existent pin: none */
#define DEF_PBPDR         (0x00)       /* non-existent pin: none */
#define DEF_PCPDR         (0x00)       /* non-existent pin: none */
#define DEF_PDPDR         (0x00)       /* non-existent pin: none */
#define DEF_PEPDR         (0x00)       /* non-existent pin: none */
#define DEF_PFPDR         (0x1F)       /* non-existent pin: PF0 to PF4 */
#define DEF_PGPDR         (0xFF)       /* non-existent pin: PG0 to PG7 */
#define DEF_PJPDR         (0x00)       /* non-existent pin: none */

#elif PIN_SIZE == 100 
#define DEF_P0PDR         (0x0F)       /* non-existent pin: P00 to P03 */
#define DEF_P1PDR         (0x03)       /* non-existent pin: P10, P11 */
#define DEF_P2PDR         (0x00)       /* non-existent pin: none */
#define DEF_P3PDR         (0x00)       /* non-existent pin: none */
#define DEF_P4PDR         (0x00)       /* non-existent pin: none */
#define DEF_P5PDR         (0xC0)       /* non-existent pin: P56, P57 */
#define DEF_P6PDR         (0xFF)       /* non-existent pin: P60 to P67 */
#define DEF_P7PDR         (0xFF)       /* non-existent pin: P70 to P77 */
#define DEF_P8PDR         (0xFF)       /* non-existent pin: P80 to P87 */
#define DEF_P9PDR         (0xFF)       /* non-existent pin: P90 to P97 */
#define DEF_PAPDR         (0x00)       /* non-existent pin: none */
#define DEF_PBPDR         (0x00)       /* non-existent pin: none */
#define DEF_PCPDR         (0x00)       /* non-existent pin: none */
#define DEF_PDPDR         (0x00)       /* non-existent pin: none */
#define DEF_PEPDR         (0x00)       /* non-existent pin: none */
#define DEF_PFPDR         (0x3F)       /* non-existent pin: PF0 to PF5 */
#define DEF_PGPDR         (0xFF)       /* non-existent pin: PG0 to PG7 */
#define DEF_PJPDR         (0x20)       /* non-existent pin: PJ5 */

#elif PIN_SIZE == 64 
#define DEF_P0PDR         (0x8F)       /* non-existent pin: P00 to P03, P07 */
#define DEF_P1PDR         (0x0F)       /* non-existent pin: P10 to P13 */
#define DEF_P2PDR         (0x3F)       /* non-existent pin: P20 to P25 */
#define DEF_P3PDR         (0x1C)       /* non-existent pin: P32 to P34 */
#define DEF_P4PDR         (0xA0)       /* non-existent pin: P45, P47 */
#define DEF_P5PDR         (0xCF)       /* non-existent pin: P50 to P53, P56, P57 */
#define DEF_P6PDR         (0xFF)       /* non-existent pin: P60 to P67 */
#define DEF_P7PDR         (0xFF)       /* non-existent pin: P70 to P77 */
#define DEF_P8PDR         (0xFF)       /* non-existent pin: P80 to P87 */
#define DEF_P9PDR         (0xFF)       /* non-existent pin: P90 to P97 */
#define DEF_PAPDR         (0xA4)       /* non-existent pin: PA2, PA5, PA7 */
#define DEF_PBPDR         (0x14)       /* non-existent pin: PB2, PB4 */
#define DEF_PCPDR         (0x03)       /* non-existent pin: PC0, PC1 */
#define DEF_PDPDR         (0xFF)       /* non-existent pin: PD0 to PD7 */
#define DEF_PEPDR         (0xC0)       /* non-existent pin: PE6, PE7 */
#define DEF_PFPDR         (0x3F)       /* non-existent pin: PF0 to PF5 */
#define DEF_PGPDR         (0xFF)       /* non-existent pin: PG0 to PG7 */
#define DEF_PJPDR         (0x28)       /* non-existent pin: PJ3, PJ5 */

#elif PIN_SIZE == 48 
#define DEF_P0PDR         (0xAF)       /* non-existent pin: P00 to P03, P05, P07 */
#define DEF_P1PDR         (0x0F)       /* non-existent pin: P10 to P13 */
#define DEF_P2PDR         (0x3F)       /* non-existent pin: P20 to P25 */
#define DEF_P3PDR         (0x1C)       /* non-existent pin: P32 to P34 */
#define DEF_P4PDR         (0xB8)       /* non-existent pin: P43 to P45, P47 */
#define DEF_P5PDR         (0xFF)       /* non-existent pin: P50 to P57 */
#define DEF_P6PDR         (0xFF)       /* non-existent pin: P60 to P67 */
#define DEF_P7PDR         (0xFF)       /* non-existent pin: P70 to P77 */
#define DEF_P8PDR         (0xFF)       /* non-existent pin: P80 to P87 */
#define DEF_P9PDR         (0xFF)       /* non-existent pin: P90 to P97 */
#define DEF_PAPDR         (0xA5)       /* non-existent pin: PA0, PA2, PA5, PA7 */
#define DEF_PBPDR         (0xD4)       /* non-existent pin: PB2, PB4, PB6, PB7 */
#define DEF_PCPDR         (0x0F)       /* non-existent pin: PC0 to PC3 */
#define DEF_PDPDR         (0xFF)       /* non-existent pin: PD0 to PD7 */
#define DEF_PEPDR         (0xE1)       /* non-existent pin: PE0, PE5 to PE7 */
#define DEF_PFPDR         (0x3F)       /* non-existent pin: PF0 to PF5 */
#define DEF_PGPDR         (0xFF)       /* non-existent pin: PG0 to PG7 */
#define DEF_PJPDR         (0x28)       /* non-existent pin: PJ3, PJ5 */

#else
#endif

/*******************************************************************************
 Exported global variables and functions (to be accessed by other files)
 *******************************************************************************/
class initNonExistentPort {
public:
	static void setNonExistentPort(void);
};

#endif /* R_INIT_NON_EXISTENT_PORT_H */

/* End of File */
