AYATAKA-WORKs/AliCe/Src/AliCe/src/var.h

#ifndef VAR_H_
#define VAR_H_

#include "run.h"
#include "Maze.h"
#include "Log.h"

extern float g_rpm_L;
extern float g_rpm_R;
extern Run mouse;
extern Maze maze;
extern Log log01;
//extern Gyro gyro;
#endif /* VAR_H_ */
