AYATAKA-WORKs/AliCe/(commit log)

2018-06-24 edit PID
    [Control.obj]
2018-09-11 edit param
    [AliCe.obj, Control.obj, Encoder.obj, Log.obj, Maze.obj, Motor.obj, PhotoSensor.obj, Serial.obj]
2018-10-01 edit fixdis
    [AliCe.obj, Control.obj, Encoder.obj, Log.obj, Maze.obj, Motor.obj, PhotoSensor.obj, Serial.obj]
2018-10-13 edit tier
    [AliCe.obj, Control.obj, Encoder.obj, Log.obj, Maze.obj, Motor.obj, PhotoSensor.obj, Serial.obj]
2018-12-05 1.5m/sターンを追加&ターンの後ろ距離の壁制御を修正
    [AliCe.obj, Control.obj, Encoder.obj, Log.obj, Maze.obj, Motor.obj, PhotoSensor.obj, Serial.obj]
